CapnBry/HeaterMeter/eagle/readme.txt

KiCad Files for HeaterMeter PCBs
Base - HeaterMeter Base Board (v4.3.5)
LCD - HeaterMeter v4.3 LCD and Button backpack board (v4.3.5)

-- Obsolete EAGLE files or of Limited Purpose --
HeaterMeterPI.brd / sch / png - HeaterMeter v4 board and schematic for standalone or RaspberryPi (up to v4.3.4)
HeaterMeterLCD.brd / sch / png - HeaterMeter v4.3 LCD and Button backpack board (up to v4.3.4)
RfAddon.brd / sch - HeaterMeter v4.2.4 RF addon board needed if lmremote / IT+ reception is desired
LMRemote.sch - Example RF Remote probe transmitter schematic (not used in v4.3)
