CapnBry/HeaterMeter/openwrt/package/8192cu/README

This is a custom OpenWrt package for the rtl8192cu wireless adapter.

Tested models:
Edimax EW-7811Un
Rosewill RNX-MiniN2

Patches are based on the v3.4.3_4369 driver source from realtek.
