CapnBry/HeaterMeter/arduino/SMUSHI/images/background.png

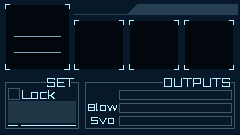
arduino/SMUSHI/images/background.png
