CapnBry/HeaterMeter/eagle/HeaterMeterLCD.png

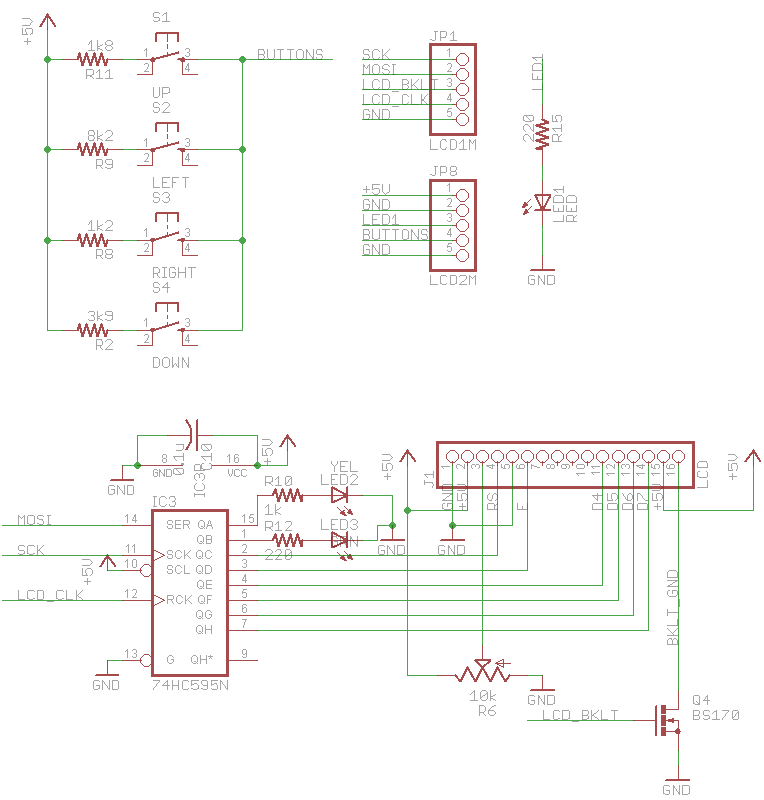
eagle/HeaterMeterLCD.png
