CapnBry/HeaterMeter/eagle/HeaterMeterPI.png

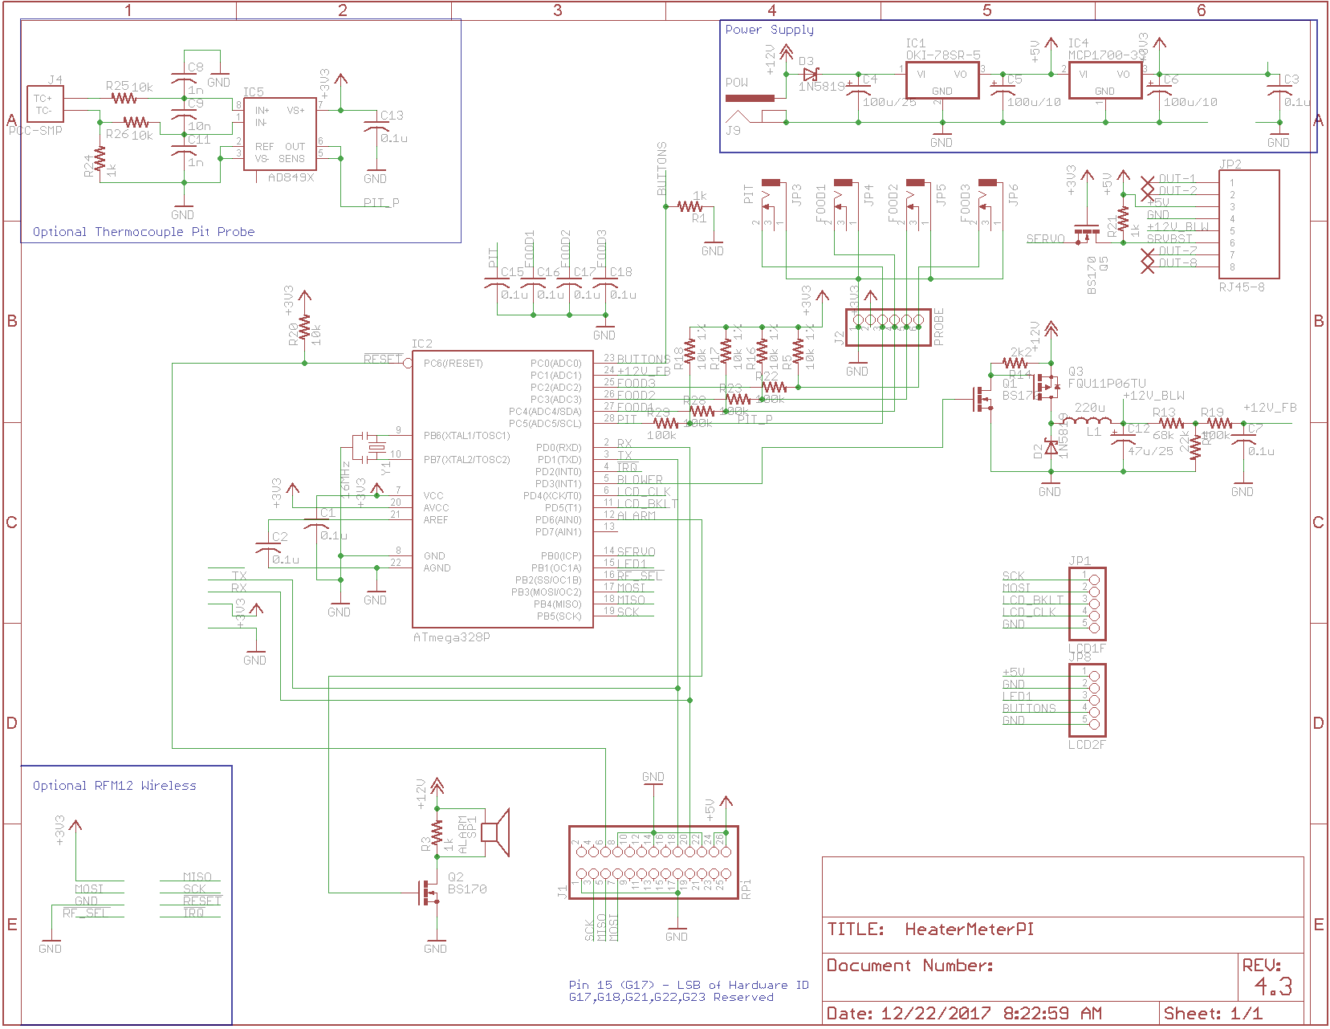
eagle/HeaterMeterPI.png
