CapnBry/HeaterMeter/eagle/LMRemote.png

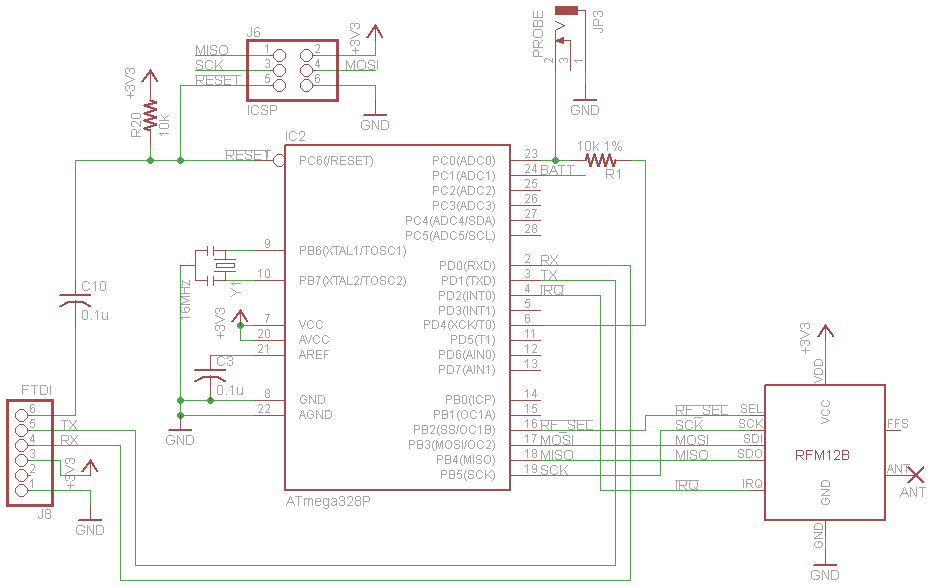
eagle/LMRemote.png
