CapnBry/HeaterMeter/openwrt/package/linkmeter/htdocs/luci-static/resources/boxy-color.png

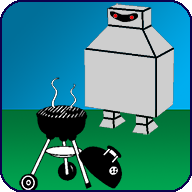
openwrt/package/linkmeter/htdocs/luci-static/resources/boxy-color.png
