CapnBry/HeaterMeter/openwrt/package/linkmeter/htdocs/luci-static/resources/fire.png

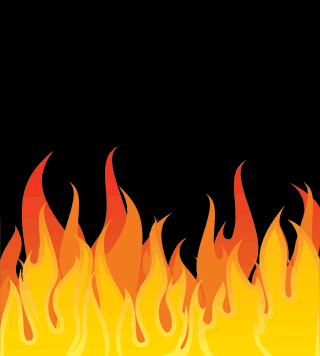
openwrt/package/linkmeter/htdocs/luci-static/resources/fire.png
