CapnBry/HeaterMeter/(threads)

Thread 14 (2015-03-02):

Switch not available

mcrabb, 2015-03-02:
The 4-way button listed in the Mouser kit, ALPS SKQUAAA010, has been discontinued and is no longer stocked at Mouser.  The recommended replacement part is 2.5mm smaller and has no prongs for mounting.  The only other place online that I've been able to find the original in the US (Newark seems to be having issues with their website so I can't check there) is onlinecomponents.com and they have a $30 order minimum.

Closed 2016-01-11.

Thread 15 (2015-06-11):

NEW fan door

marcoemanuelecocco, 2015-06-11:
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

I've find a new metod to use the fan without barrel.

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

marcoemanuelecocco, 2015-06-11:
capsula_1.01.sldprt
download the object and rename as above
https://cloud.githubusercontent.com/assets/12845292/8107309/ab2046cc-1048-11e5-82f5-0d0578ec82c9.jpg

capsula_1 01 stl
download the object and rename as above
https://cloud.githubusercontent.com/assets/12845292/8107395/21901918-1049-11e5-8d4b-a9d55baa481d.jpg

CapnBry, 2016-01-18:
Looks neat but this is better posted at the user forums
http://tvwbb.com/forumdisplay.php?85-HeaterMeter-DIY-BBQ-Controller

Closed 2016-01-18.

Thread 16 (2015-09-09):

What's the point of the 100k resistors between analog inputs and voltage divider circuits?

bgentry, 2015-09-09:
Hi there,

I apologize in advance for using Issues as a way to ask this question.

I've been learning a lot from HeaterMeter and I'm working on designing my own thermistor sensor board. I noticed that in the v4.2 hardware design, a set of 100k resistors was added between the microcontroller's analog inputs and the standard thermistor voltage dividers.

I've spent a lot of time searching for find some kind of explanation for this kind of circuit design, but all I can find are examples of the simple voltage divider design that was used prior to hardware version 4.2.

Can you explain why these resistors were added and what they do for the circuit?

Thanks!

shmick, 2015-09-09:
The 100k resistors are the R in the RC filter. The 4 x 0.1u caps are the C in the RC filter.

Take a look at the schematic here http://capnbry.net/linkmeter/pcb/hm-4.2/HeaterMeterPi.png

The caps are shown right above IC2 in the schematic.

bgentry, 2015-09-09:
@shmick thanks, I had forgotten about those :)

Closed 2015-09-09.

Thread 25 (2015-12-02):

Is there support for Pellet auger

mvogt99, 2015-12-02:
I looked at https://github.com/CapnBry/HeaterMeter/wiki/Blower-and-Servo-Wiring and am wondering if the Servo mentioned was intended to control a Pellet auger? ... or how support for an auger (including into the PID functionality) could be added?

CapnBry, 2015-12-02:
Nope, that's actually something completely different. The pellet auger is either a stepper motor (i.e. the controller sends a single pulse to advance the auger X degrees) or a geared motor (i.e. the motor moves continuously just very slowly due to high gearing). The servo code is for driving a hobby servo, which operates by moving to a position specified by the duration of a continuous pulse. They're fundamentally different and not interchangeable.

I can't think of a way HeaterMeter would control the auger but you might want to [ask on the forums](http://tvwbb.com/forumdisplay.php?85-HeaterMeter-DIY-BBQ-Controller)

mvogt99, 2015-12-02:
Thanks for the quick reply... as far as hw goes, I'm guessing something
like this might work... https://www.pololu.com/product/2755 ... just need
to incorporate it into the PID algorythm.  Btw, I believe the auger motor
is a gear motor.

I'll inquire on the forums.

Thanks again,
Mike

Mike Vogt
mvogt99@gmail.com

On Tue, Dec 1, 2015 at 9:27 PM, Bryan Mayland <notifications@github.com>
wrote:

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

Closed 2015-12-02.

Thread 35 (2016-10-08):

wifi config persistent?

Jennnifers, 2016-10-08:
Is there a way to make the wifi settings persistent after boot?

I followed the instructions here:  https://github.com/CapnBry/HeaterMeter/wiki/HeaterMeter-4.x-Software

I can connect to my wifi by editing the config file every time I boot, but I'm looking for a persistent wifi configuration.

I've been through the "Wireless Client Setup via Web Config step-by-step" multiple times but the config never sticks there either.

CapnBry, 2016-10-08:
The configuration should persist between reboots, This generally indicates that there is a problem writing to the SD card in general, and no information is being saved permanently. You should check under Status -> Kernel Log in the webui and see if you're getting errors at the bottom about "ext4", "extfs", "mmc0", or the like which are causing the filesystem to be "remounted read-only". If you are then you can try re-imaging the SD card to see if it goes away, or trying a different SD card which might be more compatible with the Pi, they are somewhat finicky.

If you need more assistance, I'd recommend creating a thread on [the forums](http://tvwbb.com/forumdisplay.php?85-HeaterMeter-DIY-BBQ-Controller).

ChinookTx, 2017-04-22:
I'm having the same problem as @Jennnifers.  I have so far tried 3 micro SD Cards of various sizes, 2 different ways of programming the cards (from linux and MacOS).   Further to this, I have tried a Pi A+ and a Pi Zero.  I cannot get ANY to keep their settings.  This sounds to me like more than a simple glitch with SD Cards??

Jennnifers, 2017-04-23:
I never did solve the problem.

In fact, now it won't stay connected to wifi for more than a second or two after reconfiguring it.

I've gone through 4 SD cards, 2 usb wifi adapters in the heater meter, and 3 different wifi routers.  Pretty sure it's not a hardware problem at this point.

CapnBry, 2017-04-23:
I can't conceive how this could possibly happen if the configuration changes are applied. Undoing configuration would be a ridiculously complicated challenge if I wanted to do it on purpose because changing the configuration is destructive, there is no backup kept once you hit "Save and Apply". Did you ever look in the kernel log for any indicators that the filesystem was experiencing errors?

>  You should check under Status -> Kernel Log in the webui and see if you're getting errors at the bottom about "ext4", "extfs", "mmc0", or the like which are causing the filesystem to be "remounted read-only".

You can also try [downloading a preconfigured snapshot image](https://heatermeter.com/dl/) with your wifi settings baked in, which may work around the issues you're experiencing, but I don't know how I'd even make HeaterMeter do what you're experiencing if I tried.

ChinookTx, 2017-04-23:
I can confirm I wasn't getting any unexpected messages about the sd card in the kernel logs.

I gave a try to the preconfigured image... It worked on the first try on my Pi A+ (which I never got to work previously).  Now I'm really scratching my head.

CapnBry, 2017-04-24:
You and me both! Like I've said, I know a whole bunch about the underlying systems and really can't put together how it is possible to *not* save the network settings across reboots. Great to hear the preconfigured image works though!

ChinookTx, 2017-04-24:
Another odd thing I notice.  The one "normal" image I got to work on my Pi Zero gives me really bad network performance:

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

The one you suggested with burned in settings gives proper ping times:

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

Images appear to be based on different OpenWRT releases, so I suspect something has changed in the firmware that makes it behave better.

Anyway, it works for me now, so unless you want me to try something specific, I'll leave it alone.  More smoking, less tweaking ;-)

CapnBry, 2017-04-30:
I was doing some testing with the old software today and the wifi configuration would reset on every reboot, After some digging I remembered I fixed this issue a while back in the snapshot. What is happening in my case was there was no HeaterMeter board attached so the initialization of the linkmeter package would never complete successfully on boot so OpenWrt would run the initialization again on the next bootup which would reset the wifi back to default. This would also be the case if a HeaterMeter board was attached but not functional, most the network settings would reset each boot until a HeaterMeter was found.

This is fixed in the snapshot firmware, and maybe that's what you folks were seeing? The evidence is that if you ssh into the device, do `ls /etc/uci-defaults/linkmeter` and that file is there, that's it. But if you've moved on there's no reason to look into it any further.

Jennnifers, 2017-04-30:
Thanks CapnBry!  I haven't exactly moved on - I've been using it without any other issues besides the wifi connection.  Would be convenient if I didn't have to get up and go outside to check on it though. :)

I'll take a look and see if there's something wrong with the connection to the heatermeter board when I get a chance.  Wouldn't it just not work without a good connection to the board though?

If I don't see the linkmeter file, I'll try the preconfigured snapshot image solution instead.

ChinookTx, 2017-05-04:
Thanks for the reply @CapnBry.  I have some spare time today and I'll try a few scenarios.  It might just be that (not having the Heatermeter hooked up).  I initially tried to get the pi going first without the Heatermeter.  Then was a mix of having it on to try and see what IP was reported and off when getting fed up and moving to another Pi.  Rewash, repeat ;-)

Closed 2016-10-08.

Thread 36 (2016-10-10):

Other SMS Provider

technofetishism, 2016-10-10:
When selecting other SMS provider, the configuration box shows up within the email notifications section.

This behaviour is evident in the current snapshot build.

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

technofetishism, 2016-10-10:
This issue also affects configuring pushbullet

CapnBry, 2016-10-10:
I can confirm this is a bug. I've got a fix coming in the next snapshot, thank you for reporting! I'll close the issue once the fix is in git.

CapnBry, 2016-10-20:
Should be fully resolved by 339fcb108bcba8351f94f18616b5b1df51421d98 and the new snapshot release. Thanks for your report!

Closed 2016-10-20.

Thread 39 (2017-12-27):

Port to other hardware platforms

brianjmurrell, 2017-12-27:
Hi.  I have been going down the path of building a temperature controller for my Kamado smoker/grill.

I have the hardware built for a simple single probe design so far with a NodeMCU board, a Maverick probe and a randomly chosen blower.  The NodeMCU only has a single ADC, hence the single probe (at this moment).  Some additional components in the way of an ADC multiplexer could resolve that but for the moment I'd just be happy to have pit temperature control.

Your project looks like it's had a lot of time spent on the intricacies of PID implementation, etc. which I feel like I would be foolish to try to re-invent rather than "standing on the shoulders of giants" and leveraging.

Anyway, to get to the point, would PRs for porting to new hardware platforms be welcome to this project?  Would you be willing to land PRs for such alternate hardware platform ports?

CapnBry, 2017-12-27:
I'm not sure what code would be reusable between the platforms. I'm pretty familiar with the ESP8266 platform, having coded for it for a few other projects around the house. The PID algorithm itself isn't very complex, and the majority of the code in there is for handling the ADC running continuously and oversampling/decimating the readings which would not be applicable to the ESP. The on-device menuing system isn't very complex either. All the rest of the code for monitoring, recording, graphing, discovery, and notifying is handled on the Pi in a mix of different languages and systems that would not translate at all. Last I'd heard, the ESP core doesn't have hardware PWM either which would make timing difficult for the fan buck converter and servo pulses (although the LCD backlight would probably be fine in software).

There [is a project](https://github.com/nailbuster/EspressModuleHM) where someone connects the output of the HeaterMeter board to one of the cheap ESP-01 modules and pushes the data off to the cloud which is sort of the middle ground between the two.

In short, I don't think it is feasible that there would be much code reuse between the platforms and the amount of effort to make that code cross compatible would probably be so large that it wouldn't be worthwhile to spend the time on it. I do appreciate low cost and relative power of the ESP8266 modules (I actually soldered one into something yesterday) but they do fall short on requirements for this project. If you'd like to go into it in more detail, you can start a discussion [on the forums](https://tvwbb.com/forumdisplay.php?85-HeaterMeter-DIY-BBQ-Controller) and also search there for previous discussions about the ESP platform.

Closed 2017-12-27.

Thread 41 (2018-06-23):

Hacking linkmeterd

chrissnell, 2018-06-23:
Hi @CapnBry.   Just ordered my HM hardware and I'm super excited to test this.

I've been digging through the source tree with an eye on doing some hacking.  My particular interest is modifying the linkmeterd service to support other control mechanisms like [gRPC](https://grpc.io/).   I'm also not a huge fan of the tight coupling with OpenWRT and I was looking into what it would take to tease linkmeterd away from LuCi.  It appears to be pretty tightly coupled.

So, I started thinking about rewriting linkmeterd in Go, completely decoupled from any OpenWRT dependencies.  There's a couple of things that I want to better understand:

- **Architecture** - I'm trying to understand how everything communicates.  It looks like you have a web app front end that speaks JSON to the linkmeterd service running on the RPi.   This service appears to communicate over serial to the Arduino for command/control/monitoring.  There seems to be a [client](https://github.com/CapnBry/HeaterMeter/blob/master/openwrt/package/linkmeter/luasrc/lmclient.lua) that talks to linkmeterd over a UNIX socket but I'm not sure what the client does.  Are there docs somewhere that will explain how these things all fit together?

- **The linkmeterd <---> Arduino protocol**   Do you have any documentation for this anywhere.  Looking at your Lua source, it looks like [the commands are defined in `segmentMap`](https://github.com/CapnBry/HeaterMeter/blob/master/openwrt/package/linkmeter/luasrc/linkmeterd.lua#L987-L1013), but I might be confusing this with commands sent over the UNIX socket from the control utility.  Would you mind helping me grok this?

Thanks!

CapnBry, 2018-06-24:
Hi Chris! The issue tracker isn't really the place for a discussion, so after this message if you want to continue discussion, please [take it to the forums](https://tvwbb.com/forumdisplay.php?85-HeaterMeter-DIY-BBQ-Controller).

linkmeterd isn't very coupled to OpenWRT at all. It does pull in some of their libraries but those should build on any platform and it would be silly to rewrite them (luci.sys, nixio, and jsonc). It does use UCI to pull in the configuration but honestly that could all be hard coded into the source if needed. It does get more complicated if you start looking at notifications and whatnot because those rely on external linux utilities.

The thing that is tightly coupled is the HTTP interface, which runs the luci framework for generating the web pages. That would all need to be rewritten if you wanted to pry it out of OpenWRT.

The architecture is not very complicated. The atmega spits out data in serial sentences similar to GPS NMEA sentences. It can also receive commands via the keywords found in hmcore.cpp's handleCommandUrl, which are only 3: /set, /reboot, and /config (dump all config). The linkmeterd listens for those and writes them into the RRD file (and plugins and alarm notifications) and publishes them to any connected clients through a UNIX socket. There's lmclient which is just a utility for sending/receiving messages over the UNIX socket. The system there is simple fire-and-forget commands, or subscribe to the status updates (in JSON format).

The serial protocol is simple and segmentMap holds all the known sentences. The first group ($HMxx) are the sentences the atmega sends out, The second ($LMxx) are commands expected to be received over the UNIX socket.  The 2x commented out values are UNIX commands accepted by the plugins, and the final one is the command to register a listener which gets the JSON data streamed. All are just `COMMAND,param,param,param,...`

I don't know what your plans are if you're trying to get rid of OpenWRT, but it would probably be less work to just write a new daemon from scratch that just takes the serial data and puts it into your database of choice using the segmentMap's `$HMxx` list as the requirements for what sentences to expect from HeaterMeter. None require any responses so it is safe to just ignore what you don't want.

Closed 2018-06-24.

Thread 42 (2018-07-20):

Proportional on measurement

mattncsu, 2018-07-20:
Have you considered implementing [proportional on measurement](http://brettbeauregard.com/blog/2017/06/introducing-proportional-on-measurement/) from the [Arduino PID library](https://github.com/br3ttb/Arduino-PID-Library/blob/master/PID_v1.cpp) to reduce or eliminate overshoot since smoker temperature control is an integrating process?  It doesn't appear to be too difficult to implement, it just adds one extra term to the PID equation.

```
bool PID::Compute()
{
   if(!inAuto) return false;
   unsigned long now = millis();
   unsigned long timeChange = (now - lastTime);
   if(timeChange>=SampleTime)
   {
      /*Compute all the working error variables*/
      double input = *myInput;
      double error = *mySetpoint - input;
      double dInput = (input - lastInput);
      outputSum+= (ki * error);

      /*Add Proportional on Measurement, if P_ON_M is specified*/
      if(!pOnE) outputSum-= kp * dInput;

      if(outputSum > outMax) outputSum= outMax;
      else if(outputSum < outMin) outputSum= outMin;

      /*Add Proportional on Error, if P_ON_E is specified*/
	   double output;
      if(pOnE) output = kp * error;
      else output = 0;

      /*Compute Rest of PID Output*/
      output += outputSum - kd * dInput;

	    if(output > outMax) output = outMax;
      else if(output < outMin) output = outMin;
	    *myOutput = output;

      /*Remember some variables for next time*/
      lastInput = input;
      lastTime = now;
	    return true;
   }
   else return false;
}
```

CapnBry, 2018-07-20:
Interesting. I'll give it a try, but the major problem I see with it is that there's no (P * Error) contribution. This means if you set the setpoint to 225, and the current temp is say 80, the output will be 0% which means there will be no way to get it to 225F. It is relying on the Isum to build up to drive the output, which means the Isum will ramp up to 100% until the temperature is reached which then leaves us in the same place.

In the short example graphs shown on that webpage, it isn't a problem because the output is still ramping up when it reaches the setpoint. In a longer term test, say a sous video setup, their Isum (labeled I-term there) would reach 100% as well if the heatup time was a sufficient number of PID cycles in the future. This value is cumulatively reduced by the Derivative * P, and instantaneously reduced by Derivative * D which seems very redundant.

Still, it isn't difficult to make a test to try it out although I feel like there's a reason why you don't see this in commercial PID software-- because the D term is already there for this exact reason.

mattncsu, 2018-07-20:
The author goes into a little more detail [on this page](http://brettbeauregard.com/blog/2017/06/proportional-on-measurement-the-code/):

> Proportional on Measurement provides increasing resistance as the input changes, but without a frame of reference our performance would be a little wonky. If the PID Input is 10000 when we first turn on the controller, do we really want to start resisting with Kp*10000? No. We want to use our initial input as a reference point (line 108,) the increase or decrease resistance as the input changes from there (line 38.)

TheDogee, 2018-07-28:
I was intrigued by this as well, and from the description sounds like it would work well. Implemented a couple variations with little success. Not sure if it was a coding problem or a tuning issue, but I ran out of patience because it takes so long to test changes on the WSM. It seemed to get wound up too easily or was too ineffective. The way it is implemented in the PonM library, the P and I terms get combined which makes it tough to observe.

CapnBry, 2018-08-09:
Ooh that's a good link, I just spent the last hour reading both chapters looking for ideas. The solution presented just adjusts the setpoint further away from the current input to accelerate the integration which I don't think will help because we've already saturated the Isum at 0% (our integral lower limit is 0) and due to the `D` being in parallel, we can't remove its contribution so there's no way to fully turn off the output. One could write a special case where D is only allowed to contribute when the error is 100/D but that then messes with startup because the controller won't start backing down until it gets within that range which could cause further overshoot.

Also reading that paper, I'm not sure what the heck the Arduino PID code is doing. P on M isn't integrating! PonM _should_ be instantaneous, He mentions it in his [second article](http://brettbeauregard.com/blog/2017/06/proportional-on-measurement-the-code/), in the second pass section but I can't figure out why he made that leap. P on M is supposed to guesstimate the proper output for a given setpoint so if we know ambient is 80 and our target is 225, PonM is supposed to set the output to P * (225-80). If we know it generally takes 30% power to maintain 225, we'd set `P` constant to 30 / (225-80)= 0.207. A 300 setpoint would then get 0.207 * (300-80)=45.54% output and then rely on the Isum to ramp up. It doesn't produce the same response to do PonM of 0.207*(set-start) vs 0.207+0.207+...+0.207 until you reach the same output value. For one, the integration relies on the temperature changing which it will never do if there's no change in the output. The faster the temperature changes, the faster the output will increase too. That's just nutters and contrary to what he was initially trying to achieve, which is a resistive force.

Now that I've read all this, I'm definitely going to back out the changes. While PonM is a thing, having it slowly ramp to that value relying on an external contribution to actually initiate the change is not sound and then applying it in reverse to the Isum is just baffling.

mattncsu, 2018-08-09:
Sorry it didn't work out. It seemed like a good idea reading those posts. At least we all know a little more about PID theory now...

CapnBry, 2018-08-09:
Too right we do! It was educational in that I've learned some new terms, like I didn't know what we had was an "independent gains (parallel form) proportional-on-error derivative-on-measurement" PID controller.

I also was able to find sort of a bug in the code in that the Isum could theoretically jump to a very large value of the temperature changes very rapidly but the controller isn't saturated yet. I'll keep that change. I'll also probably re-add PonM as an option in the more traditional sense, where it contributes just a straight P*setpoint so people can play with that if they like. I might also change the antiwindup code to operate always in the proportional band rather than on the last output? Not sure if that would make a mess of anything.

mattncsu, 2018-08-09:
@br3ttb Any thoughts?

CapnBry, 2018-08-11:
Well a couple dozen hours of reading and testing and yet another implementation. I've also read some papers on 2DOF PID controllers and unsurprisingly they all use a negative sign on the control variable.
[Two-Degree-of-Freedom PID Controllers by Mituhiko Araki and Hidefumi Taguchi](http://ijcas.com/admin/paper/files/401-411.pdf)
[Two-Degree-of-Freedom PID Controllers Structures by V.M. Alfaro and R. Vilanova?](https://www.springer.com/cda/content/document/cda_downloaddocument/9783319282114-c2.pdf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)

I get a bit lost reading these papers when they jump right into using `s` which I have to assume is a factor of a Laplace Transform and it has been decades since I learned how to use those. What I've got now is from the textbook you linked where they do the "linear combination of PonE and PonM" formula 2.3(27). Right now I have it hard-coded with a lambda of 0.4, but due to how it works, I am going to make it a tunable parameter as well because the same code can work with the our old style PonE (lambda 1.0), support pure PonM (lambda 0.0), or roll your own mix. I can't make it tunable just yet because there would be no UI for it (the webui needs to support it) and I can't make changes there because I'm in the throes of converting it **back** to OpenWrt from LEDE. So for now, use a negative P value to indicate you want to use this PonMonE code (but the value is inverted by the code so -1 => 1).

Because the P contribution is always negative in this configuration, the limit on the integral sum needed to be increased so the output can reach 100%. Without this, the max output would be lower the higher the setpoint is, since `I` could only contribute 100%, and at steady state, `P` is -0.2 \* setpoint \* Pconstant. Max integral sum is therefore 100%+0.6\*setpoint\*P which should allow 100% output at setpoint if needed. The lowerbound integral sum is still 0.

In bench testing, it had a pretty good setpoint response with little overshoot and a llllooooong oscillation period. The disturbance response however was not great, although it could be because I don't have optimal coefficients. In grill testing, I saw a lot of overshoot when achieving setpoint. With this system the Isum always maxes out on startup, and the P contribution is roughly constant so the controller doesn't back off quickly as it passes the setpoint. This is mitigated by a more managed approach to the setpoint due to being almost entirely controlled and limited by the `D` contribution retarding the output throughout startup.
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

In any case, I've uploaded a snapshot AVR firmware with the current code to the online repository so it can be tried out. I used P,I,D = -0.4, 0.10, 12. I am concerned with the P value being on measurement meaning that, say 400 degrees is -96%, and Isum will range from 0-196% but the D term's range is always fixed due to being on Error.

TheDogee, 2018-08-19:
I tried the snapshot for a short cook today of some poppers with my normal tuning parameters P=3,I=0.008,D=5.  I have a MicroDamper with fan on WSM 18.  I started with a half chimney of lit coals over unlit, started with fan on startup at 50% but change it eventually to 100% because it was not getting there.  I negated the first term to -3 to try PonM.  It behaved very strangely, seemed to get all wound up getting to setpoint (which took a long time, probably my fault, not enough lit?), but then as soon as it went slightly over the setpoint of 225, it abruptly went to zero and stayed there.  Temp fell so much that the lid open detect went off, and I gave up and changed the sign on P back to positive to go back to normal mode (around 7:45 on graph).  Any idea what happened here?  Is it a bug, or operator error?
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

I had the "P" window up at the time where it went to zero and both P and I had not drastically changed, but both were large.  P was around -330, I was about 230.

CapnBry, 2018-08-19:
Thanks for testing, however, you can't just invert the sign on the P value and switch to PonM. It's a whole different game and "3" is about 10x too high I think. The "I" for my test system was also 5x the PonE version, and the "D" is about 2x my normal PonE value.

It definitely is strange that it cut off roughly as it would have been getting close to starting to control though. There's definitely something weird happening there, I'll have to try your values and see if I can reproduce. Something might be overflowing internally due to the larger P than expected. Maybe try it with PID= -0.3, 0.08, 10 (which would be -1/10, 10x, 2x your PonE values).

TheDogee, 2018-08-20:
Thanks for the reply. Makes sense based on the math that my values are off. The Android pid guy had  suggested at using the same tuning values in his article, but that does not see like it will work. I will give it another go next time with more reasonable values.

TheDogee, 2018-09-02:
Here is take 2 with the parameters you suggested.  It went slightly better, but still had problems with the fan rapidly cutting out after overshoot.  What basically seems to happen in that the I term hit its positive maximum before hitting setpoint, and then once overshoot occurs, it starts decrementing rapidly.  The "D" term seems to make things worse.  The P term does almost nothing to correct.  Note that in the graph the first "lid open" was real, the next two were not.  At 12:45 I gave up and went back to PonE.
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

pokeymud, 2022-05-20:
Whew,
I just wanna shoot out a quick thanks to the discussion on this subject. I'm not a heatermeter user, but this is the only place I could find any coherent discussion on the arduino PID's proportional-on-measurement feature, and what it is /supposed/ to be doing.

As a note, the implementation in the OP is from an early version of the library, which is just plain wrong/not PonM - it seems to want to integrate the differential term to achieve a similar effect to real P on M, except when your input is higher than the set-point, the accumulation reverses. This gives that implementation the 'resistive' force characteristic that the author describes, but isn't actually P on M and doesn't behave like it!

The implementation in the current version has been fixed to to be equivalent to 'pure' P on M (lamba = 0). In fact the implementation in the blog linked already is updated with the fix, but the author continues to talk about it incorrectly as a 'resistive' force, which is a big part of my confusion on the subject!

Lastly in the spirit of accumulated knowledge, and helping out newbies like me: I found the wikipedia section on proportional and derivative action on measurement demystified the terms in the paper shared a bit because the article as a whole is self-contained and defines all the terms used in the formulae: https://en.wikipedia.org/wiki/PID_controller#Basing_proportional_action_on_PV

Thanks again!

Thread 44 (2018-08-19):

Access for historic data currently not possible because of CORS errors

iGod42, 2018-08-19:
It is currently not possible to access the /lm/hist endpoint because of CORS errors.
While the same issue is fixed with PR #43 for endpoints under /lm/api/, /lm doesn't have a setting to enable CORS.
I'm not sure if adding CORS would be correct there, it seems like the endpoint should be moved (or aliased) in /lm/api.

CapnBry, 2018-08-19:
You're right about this and #43, good catch on these. However, I noticed a couple of weeks ago that API write access doesn't work at all, which is a major blocker to fixing anything else. Are you not seeing that as well?

The problem is that luci/OpenWrt/LEDE doesn't have a spec for how the authentication scheme is supposed to work, with the only clue being in understanding how the source works. About 6 months ago (maybe more) they reorganized all the code in the dispatcher auth which prevents controllers from rolling their own session management which is how the apikey works. IIRC it (the dispatcher) is in a very weird state right now, which seemed to almost make creating your own auth impossible. I'm in the middle of updating everything back to OpenWrt since LEDE re-merged though so I can't do anything until that is done. They've included my squashfs stuff for our target but at the same time made some changes to it to make it incompatible with our current build. There's also a ton of hand testing for regressions because there literally a thousand changes between our last LEDE pull and OpenWrt HEAD.

I will take a look at this as soon as I'm done with that. (oof so much to do). I didn't initially move /lm/hist over due to the formatting, all the /lm/api stuff is JSON format only so I was planning on adding a new endpoint with the data in the right format so it won't have to be parsed on the client side any more. The API hasn't been a big priority though because there's almost nobody using it. I appreciate you finding these things though and I might have a chance to get some code time this week.

robertspari, 2018-08-19:
I haven't tried writing yet to be honest. I think I successfully placed one call in Insomnia but I might be mistaken since I initially set out to create an API that works on plain old Raspian. It could have been that too.

What I have done is have a look at the authentication logic and I'm not sure if the API key is really a great option.
Here's why. I started to create a responsive page (that might evolve to a progressive web app at some point) for two reasons. 1. I'm not the biggest fan of the Luci user experience, especially on mobile. 2. I've been supplying HeaterMeters to my friends and family, not all of which are computer-literate.
For them it would be great to have a zero-config way of just opening an app/web page that checks the local network for their unit and gives them the possibility to change the set point or other settings. For this to work though, they'd have to get the API key and supply it to the app. I haven't checked if they are randomly generated, but I assume they are, so each of them would have to do that.

Since there is no real sensitive data that we'd have to protect from being accessed, I think that basic auth, or even no auth at all, would be fine.

It sounds like you have a lot of work to go through, so for the issue at hand there's no rush at all, as I've got local workarounds. As for the authentication: If you really have to re-work stuff there maybe keep that in mind. Or if there's an easy option I'm missing, please let me know

minorOffense, 2019-05-20:
Any chance the CORS patches code can be rolled into a release? I’m building a VueJS web app to replace the stock cook UI (just reading data for now, eventually to write data and replace those pages too). I worked around it by breaking the cors security settings in Firefox. But it would help a lot if the app had the headers in place.

CapnBry, 2019-05-20:
Ah son of a... I thought I had integrated this already. I was wondering why I had left the ticket open and I thought it was just to remind me that the luci dispatcher was a bit weird and needed a new look.

Building a new snapshot right now with CORS enabled on /lm/hist and it will be up in a few minutes at https://heatermeter.com/dl/

minorOffense, 2019-05-20:
Excellent thank you very much.

Closed 2019-05-20.

Thread 45 (2018-09-04):

HeaterMeter.com is offline

TheGorf, 2018-09-04:
Can't download any of the required stuff from the heatermeter.com site because it's timing out. Should that be moved to GitHub?  [The instructions from the wiki page](https://github.com/CapnBry/HeaterMeter/wiki/HeaterMeter-4.x-Software) show that I should be going to heatermeter.com/dl to download stuff. But https://downforeveryoneorjustme.com shows the site is offline from multiple locations.  Can we get the downloads from somewhere else?

CapnBry, 2018-09-04:
Hi, thanks for reporting this. I'm not sure why, but the VPS server keeps shutting off. I've got a ticket in to support to figure out why it just shuts off randomly (not shutdown, just like powered off). It started Monday morning.

There's no other way to get the firmware. It's sort of built on the fly by the server and there's a bunch of other light processes that are part of the download and device registration so there's more than just a static file involved. It hasn't been a problem so far as the hosting service has done an amazing job with the uptime, and the volume of HeaterMeter traffic is so low that paying for redundant servers doesn't make much sense.

It has been up for over an hour now, which is a new record for this week so maybe the support people have gotten it straightened out but I haven't heard anything yet.

shmick, 2018-09-04:
Might be good to post the latest LM and HM code to https://github.com/CapnBry/HeaterMeter/releases  ?

CapnBry, 2018-09-04:
I'll consider that for the next release, yeah.

Phortieteaux, 2018-11-17:
Hi Bryan -

Looks like https://heatermeter.com/ is down again - connection is timing out.  Is there still no path to manually download / configure?

Thanks -
Jason

CapnBry, 2018-11-17:
I posted about it [on the forums](https://tvwbb.com/showthread.php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), but the system is in emergency downtime until tonight.

Phortieteaux, 2018-11-17:
Ah ok, thanks!  I was just able download the firmware directly from the static IP at https://tvwbb.com/showthread.php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, so thought it might be something with DNS.  Thanks for the quick response - and for Heatermeter...  anxious to see if I soldered everything correctly :)

CapnBry, 2018-11-17:
No worries, it looks like it just came back up a few minutes ago but I haven't gotten the all clear that the migration is complete from the host yet. Glad you were able to download the image!

Closed 2019-05-20.

Thread 47 (2019-03-24):

Export CSV metrics

hari-bo, 2019-03-24:
From the HeaterMeter BBQ Control panel you can export the CSV file.
I cannot find in the documentation how to interpret this values.
The reason I am asking this is that I want to import this data into a graph with time lapse and temperature.

For example:
```
1553424480,nan,14.45652173913,nan,nan,nan,0
1553424540,nan,12.35,nan,nan,nan,0
1553424600,nan,12.236666666667,nan,nan,nan,0
1553424660,nan,12.506666666667,nan,nan,nan,0
1553424720,nan,12.601666666667,nan,nan,nan,0
1553424780,nan,12.511666666667,nan,nan,nan,0
1553424840,nan,12.773333333333,nan,nan,nan,0
```

CapnBry, 2019-03-24:
That is a very valid question! I never realized I had forgotten to add that to the documentation (or even include a header in the CSV file apparently). I'll work on that this week when I get a chance but here's the info:

* UNIX timestamp in UTC
* Setpoint
* Probe 0 temperature (control probe)
* Probe 1 temperature
* Probe 2 temperature
* Probe 3 temperature
* PID output percent (if zero or positive), or lid cooldown remaining (if negative).

All values are the average value recorded over the time period. I see that the first field jumps by 60 each line, so you're looking at 1 minute averages. Note that there are various scales for the data depending on how long the database has been running or what scale you have selected, 10 seconds per period (1 hour of data), 60 seconds (6 hours), 120 seconds (12 hours), or 180 seconds (24 hours).

hari-bo, 2019-03-24:
Thanks! Is there an way to convert the UNIX timestamp to the lead time of the session with the Heatermeter? Because I want to run several sessions with different fuel to compare them with an graph.

CapnBry, 2019-03-25:
Just subtract the timestamp of the first row from all the others. If the data extends all the way through the selected time scale, that won't extend to the beginning of the actual session though since, for example, you're only viewing the most recent hour of data.

HeaterMeter doesn't track the time of session start in any way, so the way I do it for the graphs is to take the full scale CSV (24 hours) and look for the first line that contains an actual number (not a nan). Since we know that each line represents 180 seconds you can tell roughly when the session started from that (now - 24 hours + 180 seconds per line of nans)

CapnBry, 2019-03-26:
The new snapshot firmware includes a header line in the CSV export. The [documentation](https://github.com/CapnBry/HeaterMeter/wiki/Accessing-Raw-Data-Remotely#historical-data) has also been updated with this information. Thanks for bringing it to my attention.

Closed 2019-03-26.

Thread 48 (2019-07-18):

compatibility with MQTT server / home assistant

pilot1981, 2019-07-18:
Hi,
it's possible have temperature value in home assistant using MQTT server?

it could be useful to have all data also when you are outside house...in long time BBQ...

CapnBry, 2019-07-18:
Actually it is weird you'd bring this up, because I just talked with someone else a couple of weeks ago about streaming the data to other systems and I wondered why I didn't already have MQTT built into the HeaterMeter. It is on me todo list now, except it will be a MQTT client, not a server.

pilot1981, 2019-07-19:
thanks for reply.

it's possible to repair link to google photos in wiki section?

CapnBry, 2019-07-19:
It is non-trivial to fix them, since Google Photos doesn't allow linking photos. I've looked at trying to replace them with another image host that allows linking to photos, has albums, and will autogenerate thumbnails in arbitrary resolutions but I couldn't find one easily so figured it wasn't worth the time to stand up and maintain my own image hosting.

The photos are all still there in the new Google Photos albums, but the individual hotlinks for each photo doesn't work.

pilot1981, 2019-07-19:
Ok, thanks.

App HeaterMeter on Apple App Store is yours?

CapnBry, 2019-07-19:
I've actually not heard of that one, but it looks nice. There's also Pit Meter and Pit Droid (for Android) but I'v e not worked on any of these, they are community-created.

kaybee335, 2019-08-20:
I'll add my vote to adding an MQTT client! Now that I have just finished building my unit I was about to write a Python script to scrape that info and publish it to my MQTT broker.

CapnBry, 2019-08-20:
I was hoping to get it in this week but it needs webui to be able to configure it, upload certificates, etc, so it is a bigger project than just getting the package into the build. Also we had that whole deal with migrating to the new webhosting that sort of is still in progress so this is still on my todo list.

kaybee335, 2019-08-21:
I just got mine built yesterday so have no idea about the web hosting issues. Testing last night was amazing. Minimal overshoot after a bit of PID adjustment and stable, stable temps.

I'm in no great rush for the MQTT stuff, I still have to figure out all the stuff that is already there! I'd be happy to give my opinion on things MQTT if you are looking for beta testers.

As far as configuration, please allow the user to specify a 'root' of the topic tree that the HM topics would nest under. That would allow easy integration into topic structures that people may already have on their broker, i.e. 'myHouse/automation/outside'.

pilot1981, 2019-11-19:
any progress with MQTT client developing?

CapnBry, 2019-11-19:
Nope, not yet. This ticket will be updated when there's an update on the situation.

CapnBry, 2020-10-13:
The latest snapshot includes a MQTT client in the form of mosquitto_pub and mosquitto_sub. Publishing the streaming status is as easy just piping the output of lmclient into mosquitto_pub:
```
lmclient @LMSS,1 | mosquitto_pub -h myserver -t "heatermeter/hmstatus" -l
```

There's no webui for configuring the server or topic or MQTT login information/certificate, but it should be easy to start working with it with just the line above.

idomp, 2020-10-13:
Amazing work, I would like to test it.
When should I run this command? ssh shell?

and is the mosquitto_pub is this one?
https://manpages.debian.org/testing/mosquitto-clients/mosquitto_pub.1.en.html
inorder to setup user, password and port for the mqtt server.

CapnBry, 2020-10-13:
Yup it is that same mosquitto_pub, which should have TLS support in it too through the existing OpenSSL but I did not test that.

And yeah just SSH in and run that command with the latest snapshot and you should start seeing streaming updates on the MQTT server. If it works and you want it all the time, it can just be added to the rc.local script to start at startup.

gibman, 2020-11-02:
I can confirm it works using mosquito MQTT on home assistant.

I've added this to my startup

lmclient @LMSS,1 | mosquitto_pub -h 192.168.1.174 -p 1883 -u "someuser" -P "somepass" -i "heatermeter" -t "heatermeter/hmstatus" -l

Its a good idea to have the clientid defined here (the 'i' pararmeter)
In my case I also use login/pass

So currently there is no commands I can set from the MQTT consumer side (home assistant)
stuff like : setting alarm thresholds, target temps. etc.

CapnBry, 2020-11-02:
Great, glad it works!

Yeah currently the only way to change anything is through the HTTP API. I'm not sure this will change, at least for a while, because once you start accepting commands you also need authentication, which then needs configuration UI, and so on and becomes a lot of work in addition to creating another API framework which now doubles the amount of work every time new settings are added. Home Assistant can definitely do the HTTP API calls though so you should be able to easily make an MQTT to HTTP gateway if you want to be able to control the HeaterMeter over MQTT.

gibman, 2020-11-02:
About authentication.
Once you have setup the MQTT broker with this in mind you could just blindly accept any command from the MQTT connection as it would be authenticated already :)

I see the problem with doubling the work though.
I guess one could encapsulate the API and expose a subset of MQTT commands.
This could be done within home assistant etc.

CapnBry, 2020-11-02:
That's a good point, for some reason I was thinking it would have to be a separate connection coming back, but of course one could publish and subscribe on the same outgoing connection. I blame time-change-related morning confusion.

I'm going to leave this ticket open because I'd like to expand on this functionality in the future.

cap9qd, 2020-11-29:
I tried out the mosquitto_pub and it works great from the ssh console!  I can see the data on the RPi that I have the Mosquitto server running on.  However, it doesn't seem to be starting up bootup after adding it to /etc/rc.local.  I found that /etc/rc.local wasn't executable but still didn't work on boot after correcting this item.  Any thoughts?

Also something weird thing is the reboot command doenst work from ssh or from the web gui...?? Maybe something broken in the latest DEV...I used the website to make the "custom" wifi image BTW.

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

mrand, 2020-11-29:
Here's a discussion about a reboot problem that sounds similar, although the kernel versions don't line up with yours.  Perhaps it was a patch that was applied to multiple kernel versions.  https://www.raspberrypi.org/forums/viewtopic.php?t=264374

As for /etc/rc.local not executing on boot, seems like the most common cause is permissions, which you've already fixed.  Other possible causes are the rc system not actually pointed to the rc.local, and in your case since you're trying to do network access, it's possible that the network isn't up yet.  Here's one of many discussions about rc.local appearing to not work: https://www.raspberrypi.org/forums/viewtopic.php?t=95101

cap9qd, 2020-11-29:
Thanks for the pointers!

I was wondering about networking and may end up making and init script that
depends on network... If I can figure it out. I added a debug message to
print to a file to see if it was executing at all.

I'll do some more digging today and report back.

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

cap9qd, 2020-11-29:
So I added a debug statement into the rc.local and it is indeed running.  I am almost positive you are right that the wifi isn't up and so it cannot connect to Mosquitto.  I will work on this and report back.

CapnBry, 2020-11-29:
**The Issue system is not for technical support.**

Please discontinue discussion of your problem here and take it to [the support forums](https://tvwbb.com/forums/heatermeter-diy-bbq-controller.85/). rc.local always runs on boot, there is no need to change any permissions. It is likely the reason you can't reboot is because the lmclient command is a BLOCKING command in the startup script.

I'll look at providing assistance tomorrow, but for now please take discussion to the forums.

Thread 53 (2020-05-23):

Streaming url missing CORS headers

DavidPagels, 2020-05-23:
I've started working on a Reactjs single page app that will integrate with heatermeters. I'm able to load the heatermeter history after updating my heatermeter to get the update resulting from https://github.com/CapnBry/HeaterMeter/issues/44, but am unable to get updates in a browser in realtime from /luci/lm/stream after that.

CapnBry, 2020-05-24:
Should be fixed in the latest snapshot. Now both the /lm/hist and /lm/stream respect the linkmeter.allowcors setting and send the appropriate header.

Thanks for reporting!

Closed 2020-05-24.

Thread 54 (2020-06-29):

Idea: Also be able to use the BLE Meater probes

frankhommers, 2020-06-29:
I could possibly help figuring out the BLE protocol for https://meater.com/

CapnBry, 2020-07-07:
I have one of these as well, and one of the users on the forums has a ~20 line Python script that can decode the values. However, I'm not going to include the entirety of Python in the firmware image just to run a 20 line script. If it was converted to a standalone executable of <100KB or so I'd be happy to make the changes to the HeaterMeter code to accept getting temperature data fed into it from the outside.

I'm going to close this issue though because I don't see that happening.

Closed 2020-07-07.

Thread 55 (2020-07-29):

Temp Probe Graphs

CoffeeTronics, 2020-07-29:
Hi, I have been reading over your repo and I was wondering where you obtained the probe temperature curves from?
I am using the Maverick ET-73. For fun I am trying to produce a lookup table and wanted to compare my results to see if they made sense.
Any pointers are greatly appreciated!

CapnBry, 2020-07-29:
The ET-72/73 probe coefficients I use are curve fit from a PDF file that's floating around the internet that was allegedly were provided (faxed?) from Maverick with a table of temperatures and resistances for the thermistor they use. It's been a decade since I've seen that file though so I'm not sure where it can be found these days.

If you're just looking for a full dump of the curve of the temperature to 10-bit ADC reading, then maybe a test page I use to compare probes and resistances could help. You can find that at [HeaterMeter ADC Resolution](https://heatermeter.com/devel/adctherm/). If you have further questions about it then I'd invite you to post [on the forums](https://tvwbb.com/forums/heatermeter-diy-bbq-controller.85/) where you might get more responses or someone might even still have the original numbers that mine are fit to. The issue tracker here isn't really for Q and A.

Closed 2020-10-13.

Thread 56 (2020-08-03):

Join Wifi network from the heatermeter

TristanDoherty, 2020-08-03:
Feature Suggestion:
It would be wonderful to be able to select a wifi network and enter a password using the LCD screen and nav buttons (up/down to select from list of available networks and to select letters/numbers for the password).

CapnBry, 2020-08-03:
Not gonna happen. Entering a wifi password using up up down down is a nightmare, and you'd have to include not just letters and numbers but all special characters as well. It's the same reason that you can't set a probe name from the on-device LCD. It was in there for a while but it took so long to enter a name and used a bunch of code space so I cut it out. It was really really really awful.

Switching between preconfigured wifi profiles from the LCD menu is sort of on the todo list though, which would be one way of achieving this. Even a new network could be joined by dropping to the default AP mode, then connecting over wifi and joining another network.

Closed 2020-08-03.

Thread 57 (2020-09-09):

4.0 PCB Compatibility

TristanDoherty, 2020-09-09:
Hi,
I recently upgraded my old and trusty heatermeter (v4.0 PCB with the RCA jack) to the v14 stable software version. Now, my fan does not run while in temperature control mode.

What doesn't work:
- boot up the heatermeter and connect the pit probe, set a target temp above the current temp
- observe the fan speed indicator (LCD and web UI) is showing 100% fan speed.
- fan does not run, and 0V at the fan connector. I also see 0V at pin 5 of the atmega

What does work:
- boot up the hetermeter and, using the LCD + button, set "Manual Mode" : yes
- using the button, set the fan speed to 100% (all other speeds work as well)
- observe in the web UI that the fan set point is 100%, 12V at the connector and 3.3V at pin 5 of the atmega

bonus weird behavior:
- if the heatermeter is in the non-working state above, where the fan is not working, and I do the following:
    - click left to manually enter "Lid Open" mode
    - click left to manually exit "Lid Open" mode
- the fan will begin working again and will properly regulate based on the temperature set point.
- if I change the temperature set point, the fan will cease running, but the LCD and web UI will continue to indicate a non-zero fan speed

Is there something in the v14 software that is no longer backwards compatible with the v4.0 PCB and would be causing this behavior?

TristanDoherty, 2020-09-09:
Just as a followup, I see from the code and the schematics that the 4.0 board is missing the fan voltage feedback circuit that the GrillPid::adjustFeedbackVoltage function uses to adjust the output.

Is there a way to disable this closed loop output adjustment?

CapnBry, 2020-09-09:
Ah yes, I forgot about it in the forums thread, that if you're upgrading from a software version before the "Voltage" mode was added, you need to go into the webui and change "Fan output mode" to "Pulse" because the older boards do not have the voltage step down/feedback circuitry. This will make the fan run randomly / not at all because it either thinks the fan voltage is already too high or is too low and it can't compensate.

I'd also recommend skipping v14 and going right to the snapshot if you're upgrading. v14 is pretty old and the snapshot has a lot more features, bug fixes, and is just as stable currently.

TristanDoherty, 2020-09-09:
Hi Bryan,

I upgraded to the latest snapshot (SNAPSHOT 20200810 | Load: 0.87 0.55 0.22, AVR Version 20200715B) and made sure that the fan output mode was set to Pulse in the web UI:
Linkmeter->Configuration->PID Output Parameters->Fan Output->Pulse

I am still seeing the same behavior as before though.

I also tried setting the fan output to Voltage and then resetting it to Pulse, but still no effect.

CapnBry, 2020-09-09:
Oh wait a second. Re-reading your initial report, which apologize I didn't fully take in because I was certain it was just a Pulse vs Voltage setting thing, this seems like very strange behavior. I'm going to pull put a 4.0 HeaterMeter for testing but just to confirm, the blower appears to regulate just fine in Manual mode regardless of the Pulse/Voltage output mode setting? It seems to me it should operate randomly in Voltage Mode and perfectly in Pulse mode, but should work the same regardless of Auto vs Manual mode.

TristanDoherty, 2020-09-09:
When I put it in Voltage mode and use the Manual Fan Control, the fan seems to only be full-on or full-off, regardless of the fan % I set (0% is off, 5-100% is max speed). In Pulse mode, I can adjust the fan speed just fine using the Manual Fan Control.

CapnBry, 2020-09-09:
Ok whew, well that's good because it makes sense that it is fully on-off in Voltage mode. I just dug through my box of 100 HeaterMeters and the only 4.0 I have is one that's half assembled, likely a prototype so I'm not sure if I'll be able to get that up and running to test.

Oh! Looking at the settings you've posted, try changing startup max to 100%. That limits max fan speed until temperature is reached so in Auto mode it would be 0% until it reaches temp the first time which sounds like exactly what's happening. It works when you toggle Lid Mode because coming out of lid mode it switches to RECOVERY mode, which also takes it out of STARTUP mode.

TristanDoherty, 2020-09-09:
Yes! That was totally it. I changed the Fan Startup Max and things are back to normal.
Thank you!
I'll close the issue (especially considering it wasn't really an issue, just a user who didn't know the right setting!)

CapnBry, 2020-09-09:
Glad we got it worked out and happy to help an ole 4.0 user. I was certain it should still work with the latest software and it is good news to hear it does!

Closed 2020-09-09.

Thread 58 (2021-04-08):

msmtp configuration broken for PLAIN LOGIN authentication

jefw, 2021-04-08:
When creating an SMTP Client configuration where:

- Requires authentication: on
- Enable TLS/SSL encryption: off

The admin interface creates /etc/msmtptc with "auth on".  This causes msmtp to fail with "cannot use a secure authentication method" error.

For SMTP servers supporting only PLAIN LOGIN, the appropriate directive is "auth login".

@CapnBry - I have attached a lightly tested patch to openwrt/package/luci-app-msmtp/luasrc/model/cbi/admin_services/msmtp.lua, feel free to use if you wish or I can make a PR if you prefer.

[patch.txt](https://github.com/CapnBry/HeaterMeter/files/6281228/patch.txt)

CapnBry, 2021-04-09:
Nice work finding this. I think I just looked at the `auth xxx` section of the msmtprc file and thought that "on" was the only option. Your patch overlooks that LOGIN and CRAM-MD5 are also valid auth options so instead of forcing it to PLAIN, I now just let the user select which auth mechanism they want (including "Auto" which is what the old version did).

jefw, 2021-04-09:
That's the better solution, for sure.  I didn't really want to noodle with the UI, but an option list is surely more usable in the end.

Closed 2021-04-09.

Thread 59 (2021-09-05):

Port for ESP32

Bananamannn, 2021-09-05:
Hi All,

I'm not much of a programmer but how much work would be involved in porting this from a Raspberry Pi / AT Mega unit too an ESP32 based system?

CapnBry, 2021-09-06:
Oh you'd just have to write it all over again, everything except the home page javascript/html (which would also need some changes). One main drawback of the ESP platform is storage. The database is over 100KB so it would take a significant amount of RAM to hold it, or some new scheme would have to be devised to store parts in flash as well without writing to flash too much to wear it out. Even a Raspberry Pi Zero can also blow the doors off any ESP when it comes to serving webpages so you'd do an entire rewrite to end up with a less capable device for a couple dollars lower cost.

Bananamannn, 2021-09-07:
Oh wow okay. That sounds like a bit of an exercise, sorry for bothering you with it.

I might take your advice and try and find myself an older Pi to use.

Closed 2021-09-07.

Thread 61 (2022-08-03):

Upgrading AVR firmware

brafster, 2022-08-03:
Hi,

quite new to this... I bought a pre-compiled 4.2 board online. Currently it's running AVR 20140630B. Can I just install the latest version from the online repository, or does it also show incompatible versions for 4.3 for instance? Just want to make sure I don't break anything :-) The latest one listed is snapshots/trunk/heatermeter.hex

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

CapnBry, 2022-08-03:
All the 4.x hardware is compatible with the latest firmware. However, I highly recommend you upgrade the Pi firmware image before upgrading the AVR firmware, as AVR firmware assumes the Pi firmware is up to date.
https://heatermeter.com/dl/

Just use the `download .gz` link and upload it from the System -> Backup / Update Firmware page. Your wifi config should be preserved so long as the Keep Settings checkbox is checked.
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

brafster, 2022-08-04:
Awesome! Thanks so much for the help.

Closed 2022-08-04.

Thread 62 (2022-11-27):

Qn: thermoworks pro series basic usage

bsr203, 2022-11-27:
Hello.

Thank you for this wonderful resource. I stumbled upon this project when looking for a way to measure & monitor my oven temp accurately. Unfortunately, to try it out, I found most of the components in the hardware list is not available at Mouser and [HeaterMeter store](https://store.heatermeter.com/) is down for me. Anyway, to begin with, I just wanted to simply read the temp using Arduino/Esp32.

I bought 2 probes  as recommended ([TX-1003X-AP](http://www.thermoworks.com/TX-1003X-AP?tw=HEATERMETER) & [TX-1001X-OP](http://www.thermoworks.com/TX-1001X-OP?tw=HEATERMETER)). Is there any place I can look to see (initial commit, tutorial) how to use these probs for basic measurements?

If not, I found a simple tutorial at https://github.com/skyeperry1/Maverick-ET-73-Meat-Probe-Arduino-Library
After learning, I guess I need to know few parameters to calculate the temp.
looking at the code in this repo, I see Steinhart-hart constants  defined [here](https://github.com/CapnBry/HeaterMeter/blob/0158e80b644e3b49cf752749625bc536e6cba5d9/arduino/heatermeter/hmcore.cpp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) Are these  (7.3431401e-4,2.1574370e-4,9.5156860e-8) the right value for thermoworks pro series?

I couldn't find the thermistor resistance. Can you please point to where in the code it is defined.

Thank you for your time.
bsr

CapnBry, 2022-11-28:
Themistors are just resistors, so all you need to do to measure temperature with them is to form a voltage divider then math out the temperature using the Steinhart coefficients. The code that does that is here (and the next 12 lines):
https://github.com/CapnBry/HeaterMeter/blob/master/arduino/heatermeter/grillpid.cpp#L390

I use [3] to store the resistance of the other half of the voltage divider, which for HeaterMeter is set up as: 3.3V -> 10k resistor (this is the [3]) -> themistor -> GND.

I can't help you write your own thing from scratch I'm afraid, but good luck and have fun!

Closed 2022-11-28.

Thread 63 (2023-05-07):

New wireless thermometer option

rjroch, 2023-05-07:
I've been using a HeaterMeter 4.2.something for like 8 years, and it has been awesome. I've been reading recently that you were trying to incorporate wireless temperature sensors into HeaterMeter, including using Meater probes (which apparently didn't pan out).

Just wanted to drop a note that Chris Young of Modernist Cuisine and Joule fame has released a thermometer that might fit the bill, the Combustion Predictive Thermometer. There's a great developer page at https://developer.combustion.inc/, but it's got BLE connection, and there's no pairing needed, so the thermometers essentially spray temp data from 8 temp sensors out into the world. Shows core temp, surface cook temp, ambient temp, and works up to like 500-600 degrees. I ordered a set of them, and they seem incredibly good so far.

Hoping you might someday be in a position to take a crack at integrating these!

CapnBry, 2023-05-08:
Hello! I haven't looked at wireless thermometer integration in many years. I was hesitant to do any work at all with the Meater due to it possibly just ending up a failed product that would disappear after going through all the development work to hack it in, or it being an ongoing support problem as their protocol kept changing over time. I'm shocked to see it is still exists actually, but it does make me pleased that they were able to create a successful product.

I doubt there will be any integration of any wireless thermometers into HeaterMeter though, there's just too much work needed for a project that's on its way out. The wireless grill thermometer market has a hundred different options now at price points that beat HeaterMeters and connectivity options that beat HeaterMeter's 14 year old design.

There's a lot of challenges that would need to be addressed:
* Bring the firmware over from LEDE to something new, so up to date bluetooth tools are available
* Integrate bluetooth into the system: services, webui, configuration, binding incoming data to HeaterMeter probes, etc
* Allow the HeaterMeter software to accept external data both into the web services, main daemon, and publishing them into the core controller (which comes with a large set of arbitration challenges as multiple services try to talk to the MCU)

It's just a ton of work to integrate and there's just not a lot of life left in the project with existing hardware. It would certainly be a better idea to just start from scratch and rewrite everything to use more modern hardware and not use Raspberry Pis due to their extreme cost now.

rjroch, 2023-05-08:
Man, thanks for replying! I had considered a bit of the work that would need to be done, like the need to integrate bluetooth and how to bind data, but that's a long list. I didn't even consider the Raspberry Pi struggles at all since I have a box of various versions more or less laying around from the good old days. I guess I was hoping you had a framework ready to go, just waiting for data to be dropped in.

It does seem like it would make sense to start from scratch. That said, as much as I like everything being integrated together in one place, the more I think about it, a wireless-only controller device could probably be done as an all-in-one ESP32-based fan+servo damper. With all these new devices having their own apps, it doesn't make sense to reinvent those pieces.

In any case, there's no reason to bug you further. Thanks again for all the hard work you did over the years. What a great device the HeaterMeter has been.

CapnBry, 2023-05-08:
hehe yeah the Raspberry Pi struggle is real, it was sort of the last nail in the coffin for the project after going through all the other supply chain in the past few years. It is a bit of a tough sell to have a "cheap grill controller" project when the Pi part is going for $60-$100 shipped as just one component. I have a handful I shuffle between different tasks, but for anyone new who wants in, I have a hard time recommending them for the price, especially considering it has to be dedicated to being a HeaterMeter.

Creating a tiny firmware image based on OpenWrt was great for making it quick to install and boot super fast but really makes it tough to extend with things like bluetooth support or for anyone to be able to extend really. I don't know which it would be harder to do, move the project from LEDE back onto OpenWrt (including fixing all the tiny bugs that would return) then hope there's a decent bluetooth OpenWrt system, or convert the entirety of the LuCI webui  / controller / daemon code to something else and use Raspberry Pi OS. Either is a lot of work before even starting on figuring out how to manage attaching to other devices and creating the infrastructure to pass it to linkmeter which then needs to pass it to HeaterMeter.

There weren't even any wifi-enabled MCUs when the project started, and the first HeaterMeter used an external $60 wifi module over serial. The ESP8266 came along later but couldn't do everything the project needed, but now there are amazing ESP32s like the S3 that have native USB support for easy flashing or config, dual cores, tons of RAM, 4MB of storage and plenty of I/O. You could almost do everything right from one chip, although storing the current running database might be a bit of a problem, and their ADCs aren't all that good. In any case, I just feel like making an embedded PID controller isn't the complicated part any more and the HeaterMeter architecture is too complicated to build on considering the other options.

I'm happy to hear you still love your HeaterMeter though, I still use mine all the time and it has become so trusted I sleep all night with it running. It was a great project and I hope it lasts you many years to come.

theschles, 2023-08-26:
Hi @CapnBry I understand where you're coming from.

I built my Heatermeter in 2014 or 2015 with a Raspberry Pi 1B.  It was my second through-hole soldering project.

It's been my go-to for barbecuing and smoking meats ever since.

If you or @rjroch or anybody does want to start up a new project -- perhaps mixing in Home Assistant for interoperability -- please let me know?

Closed 2023-05-08.

Thread 65 (2024-05-28):

Is the project dead?

asdkjasdfla, 2024-05-28:
There haven't been any updates on this project for a while. The website for heatermeter is also down. Is this project dead?

CapnBry, 2024-06-10:
The HeaterMeter website is still fine, but the store is closed. I'm not really working on any new updates for the software either but I will keep it running as I still use my HeaterMeters all the time.

asdkjasdfla, 2024-06-10:
Thankyou. Any idea if those who haven't got the hardware for heatermeter can get it from?

CapnBry, 2024-06-10:
[The parts list is in the wiki](https://github.com/CapnBry/HeaterMeter/wiki/HeaterMeter-4.3-Hardware), so I'd suggest an online electronics retailer, such as Mouser. The PCBs can be made even cheaper than when I was making them by using PCBWay or similar, but you'll have to buy at least 5 I think so it would be a good idea to try to do some sort of group buy.

Thread 66 (2025-06-12):

Heatermeter 4.0 wifi no longer working

mattncsu, 2025-06-12:
@CapnBry I have been using one of your awesome heatermeter boards since hw version 4.0 with a Pi1 B.  I'm using the Edimax EW-7188UN N150 which was connected great for years.  I hadn't used my heatermeter in over a year and I plugged it in and it didn't connect to wifi. I connected via ethernet and saw that the wifi wasn't connecting.  A scan showed no nearby access points.  The system log had the following wifi related items:

Wed Jun 11 22:58:55 2025 kern.info kernel: [    2.772296] usb 1-1.3: new high-speed USB device number 4 using dwc_otg
Wed Jun 11 22:58:55 2025 kern.info kernel: [    3.029531] usb 1-1.3: New USB device found, idVendor=7392, idProduct=b811
Wed Jun 11 22:58:55 2025 kern.info kernel: [    3.032948] usb 1-1.3: New USB device strings: Mfr=1, Product=2, SerialNumber=3
Wed Jun 11 22:58:55 2025 kern.info kernel: [    3.036162] usb 1-1.3: Product: Edimax N150 Adapter
Wed Jun 11 22:58:55 2025 kern.info kernel: [    3.039304] usb 1-1.3: Manufacturer: Realtek
Wed Jun 11 22:59:02 2025 daemon.notice netifd: radio0 (368): Could not find PHY for device 'radio0'
Wed Jun 11 22:59:03 2025 daemon.notice netifd: radio0 (391): WARNING: Variable 'data' does not exist or is not an array/object
Wed Jun 11 22:59:06 2025 daemon.notice netifd: radio0 (571): Could not find PHY for device 'radio0'
Wed Jun 11 22:59:07 2025 daemon.notice netifd: radio0 (597): WARNING: Variable 'data' does not exist or is not an array/object

I was on some really old version, maybe v12 so I flashed v15 and it did not help.  I thought maybe the wifi dongle was damaged so I ordered a replacement Edimax adapter and getting the same results.  Any ideas? I have some Pi2s and 3s sitting around, can the heatermeter 4.0 hardware be used with the newer Pis?
