CapnBry/HeaterMeter/eagle/Base/HeaterMeterPI.kicad_pcb

## KiCad design eagle/Base/HeaterMeterPI.kicad_pcb (2021-07-01)

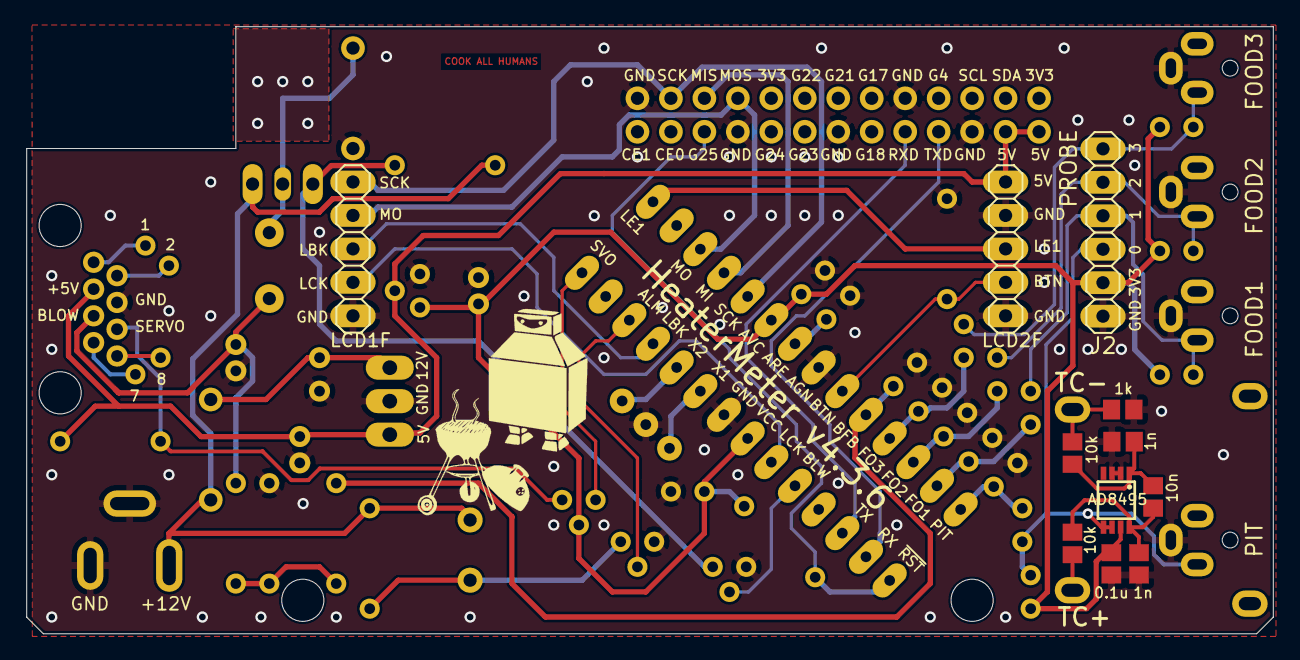
[picture p9: board HeaterMeterPI.kicad_pcb from above]

Board: 2 copper layers, 94.6 x 46.1 mm, 65 parts (0 on the bottom side), 44 nets.

Parts:
C1, C2, C3, C7, C15, C16, C17, C18: 0.1u; C025-025X050
C4: 100u/25; E2,5-6
C5, C6: 100u/10; E2-5
C8, C11: 1n; C0805
C9: 10n; C0805
C12: 47u/25; E2-5
C13: 0.1u; C0805
D2, D3: 1N5819; DO41-7
H1, H2: MountingHole; MountingHole_3.2mm_M3_ISO14580
IC1: OKI-78SR-5; TO220HMURATA
IC2: ATmega328P; DIL28-3
IC4: MCP1700; TO92
IC5: AD8495; MSOP8
J1: RPi; 2X13
J2: PROBE; 1X06
J4: PCC-SMP
J9: Barrel_Jack_Switch; BarrelJack_Horizontal
JP1: LCD1F; 1X05
JP2: RJ45-8; RJ45-8-1H
JP3: PIT; CUI-MJ1-2503A
JP4: FOOD1; CUI-MJ1-2503A
JP5: FOOD2; CUI-MJ1-2503A
JP6: FOOD3; CUI-MJ1-2503A
JP8: LCD2F; 1X05
L1: 220u; E5-9
Q1, Q2, Q5: BS170; SOT54E
Q3: FQU11P06TU; TO251
R1, R3, R21: 1k; 0204_7
R4: 22k; 0204_7
R5, R16, R17, R18: 10k 1%; 0207_2V
R13: 68k; 0204_7
R14: 2k2; 0204_7
R19: 100k; 0204_7
R20: 10k; 0204_7
R22, R23, R28, R29: 100k; 0207_2V
R24: 1k; R0805
R25, R26: 10k; R0805
SP1: ALARM; AL11P
U$1, U$2, U$3, U$4: THROUGH-HOLE; PAD-032
Y1: 16MHz; RESONATOR-PTH

Connections:
+3V3: C1.1, C3.1, C6.+, C13.1, IC2.7, IC2.20, IC4.3, IC5.7, J2.2, Q5.G, R5.2, R16.2, R17.2, R18.2, R20.2
+5V: C5.+, IC1.3, IC4.2, J1.24, J1.26, JP2.3, JP8.1, R21.2
+12V: D3.A, J9.1, Q3.3, R3.2, R14.1, SP1.+
/+12V_BLW: C12.+, JP2.5, L1.NEG, R13.1
/+12V_FB: C7.1, IC2.24, R19.2
/ALARM: IC2.12, Q2.G
/BLOWER: IC2.5, Q1.G
/BUTTONS: IC2.23, JP8.4, R1.2
/FOOD1: C16.1, IC2.27, R28.1
/FOOD2: C17.1, IC2.26, R23.1
/FOOD3: C18.1, IC2.25, R22.1
/LCD_BKLT: IC2.11, JP1.3
/LCD_CLK: IC2.6, JP1.4
/LED1: IC2.15, JP8.3
/MISO: IC2.18, J1.5
/MOSI: IC2.17, J1.7, JP1.2
/OUT-1: JP2.1, U$3.P
/OUT-2: JP2.2, U$4.P
/OUT-7: JP2.7, U$2.P
/OUT-8: JP2.8, U$1.P
/PIT: C15.1, IC2.28, R29.1
/PIT_P: IC5.5, IC5.6, J2.3, JP3.2, R18.1, R29.2
/RX: IC2.2, J1.20
/SCK: IC2.19, J1.3, JP1.1
/SERVO: IC2.14, Q5.S
/SRVBST: JP2.6, Q5.D, R21.1
/TX: IC2.3, J1.18
/~RESET: IC2.1, J1.6, R20.1
GND: C1.2, C2.2, C3.2, C4.-, C5.-, C6.-, C7.2, C8.1, C11.2, C12.-, C13.2, C15.2, C16.2, C17.2, C18.2, D2.A, IC1.2, IC2.8, IC2.22, IC4.1, IC5.2, IC5.3, J1.1, J1.8, J1.14, J1.17, J1.22, J2.1, J9.2, J9.3, JP1.5, JP2.4, JP3.1, JP4.1, JP5.1, JP6.1, JP8.2, JP8.5, Q1.S, Q2.S, R1.1, R4.2, R24.1, Y1.2
unnamed: C2.1, IC2.21
unnamed: C4.+, D3.C, IC1.1
unnamed: C8.2, C9.1, IC5.8, R25.1
unnamed: C9.2, C11.1, IC5.1, R26.1
unnamed: D2.C, L1.POS, Q3.2@1, Q3.2@2
unnamed: IC2.9, Y1.1
unnamed: IC2.10, Y1.3
unnamed: J2.4, JP4.2, R17.1, R28.2
unnamed: J2.5, JP5.2, R16.1, R23.2
unnamed: J2.6, JP6.2, R5.1, R22.2
unnamed: J4.TC+, R25.2
unnamed: J4.TC-, R24.2, R26.2
unnamed: Q1.D, Q3.1, R14.2
unnamed: Q2.D, R3.1, SP1.-
unnamed: R4.1, R13.2, R19.1
