CapnBry/HeaterMeter/eagle/HeaterMeterLCD.brd

## EAGLE design eagle/HeaterMeterLCD.brd (2018-08-08)

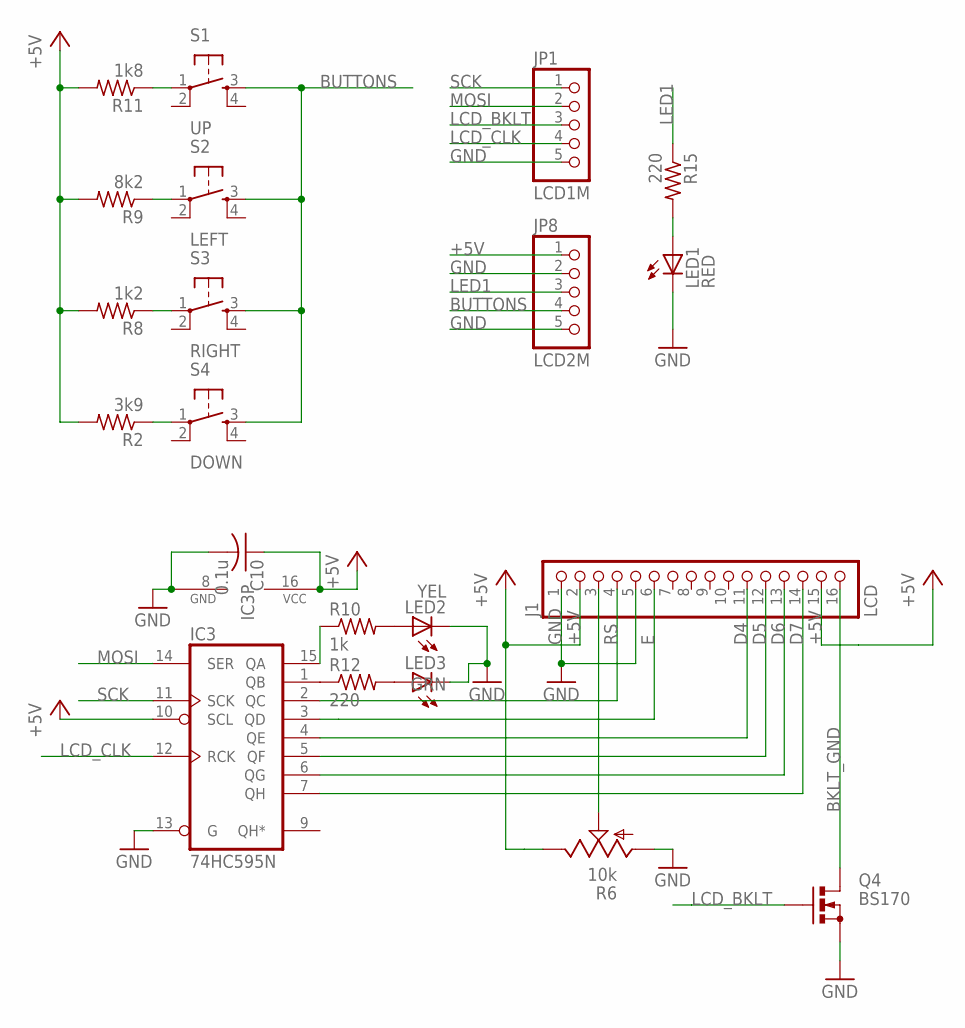
[picture p11: schematic HeaterMeterLCD.sch]

Parts:
C10: 0.1u; C025-025X050
IC3: 74HC595N; DIL16
J1: LCD; 1X16
JP1: LCD1M; 1X05
JP8: LCD2M; 1X05
LED1: RED; LED3MM
LED2: YEL; LED3MM
LED3: GRN; LED3MM
Q4: BS170; SOT54E
R2: 3k9; 0204/7
R6: 10k; POT-CT6-SIDE
R8: 1k2; 0204/7
R9: 8k2; 0204/7
R10: 1k; 0204/7
R11: 1k8; 0204/7
R12, R15: 220; 0204/7
S1: UP; TACT-OMRON-12MM
S2: LEFT; TACT-OMRON-12MM
S3: RIGHT; TACT-OMRON-12MM
S4: DOWN; TACT-OMRON-12MM

Connections:
+5V: C10.1, IC3.10 (SCL), IC3.16 (VCC), J1.2, J1.15, JP8.1, R2.2, R6.E, R8.2, R9.2, R11.2
BKLT_GND: J1.16, Q4.D
BUTTONS: JP8.4, S1.3, S2.3, S3.3, S4.3
D4: IC3.4 (QE), J1.11
D5: IC3.5 (QF), J1.12
D6: IC3.6 (QG), J1.13
D7: IC3.7 (QH), J1.14
E: IC3.3 (QD), J1.6
GND: C10.2, IC3.8 (GND), IC3.13 (G), J1.1, J1.5, JP1.5, JP8.2, JP8.5, LED1.K (C), LED2.K (C), LED3.K (C), Q4.S, R6.A
LCD_BKLT: JP1.3, Q4.G
LCD_CLK: IC3.12 (RCK), JP1.4
LED1: JP8.3, R15.1
MOSI: IC3.14 (SER), JP1.2
unnamed: R2.1, S4.1
unnamed: R11.1, S1.1
unnamed: J1.3, R6.S
unnamed: R9.1, S2.1
unnamed: LED2.A, R10.2
unnamed: LED1.A, R15.2
unnamed: R8.1, S3.1
unnamed: IC3.15 (QA), R10.1
unnamed: IC3.1 (QB), R12.1
unnamed: LED3.A, R12.2
RS: IC3.2 (QC), J1.4
SCK: IC3.11 (SCK), JP1.1

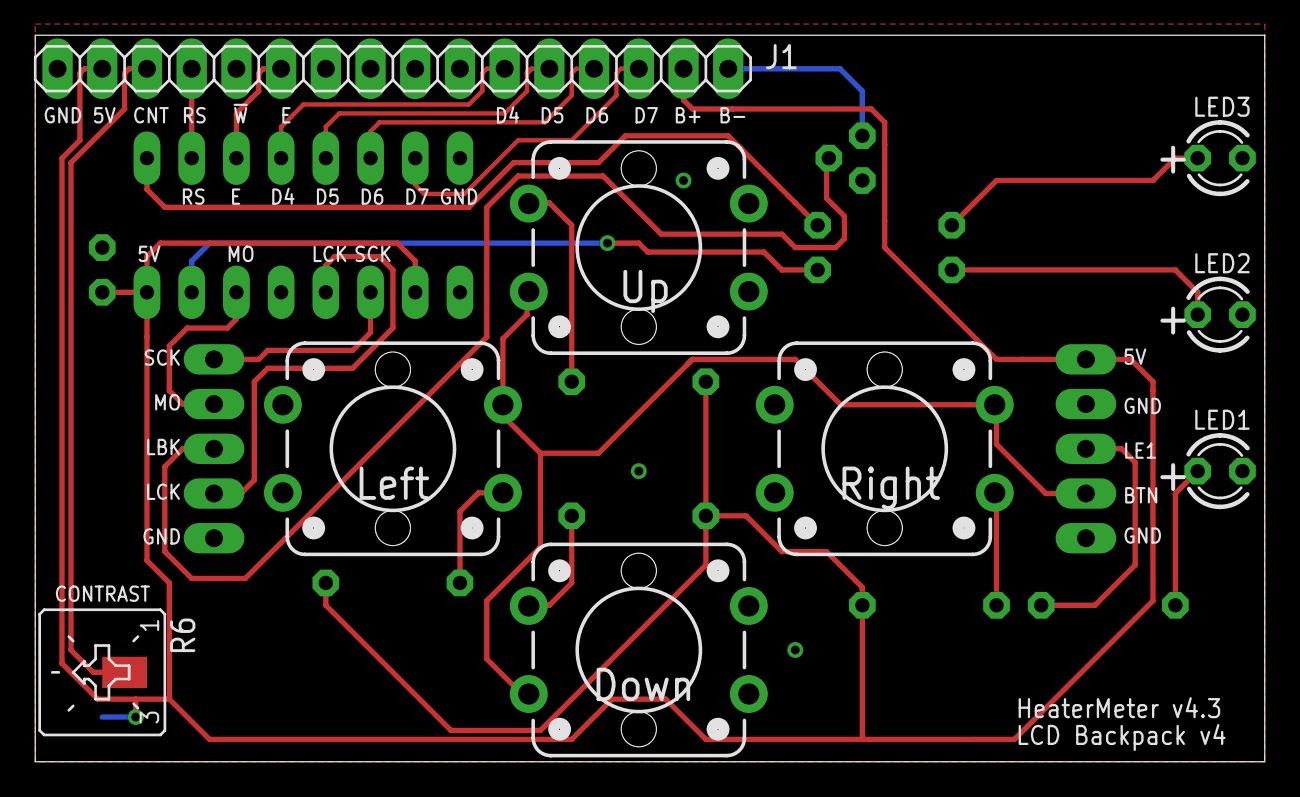
[picture p12: board HeaterMeterLCD.brd from above]

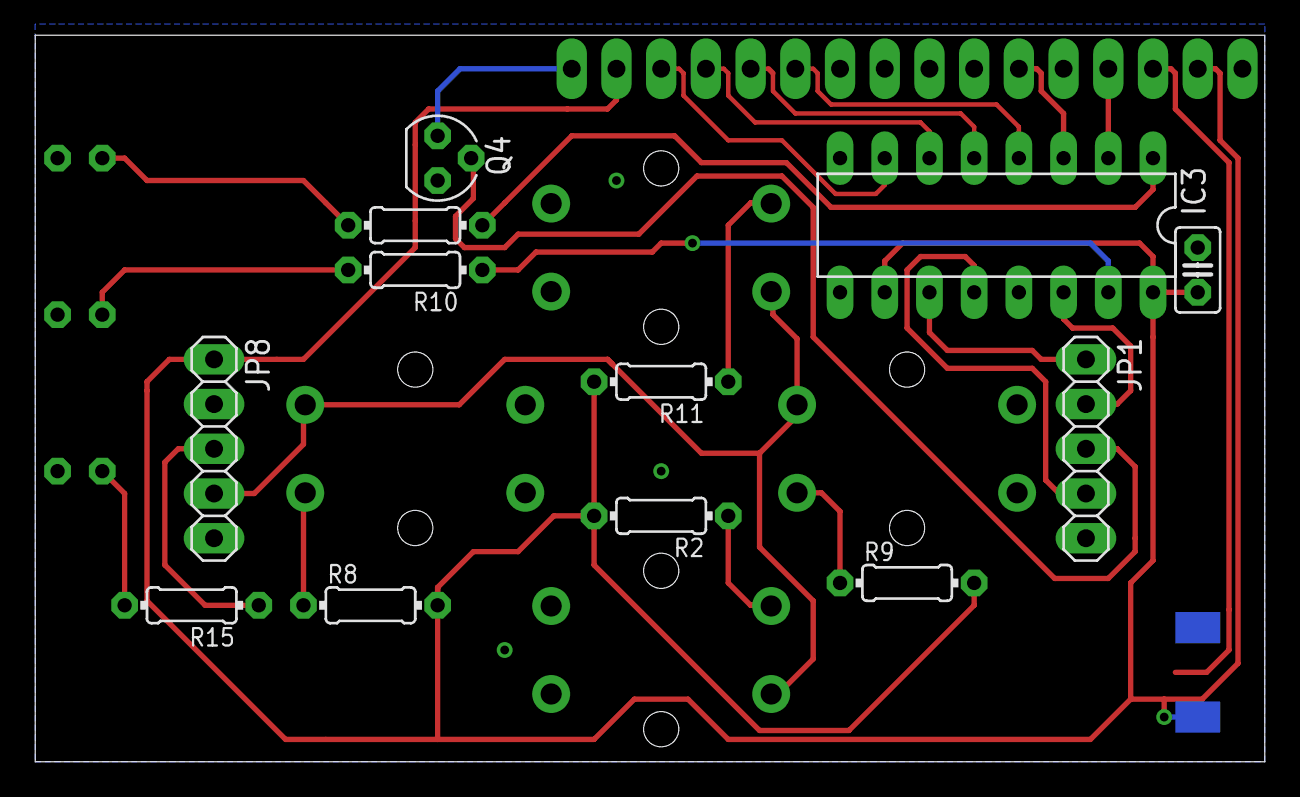
[picture p13: board HeaterMeterLCD.brd from below]

Board: 2 copper layers, 69.8 x 41.3 mm, 21 parts (12 on the bottom side), 25 nets.
