CapnBry/HeaterMeter/arduino/heatermeter/grillpid.cpp

// HeaterMeter Copyright 2019 Bryan Mayland <bmayland@capnbry.net>
// GrillPid uses TIMER1 COMPB vector, as well as modifies the waveform
// generation mode of TIMER1. Blower output pin needs to be a hardware PWM pin.
// Fan output is 489Hz phase-correct PWM
// Servo output is 50Hz pulse duration
#include <math.h>
#include <string.h>
#include <util/atomic.h>
#include <digitalWriteFast.h>

#include "strings.h"
#include "grillpid.h"
#include "ad8495_lin.h"

extern GrillPid pid;

// For this calculation to work, ccpm()/8 must return a round number
#define uSecToTicks(x) ((unsigned int)(clockCyclesPerMicrosecond() / 8) * x)

// LERP percentage o into the range [A,B]. B - A must be < 327
#define mappct(o, a, b)  ((((int)b - (int)a) * (int)o / 100) + (int)a)

#define DIFFMAX(x,y,d) ((x - y + d) <= (d*2U))

#if defined(GRILLPID_SERVO_ENABLED)
ISR(TIMER1_CAPT_vect)
{
  unsigned int nextStep = pid.getServoStepNext(OCR1B);
  if (nextStep != 0)
  {
    digitalWriteFast(PIN_SERVO, HIGH);
    nextStep -= uSecToTicks(SERVO_BUSYWAIT);
    // Add the current timer1 count to offset the delay of calculating
    // the next move, and any interrupt latency due to the ADC code
    OCR1B = TCNT1 + nextStep;
  }
}

ISR(TIMER1_COMPB_vect)
{
#if SERVO_BUSYWAIT > 0
  // COMPB (OCR1B) is triggered SERVO_BUSYWAIT usec before the switch time
  unsigned int target = OCR1B + uSecToTicks(SERVO_BUSYWAIT);
  while (TCNT1 < target)
    ;
#endif
  digitalWriteFast(PIN_SERVO, LOW);
}
#endif

// ADC pin to poll between every other ADC read, with low oversampling
#define ADC_INTERLEAVE_HIGHFREQ 0

static struct tagAdcState
{
  unsigned char top;       // Number of samples to take per reading
  unsigned char cnt;       // count left to accumulate
  unsigned long accumulator;  // total
  unsigned char discard;   // Discard this many ADC readings
  unsigned char thisHigh;  // High this period
  unsigned char thisLow;   // Low this period
  unsigned char pin;       // pin for which these readings were made
  unsigned char pin_next;  // Nextnon-interleaved pin read
  unsigned long analogReads[NUM_ANALOG_INPUTS]; // Current values
  unsigned char analogRange[NUM_ANALOG_INPUTS]; // high-low on last period
#if defined(GRILLPID_DYNAMIC_RANGE)
  bool useBandgapReference[NUM_ANALOG_INPUTS]; // Use 1.1V reference instead of AVCC
  unsigned int bandgapAdc;                     // 10-bit adc reading of BG with AVCC ref
#endif
  struct {
    unsigned char dumpPeriod;
    unsigned char pinRequested; // pin to record ADC data on next time it comes around
    unsigned char pinData; // pin data[] contains, set after data is full
    unsigned int data[256];
  } noise;
} adcState;

ISR(ADC_vect)
{
  if (adcState.discard != 0)
  {
    --adcState.discard;
    // Actually do the calculations for the previous set of reads while in the
    // discard period of the next set of reads. Break the code up into chunks
    // of roughly the same number of clock cycles.
    if (adcState.discard == 2)
    {
      adcState.analogReads[adcState.pin] = adcState.accumulator;
      adcState.analogRange[adcState.pin] = adcState.thisHigh - adcState.thisLow;
    }
    else if (adcState.discard == 1)
    {
      if (adcState.pin == adcState.noise.pinRequested)
        adcState.noise.pinData = adcState.noise.pinRequested;
      adcState.pin = ADMUX & 0x0f;
      if (adcState.pin == adcState.noise.pinRequested)
        adcState.noise.pinData = 0xff;
      adcState.accumulator = 0;
    }
    else if (adcState.discard == 0)
    {
      adcState.thisHigh = 0;
      adcState.thisLow = 0xff;
      if (adcState.pin == ADC_INTERLEAVE_HIGHFREQ)
      {
        adcState.cnt = 4;
        adcState.pin_next = (adcState.pin_next + 1) % NUM_ANALOG_INPUTS;
        // Notice this doesn't check if pin_next is ADC_INTERLEAVE_HIGHFREQ, which
        // means ADC_INTERLEAVE_HIGHFREQ will be checked twice in a row each loop
        // Not worth the extra code to make that not happen
      }
      else
        adcState.cnt = adcState.top;
    }
    return;
  }

  unsigned char pin = ADMUX & 0x0f;
  if (adcState.cnt != 0)
  {
    --adcState.cnt;
    unsigned int adc = ADC;
    if (pin == adcState.noise.pinRequested)
      adcState.noise.data[adcState.cnt] = adc;
    adcState.accumulator += adc;

    unsigned char a = adc >> 2;
    if (a > adcState.thisHigh)
      adcState.thisHigh = a;
    if (a < adcState.thisLow)
      adcState.thisLow = a;
  }
  else
  {
#if defined(GRILLPID_DYNAMIC_RANGE)
    if (pin > NUM_ANALOG_INPUTS)
    {
      // Store only the last ADC value, giving the bandgap ~25ms to stabilize
      adcState.bandgapAdc = ADC;
      // adcState.pin will be set to (0x4e & 0x0f) due to startup's bandgap measure + .discard code
      adcState.pin = 0;
    }
#endif // GRILLPID_DYNAMIC_RANGE

    // If just read the interleaved pin, advance to the next pin
    if (pin == ADC_INTERLEAVE_HIGHFREQ)
      pin = adcState.pin_next;
    else
      pin = ADC_INTERLEAVE_HIGHFREQ;

#if defined(GRILLPID_DYNAMIC_RANGE)
    unsigned char newref =
      adcState.useBandgapReference[pin] ? (INTERNAL << 6) : (DEFAULT << 6);
    unsigned char curref = ADMUX & 0xc0;
    // If switching references, allow time for AREF cap to charge
    if (curref != newref)
      adcState.discard = 48;  // 48 / 9615 samples/s = 5ms
    else
      adcState.discard = 3;

    ADMUX = newref | pin;
#else
    ADMUX = (DEFAULT << 6) | pin;
    adcState.discard = 3;
#endif
  }
}

unsigned int analogReadOver(unsigned char pin, unsigned char bits)
{
  unsigned long a;
  ATOMIC_BLOCK(ATOMIC_FORCEON)
  {
    a = adcState.analogReads[pin];
  }

  // If requesting the interleave pin, scale down from reduced resolution
  if (pin == ADC_INTERLEAVE_HIGHFREQ)
    return a >> (12 - bits);

  // Scale up to 256 samples then divide by 2^4 for 14 bit oversample
  unsigned int retVal = a * 16 / adcState.top;
  return retVal >> (14 - bits);
}

unsigned char analogReadRange(unsigned char pin)
{
  return adcState.analogRange[pin];
}

#if defined(GRILLPID_DYNAMIC_RANGE)
bool analogIsBandgapReference(unsigned char pin)
{
  return adcState.useBandgapReference[pin];
}

void analogSetBandgapReference(unsigned char pin, bool enable)
{
  adcState.useBandgapReference[pin] = enable;
}

unsigned int analogGetBandgapScale(void)
{
  return adcState.bandgapAdc;
}

#endif /* GRILLPID_DYNAMIC_RANGE */

static void adcDump(void)
{
  if (adcState.noise.pinRequested == 0xff)
    return;

  ++adcState.noise.dumpPeriod;
  if (adcState.noise.dumpPeriod >= GRILLPID_NOISE_REPORT_INTERVAL)
  {
    ATOMIC_BLOCK(ATOMIC_FORCEON)
    {
      // If the data isn't for the requested pin, or currently sampling (pinData=0xff), try again
      if (adcState.noise.pinData != adcState.noise.pinRequested)
        return;
      adcState.noise.pinRequested = 0xff;
    }

    adcState.noise.dumpPeriod = 0;
    print_P(PSTR("HMND" CSV_DELIMITER));
    // SIZE: Just using adcState.top saves 14 bytes
    unsigned char top = adcState.noise.pinData == ADC_INTERLEAVE_HIGHFREQ ? 4 : adcState.top;
    unsigned int last = 0;
    for (unsigned char i=0; i<top; ++i)
    {
      /* Noisedump output is differential encoded.
        curr == last -> .
        curr < last -> -
        curr > last -> +
        If the difference is more than 1, then the sign is followed by the difference, +XXXX or -XXXX */
      unsigned int curr = adcState.noise.data[i];
      if (last < curr)
      {
        Serial_char('+');
        unsigned int diff = curr - last;
        if (diff > 1)
          SerialX.print(diff, DEC);
      }
      else if (last > curr)
      {
        Serial_char('-');
        unsigned int diff = last - curr;
        if (diff > 1)
          SerialX.print(diff, DEC);
      }
      else
        Serial_char('.');
      last = curr;
    }
    Serial_nl();

    adcState.noise.pinRequested = adcState.noise.pinData;
  }
}

static void calcExpMovingAverage(const float smooth, float *currAverage, float newValue)
{
  newValue = newValue - *currAverage;
  *currAverage = *currAverage + (smooth * newValue);
}

void ProbeAlarm::updateStatus(int value)
{
  // Low: Arming point >= Thresh + 1.0f, Trigger point < Thresh
  // A low alarm set for 100 enables at 101.0 and goes off at 99.9999...
  if (getLowEnabled())
  {
    if (value >= (getLow() + 1))
      Armed[ALARM_IDX_LOW] = true;
    else if (value < getLow() && Armed[ALARM_IDX_LOW])
      Ringing[ALARM_IDX_LOW] = true;
  }

  // High: Arming point < Thresh - 1.0f, Trigger point >= Thresh
  // A high alarm set for 100 enables at 98.9999... and goes off at 100.0
  if (getHighEnabled())
  {
    if (value < (getHigh() - 1))
      Armed[ALARM_IDX_HIGH] = true;
    else if (value >= getHigh() && Armed[ALARM_IDX_HIGH])
      Ringing[ALARM_IDX_HIGH] = true;
  }

  if (pid.isLidOpen())
    Ringing[ALARM_IDX_LOW] = Ringing[ALARM_IDX_HIGH] = false;
}

void ProbeAlarm::setHigh(int value)
{
  setThreshold(ALARM_IDX_HIGH, value);
}

void ProbeAlarm::setLow(int value)
{
  setThreshold(ALARM_IDX_LOW, value);
}

void ProbeAlarm::setThreshold(unsigned char idx, int value)
{
  Armed[idx] = false;
  Ringing[idx] = false;
  /* 0 just means silence */
  if (value == 0)
    return;
  Thresholds[idx] = value;
}

TempProbe::TempProbe(const unsigned char pin) :
  _pin(pin), _tempStatus(TSTATUS_NONE)
{
}

void TempProbe::loadConfig(struct __eeprom_probe *config)
{
  _probeType = config->probeType;
  Offset = config->tempOffset;
  memcpy(Steinhart, config->steinhart, sizeof(Steinhart));
  Alarms.setLow(config->alarmLow);
  Alarms.setHigh(config->alarmHigh);
}

void TempProbe::setProbeType(unsigned char probeType)
{
  _probeType = probeType;
  _tempStatus = TSTATUS_NONE;
  resetTemperatureAvg();
}

void TempProbe::calcTemp(unsigned int adcval)
{
  const unsigned char powBits = pow(2, TEMP_OVERSAMPLE_BITS);
  const float ADCmax = 1023U * powBits;

  // Units 'A' = ADC value
  if (pid.getUnits() == 'A')
  {
    Temperature = adcval;
    _tempStatus = TSTATUS_OK;
    return;
  }

  if (_probeType == PROBETYPE_TC_ANALOG)
  {
    float mvScale = Steinhart[3];
    // Commented out because there's no "divide by zero" exception so
    // just allow undefined results to save prog space
    //if (mvScale == 0.0f)
    //  mvScale = 1.0f;
    // If scale is <100 it is assumed to be mV/C with a 3.3V reference
    if (mvScale < 100.0f)
      mvScale = 3300.0f / mvScale;
#if defined(GRILLPID_DYNAMIC_RANGE)
    if (analogIsBandgapReference(_pin))
    {
      analogSetBandgapReference(_pin, adcval < (1000U * powBits));
      mvScale /= 1023.0f / adcState.bandgapAdc;
      // If ADC is within ADCRange of MAX, this is usually an unplug of the probe.
      // Range is in 8 bit units, so it needs *4 to be brought back to 10bit
      if (adcval + (4U * powBits * (unsigned int)analogReadRange(_pin)) > (1022U * powBits))
      {
        _tempStatus = TSTATUS_NONE;
        return;
      }
    }
    else
      analogSetBandgapReference(_pin, adcval < (300U * powBits));
#endif
    setTemperatureC(
      tcNonlinearCompensate(adcval / ADCmax * mvScale)
    );
    return;
  }

  // Ignore probes within 1 LSB of max. TC don't need this as their min/max
  // values are rejected as outside limits in setTemperatureC()
  if (adcval > (1022U * powBits) || adcval == 0)
  {
    _tempStatus = TSTATUS_NONE;
    return;
  }

  /* if PROBETYPE_INTERNAL */
  float R, T;
  R = Steinhart[3] / ((ADCmax / (float)adcval) - 1.0f);

  // Units 'R' = resistance, unless this is the pit probe (which should spit out Celsius)
  if (pid.getUnits() == 'R' && this != pid.Probes[TEMP_CTRL])
  {
    Temperature = R;
    _tempStatus = TSTATUS_OK;
    return;
  };

  // Compute degrees K
  R = log(R);
  T = 1.0f / ((Steinhart[2] * R * R + Steinhart[1]) * R + Steinhart[0]);

  setTemperatureC(T - 273.15f);
}

void TempProbe::processPeriod(void)
{
  // Called once per measurement period after temperature has been calculated
  if (hasTemperature())
  {
    if (!_hasTempAvg)
    {
      TemperatureAvg = Temperature;
      _hasTempAvg = true;
    }
    else
      calcExpMovingAverage(TEMPPROBE_AVG_SMOOTH, &TemperatureAvg, Temperature);

    if (!pid.isDisabled())
    {
      Alarms.updateStatus(Temperature);
      return;
    }
  }

  // !hasTemperature() || pid.getDisabled()
  Alarms.silenceAll();
}

void TempProbe::setTemperatureC(float T)
{
  // Apply offset
  float offsetC = Offset;
  if (pid.getUnits() == 'F')
    offsetC = offsetC * (5.0f / 9.0f);
  T += offsetC;

  // Sanity - anything less than -100C (-148F) or greater than 500C (932F) is rejected
  if (T <= -100.0f)
    _tempStatus = TSTATUS_LOW;
  else if (T >= 500.0f)
    _tempStatus = TSTATUS_HIGH;
  else
  {
    if (pid.getUnits() == 'F')
      Temperature = (T * (9.0f / 5.0f)) + 32.0f;
    else
      Temperature = T;
    _tempStatus = TSTATUS_OK;
  }
}

void TempProbe::status(void) const
{
  if (hasTemperature())
    SerialX.print(Temperature, 1);
  else
    Serial_char('U');
  Serial_csv();
}

void GrillPid::init(void)
{
#if defined(GRILLPID_SERVO_ENABLED)
  pinModeFast(PIN_SERVO, OUTPUT);

  // CTC mode with ICR1 as TOP, 8 prescale, INT on COMPB and TOP (ICR
  // Period set to SERVO_REFRESH
  // If GrillPid is constructed statically this can't be done in the constructor
  // because the Arduino core init is called after the constructor and will set
  // the values back to the default
  ICR1 = uSecToTicks(SERVO_REFRESH);
  TCCR1A = 0;
  TCCR1B = bit(WGM13) | bit(WGM12) | bit(CS11);
  TIMSK1 = bit(ICIE1) | bit(OCIE1B);
#endif
  // Initialize ADC for free running mode at 125kHz
#if defined(GRILLPID_DYNAMIC_RANGE)
  // Start by measuring the bandgap reference for dynamic range scaling
  ADMUX = (DEFAULT << 6) | 0b1110;
#else
  ADMUX = (DEFAULT << 6) | 0;
#endif // GRILLPID_DYNAMIC_RANGE
  ADCSRB = bit(ACME);
  ADCSRA = bit(ADEN) | bit(ADATE) | bit(ADIE) | bit(ADPS2) | bit(ADPS1) | bit (ADPS0) | bit(ADSC);

  updateControlProbe();
  adcState.noise.pinRequested = 0xff;
}

void __attribute__ ((noinline)) GrillPid::updateControlProbe(void)
{
  // Set control to the first non-Disabled probe. If all probes are disabled, return TEMP_PIT
  Probes[TEMP_CTRL] = Probes[TEMP_PIT];
  for (uint8_t i=0; i<TEMP_COUNT; ++i)
    if (Probes[i]->getProbeType() != PROBETYPE_DISABLED)
    {
      Probes[TEMP_CTRL] = Probes[i];
      break;
    }
}

void GrillPid::setProbeType(unsigned char idx, unsigned char probeType)
{
  Probes[idx]->setProbeType(probeType);
  updateControlProbe();
}

void GrillPid::setOutputFlags(unsigned char value)
{
  _outputFlags = value;

  unsigned char newTop;
  // 50Hz = 192.31 samples
  if (bit_is_set(value, PIDFLAG_LINECANCEL_50))
     newTop = 192;
  // 60Hz = 160.25 samples
  else if (bit_is_set(value, PIDFLAG_LINECANCEL_60))
    newTop = 160;
  else
    newTop = 255;
  ATOMIC_BLOCK(ATOMIC_FORCEON)
  {
    adcState.top = newTop;
    adcState.discard = 3;
  }

  // Timer2 Fast PWM
  TCCR2A = bit(WGM21) | bit(WGM20);
  if (bit_is_set(value, PIDFLAG_FAN_FEEDVOLT))
    TCCR2B = bit(CS20); // 62kHz
  else
    TCCR2B = bit(CS22) | bit(CS20); // 488Hz
  // 7khz
  //TCCR2B = bit(CS21);
  // 61Hz
  //TCCR2B = bit(CS22) | bit(CS21) | bit(CS20);
}

void GrillPid::servoRangeChanged(void)
{
#if defined(SERVO_MIN_THRESH)
  _servoHoldoff = SERVO_MAX_HOLDOFF;
#endif
}

void GrillPid::setServoMinPos(unsigned char value)
{
  _servoMinPos = value;
  servoRangeChanged();
}

void GrillPid::setServoMaxPos(unsigned char value)
{
  _servoMaxPos = value;
  servoRangeChanged();
}

unsigned int GrillPid::countOfType(unsigned char probeType) const
{
  unsigned char retVal = 0;
  for (unsigned char i=0; i<TEMP_COUNT; ++i)
    if (Probes[i]->getProbeType() == probeType)
      ++retVal;
  return retVal;  
}

/* Calucluate the desired output percentage using the proportional-integral-derivative (PID) controller algorithm */
inline void GrillPid::calcPidOutput(void)
{
  unsigned char lastOutput = _pidOutput;
  _pidOutput = 0;

  // If the pit probe is registering 0 degrees, don't jack the fan up to MAX
  if (!Probes[TEMP_CTRL]->hasTemperature())
    return;

  // If we're in lid open mode, fan should be off
  if (isLidOpen())
    return;

  float currentTemp = Probes[TEMP_CTRL]->Temperature;
  float error = _setPoint - currentTemp;

  if (Pid[PIDP] < 0.0f)
    // PPPPP = fan speed percent per degree of temperature minus current
    // lambda * P * error - (1-lambda) * P * curr => P * (lambda * set - curr)
    // (Linear combination of Proportional on Measurement and Error)
    _pidCurrent[PIDP] = Pid[PIDP] * ((-GRILLPID_PONMEER_LAMBDA * _setPoint) + currentTemp);
  else
    // PPPPP = fan speed percent per degree of error (Proportional on Error)
    _pidCurrent[PIDP] = Pid[PIDP] * error;

  // IIIII = fan speed percent per degree of accumulated error
  // anti-windup: Make sure we only adjust the I term while inside the proportional control range
  unsigned char high = getPidIMax();
  if ((error < 0 && lastOutput > 0) || (error > 0 && lastOutput < high))
  {
    _pidCurrent[PIDI] += Pid[PIDI] * error;
    // If using PoMeEr, the max windup has to be extended to allow 100% output at curr == set
    float exHigh = high;
    if (Pid[PIDP] < 0.0f)
      exHigh += (-1.0f+GRILLPID_PONMEER_LAMBDA) * Pid[PIDP] * _setPoint;
    _pidCurrent[PIDI] = constrain(_pidCurrent[PIDI], 0, exHigh);
  }

  // DDDDD = fan speed percent per degree of change over TEMPPROBE_AVG_SMOOTH period (Derivative on Measurement)
  _pidCurrent[PIDD] = Pid[PIDD] * (Probes[TEMP_CTRL]->TemperatureAvg - currentTemp);
  // BBBBB = fan speed percent (always 0)
  //_pidCurrent[PIDB] = Pid[PIDB];

  int control = _pidCurrent[PIDP] + _pidCurrent[PIDI] + _pidCurrent[PIDD];
  _pidOutput = constrain(control, 0, 100);
}

void GrillPid::adjustFeedbackVoltage(void)
{
  if (_lastBlowerOutput != 0 && bit_is_set(_outputFlags, PIDFLAG_FAN_FEEDVOLT))
  {
    // _lastBlowerOutput is the voltage we want on the feedback pin
    // adjust _feedvoltLastOutput until the ffeedback == _lastBlowerOutput
    unsigned char ffeedback = analogReadOver(APIN_FFEEDBACK, 8);
    int error = ((int)_lastBlowerOutput - (int)ffeedback);
    int newOutput = (int)_feedvoltLastOutput + (error / 2);
    _feedvoltLastOutput = constrain(newOutput, 1, 255);

#if defined(GRILLPID_FEEDVOLT_DEBUG)
    SerialX.print("HMLG,");
    SerialX.print("SMPS: ffeed="); SerialX.print(ffeedback, DEC);
    SerialX.print(" out="); SerialX.print(newOutput, DEC);
    SerialX.print(" fdesired="); SerialX.print(_lastBlowerOutput, DEC);
    Serial_nl();
#endif
  }
  else
    _feedvoltLastOutput = _lastBlowerOutput;

  analogWrite(PIN_BLOWER, _feedvoltLastOutput);
}

inline unsigned char FeedvoltToAdc(float v)
{
  // Calculates what an 8 bit ADC value would be for the given voltage
  const unsigned long R1 = 22000;
  const unsigned long R2 = 68000;
  // Scale the voltage by the voltage divder
  // v * R1 / (R1 + R2) = pV
  // Scale to ADC assuming 3.3V reference
  // (pV / 3.3) * 256 = ADC
  return ((v * R1 * 256) / ((R1 + R2) * 3.3f));
}

inline void GrillPid::commitFanOutput(void)
{
  unsigned char newFanSpeed;
  if (_pidOutput < _fanActiveFloor)
    newFanSpeed = 0;
  else
  {
    // _fanActiveFloor should be constrained to 0-99 to prevent a divide by 0
    unsigned char range = 100 - _fanActiveFloor;
    unsigned char max = getFanCurrentMaxSpeed();
    newFanSpeed = (unsigned int)(_pidOutput - _fanActiveFloor) * max / range;
  }

  /* For anything above _minFanSpeed, do a nomal PWM write.
     For below _minFanSpeed we use a "long pulse PWM", where
     the pulse is 10 seconds in length.  For each percent we are
     emulating, run the fan for one interval. */
  _longPwmRemaining = 0;
  if (newFanSpeed >= _fanMinSpeed)
    _longPwmTmr = 0;
  else
  {
    unsigned int runningDur = _longPwmTmr * TEMP_MEASURE_PERIOD;
    unsigned int targetDur = (TEMP_LONG_PWM_CNT * TEMP_MEASURE_PERIOD) / _fanMinSpeed * newFanSpeed;
    if (targetDur > runningDur)
    {
      newFanSpeed = _fanMinSpeed;
      _longPwmRemaining = targetDur - runningDur;
      //SerialX.print("HMLG,"); SerialX.print("L:"); SerialX.print(_longPwmRemaining, DEC); Serial_nl();
    }
    else
      newFanSpeed = 0;

    if (++_longPwmTmr > (TEMP_LONG_PWM_CNT - 1))
      _longPwmTmr = 0;
  }  /* long PWM */

  if (bit_is_set(_outputFlags, PIDFLAG_INVERT_FAN))
    newFanSpeed = _fanMaxSpeed - newFanSpeed;

  // 0 is always 0
  _fanPct = newFanSpeed;
  if (_fanPct == 0)
    _lastBlowerOutput = 0;
  else
  {
    bool needBoost = _lastBlowerOutput == 0;
    if (bit_is_set(_outputFlags, PIDFLAG_FAN_FEEDVOLT))
      _lastBlowerOutput = mappct(_fanPct, FeedvoltToAdc(5.0f), FeedvoltToAdc(12.1f));
    else
      _lastBlowerOutput = mappct(_fanPct, 0, 255);
#if (TEMP_OUTADJUST_CNT > 0)
    // If going from 0% to non-0%, turn the blower fully on for one period
    // to get it moving (boost mode)
    if (needBoost)
    {
      analogWrite(PIN_BLOWER, 255);
      // give the FFEEDBACK control a high starting point so when it reads
      // for the first time and sees full voltage it doesn't turn off
      _feedvoltLastOutput = 128;
      return;
    }
#endif
  }
  adjustFeedbackVoltage();
}

unsigned int GrillPid::getServoStepNext(unsigned int curr)
{
#if defined(GRILLPID_SERVO_ENABLED)
  const unsigned int SERVO_STEP = uSecToTicks(15U);
  const unsigned int SERVO_HOLD_SECS = 2U;

  // Hold the servo for SERVO_HOLD_SECS seconds then turn off on the next period
  // when the output is off (allow the damper to close before turning off)
  if (_servoStepTicks >= (SERVO_HOLD_SECS * 1000000UL / SERVO_REFRESH)
    && _pidMode == PIDMODE_OFF)
    return 0;

  // If at or close to target, snap to target
  // curr is 0 on first interrupt
  if (DIFFMAX(_servoTarget, curr, SERVO_STEP) || curr == 0)
  {
    ++_servoStepTicks;
    return _servoTarget;
  }
  // Else slew toward target
  else if (_servoTarget > curr)
    return curr + SERVO_STEP;
  else
    return curr - SERVO_STEP;
#endif
}

inline void GrillPid::commitServoOutput(void)
{
#if defined(GRILLPID_SERVO_ENABLED)
  // Servo is open 0% at 0 PID output and 100% at _servoActiveCeil PID output
  if (_pidOutput >= _servoActiveCeil)
    _servoPct = 100;
  else
    _servoPct = (unsigned int)_pidOutput * 100U / _servoActiveCeil;

  if (bit_is_set(_outputFlags, PIDFLAG_INVERT_SERVO))
    _servoPct = 100 - _servoPct;

  // Get the output position in 10x usec by LERPing between min and max
  unsigned char output;
  output = mappct(_servoPct, _servoMinPos, _servoMaxPos);
  unsigned int targetTicks = uSecToTicks(10U * output);
#if defined(SERVO_MIN_THRESH)
  if (_servoHoldoff < 0xff)
    ++_servoHoldoff;
  // never pulse the servo if change isn't needed
  if (_servoTarget == targetTicks)
    return;

  // and only trigger the servo if a large movement is needed or holdoff expired
  boolean isBigMove = !DIFFMAX(_servoTarget, targetTicks, uSecToTicks(SERVO_MIN_THRESH));
  if (isBigMove || _servoHoldoff > SERVO_MAX_HOLDOFF)
#endif
  {
    ATOMIC_BLOCK(ATOMIC_FORCEON)
    {
      _servoStepTicks = 0;
      _servoTarget = targetTicks;
    }
    _servoHoldoff = 0;
  }
#endif
}

inline void GrillPid::commitPidOutput(void)
{
  calcExpMovingAverage(PIDOUTPUT_AVG_SMOOTH, &PidOutputAvg, _pidOutput);
  commitFanOutput();
  commitServoOutput();
}

boolean GrillPid::isAnyFoodProbeActive(void) const
{
  unsigned char i;
  for (i=TEMP_FOOD1; i<TEMP_COUNT; i++)
    if (Probes[i]->hasTemperature())
      return true;
      
  return false;
}
  
void GrillPid::resetLidOpenResumeCountdown(void)
{
  setPidMode(PIDMODE_RECOVERY);
  LidOpenResumeCountdown = _lidOpenDuration;
}

void GrillPid::setSetPoint(int value)
{
  setPidMode(PIDMODE_STARTUP);
  _setPoint = value;
}

void GrillPid::setPidOutput(int value)
{
  setPidMode(PIDMODE_MANUAL);
  _pidOutput = constrain(value, 0, 100);
}

void GrillPid::setPidMode(unsigned char mode)
{
  _pidMode = mode;
  LidOpenResumeCountdown = 0;
  _pidOutput = 0;
}

void GrillPid::setPidConstant(unsigned char idx, float value)
{
  Pid[idx] = value;
  if (idx == PIDI && value == 0)
    _pidCurrent[PIDI] = 0;
}

void GrillPid::setLidOpenDuration(unsigned int value)
{
  _lidOpenDuration = (value > LIDOPEN_MIN_AUTORESUME) ? value : LIDOPEN_MIN_AUTORESUME;
}

boolean GrillPid::lidModeShouldActivate(int tempDiff) const
{
  // If the pit temperature has been reached
  // and if the pit temperature is [lidOpenOffset]% less that the setpoint
  // and if the fan has been running less than 90% (more than 90% would indicate probable out of fuel)
  // Note that the code assumes we're not currently counting down
  return (LidOpenOffset > 0)
    && isPitTempReached()
    && ((tempDiff * 100 / _setPoint) >= (int)LidOpenOffset)
    && ((int)PidOutputAvg < 90);
}

void GrillPid::reportStatus(void) const
{
#if defined(GRILLPID_SERIAL_ENABLED)
  print_P(PSTR("HMSU" CSV_DELIMITER));
  if (isDisabled())
    Serial_char('U');
  else if (isManualOutputMode())
    Serial_char('-');
  else
    SerialX.print(getSetPoint(), DEC);
  Serial_csv();

  // Always output the control probe in the first slot, usually TEMP_PIT
  Probes[TEMP_CTRL]->status();
  // The rest of the probes go in order, and one may be a duplicate of TEMP_CTRL
  for (unsigned char i = TEMP_FOOD1; i<TEMP_COUNT; ++i)
    Probes[i]->status();

  SerialX.print(getPidOutput(), DEC);
  Serial_csv();
  SerialX.print((int)PidOutputAvg, DEC);
  Serial_csv();
  SerialX.print(LidOpenResumeCountdown, DEC);
  Serial_csv();
  SerialX.print(getFanPct(), DEC);
  Serial_csv();
  SerialX.print(getServoPct(), DEC);
  Serial_nl();

  if (_autoreportInternals)
    reportInternals();
#endif
}

boolean GrillPid::doWork(void)
{
  unsigned int elapsed = millis() - _lastWorkMillis;
  if (_longPwmRemaining && elapsed > _longPwmRemaining)
  {
    analogWrite(PIN_BLOWER, bit_is_set(_outputFlags, PIDFLAG_INVERT_FAN) ? _fanMaxSpeed : 0);
    _longPwmRemaining = 0;
    _lastBlowerOutput = 0;
  }

#if (TEMP_OUTADJUST_CNT > 0)
  if (elapsed > (_periodCounter * (TEMP_MEASURE_PERIOD / TEMP_OUTADJUST_CNT)))
  {
    ++_periodCounter;
    adjustFeedbackVoltage();
  }
#endif

  if (elapsed < TEMP_MEASURE_PERIOD)
    return false;

  _periodCounter = 1;
  _lastWorkMillis = millis();

#if defined(GRILLPID_CALC_TEMP) 
  _alarmId = ALARM_ID_NONE;
  for (unsigned char i=0; i<TEMP_COUNT; i++)
  {
    if (Probes[i]->getProbeType() == PROBETYPE_INTERNAL ||
        Probes[i]->getProbeType() == PROBETYPE_TC_ANALOG)
      Probes[i]->calcTemp(analogReadOver(Probes[i]->getPin(), 10+TEMP_OVERSAMPLE_BITS));

    Probes[i]->processPeriod();

    if (Probes[i]->Alarms.Ringing[ALARM_IDX_LOW])
      _alarmId = MAKE_ALARM_ID(i, ALARM_IDX_LOW);
    else if(Probes[i]->Alarms.Ringing[ALARM_IDX_HIGH])
      _alarmId = MAKE_ALARM_ID(i, ALARM_IDX_HIGH);
  }

  if (_pidMode <= PIDMODE_AUTO_LAST)
  {
    // Always calculate the output
    // calcPidOutput() will bail if it isn't supposed to be in control
    calcPidOutput();
    
    int tempDiff = _setPoint - (int)Probes[TEMP_CTRL]->Temperature;
    if ((tempDiff <= 0) &&
      (_lidOpenDuration - LidOpenResumeCountdown >= LIDOPEN_MIN_AUTORESUME))
    {
      // When we first achieve temperature, reduce any I sum we accumulated during startup
      // If we actually neded that sum to achieve temperature we'll rebuild it, and it
      // prevents bouncing around above the temperature when you first start up
      if (_pidMode == PIDMODE_STARTUP)
      {
        _pidCurrent[PIDI] *= 0.50f;
      }
      _pidMode = PIDMODE_NORMAL;
      LidOpenResumeCountdown = 0;
    }
    else if (LidOpenResumeCountdown != 0)
    {
      LidOpenResumeCountdown = LidOpenResumeCountdown - (TEMP_MEASURE_PERIOD / 1000);
    }
    else if (lidModeShouldActivate(tempDiff))
    {
      resetLidOpenResumeCountdown();
    }
  }   /* if !manualFanMode */
#endif

  commitPidOutput();
  adcDump();
  return true;
}

void GrillPid::reportInternals(void) const
{
#if defined(GRILLPID_SERIAL_ENABLED)
  TempProbe const* const pit = Probes[TEMP_CTRL];
  if (pit->hasTemperature())
  {
    print_P(PSTR("HMPS" CSV_DELIMITER));
    for (unsigned char i=PIDB; i<=PIDD; ++i)
    {
      SerialX.print(_pidCurrent[i], 2);
      Serial_csv();
    }

    SerialX.print(pit->Temperature - pit->TemperatureAvg, 2);
    Serial_nl();
  }
#endif
}

void GrillPid::setUnits(char units)
{
  switch (units)
  {
    case 'A':
    case 'C':
    case 'F':
    case 'R':
      _units = units;
      // Clear the TemperatureAvg to prevent D term jumps on the pit probe
      Probes[TEMP_CTRL]->resetTemperatureAvg();
      break;
    case 'O': // Off
      setPidMode(PIDMODE_OFF);
      break;
  }
}

void GrillPid::setNoisePin(unsigned char pin)
{
  adcState.noise.pinRequested = pin;
  adcState.noise.pinData = 0xff;
  // force update next period
  adcState.noise.dumpPeriod = GRILLPID_NOISE_REPORT_INTERVAL - 1;
}
