CapnBry/HeaterMeter/arduino/heatermeter/grillpid_conf.h

// HeaterMeter Copyright 2019 Bryan Mayland <bmayland@capnbry.net>

#define GRILLPID_CALC_TEMP
#define GRILLPID_SERIAL_ENABLED
#define GRILLPID_SERVO_ENABLED
#define GRILLPID_DYNAMIC_RANGE
//#define GRILLPID_FEEDVOLT_DEBUG

#define TEMP_PIT    0
#define TEMP_FOOD1  1
#define TEMP_FOOD2  2
#define TEMP_FOOD3  3
#define TEMP_CTRL   4 // Just a copy of one of the others
#define TEMP_COUNT  4

#define APIN_FFEEDBACK 1
#define PIN_BLOWER  3
#define PIN_SERVO   8

// Use oversample/decimation to increase ADC resolution to 2^(10+n) bits n=[0..4]
#define TEMP_OVERSAMPLE_BITS 4

// The time (ms) of the measurement period
#define TEMP_MEASURE_PERIOD 1000
// Number of TEMP_MEASURE_PERIOD per Long PWM mode period
#define TEMP_LONG_PWM_CNT 10
// Number of times the ouput is adusted over TEMP_MEASURE_PERIOD
// This affects fan boost mode and PIDFLAG_FAN_FEEDVOLT output
// Set to 0 to disable both of these
#define TEMP_OUTADJUST_CNT 3
// 2/(1+Number of samples used in the exponential moving average)
#define TEMPPROBE_AVG_SMOOTH (2.0f/(1.0f+60.0f))
#define PIDOUTPUT_AVG_SMOOTH (2.0f/(1.0f+240.0f))
// Once entering LID OPEN mode, the minimum number of seconds to stay in
// LID OPEN mode before autoresuming due to temperature returning to setpoint
#define LIDOPEN_MIN_AUTORESUME 30

// Servo refresh period in usec, 20000 usec = 20ms = 50Hz
#define SERVO_REFRESH          20000
// Miniumum number of uS of difference in servo position to force immediate move
// undefine to force continuous servo operation
#define SERVO_MIN_THRESH       50
// Max number of seconds to hold off a servo write due to being below threshold
#define SERVO_MAX_HOLDOFF      10
// Maximum number of usec to busy wait in the event handler to get more accurate
// timing of the servo pulse length
#define SERVO_BUSYWAIT         0
#define GRILLPID_PONMEER_LAMBDA 0.4
// TEMP_MEASURE_PERIODs between sending noise dump
#define GRILLPID_NOISE_REPORT_INTERVAL 5

#define PROBE_NAME_SIZE 13

#if HM_BOARD_REV == 'A'
  #undef GRILLPID_SERVO_ENABLED
#endif
