CapnBry/HeaterMeter/arduino/SMUSHI/Orbitron_Medium_12.h

#pragma once
// Created by http://oleddisplay.squix.ch/ Consider a donation
// In case of problems make sure that you are using the font file with the correct version!
const uint8_t Orbitron_Medium_12Bitmaps[] PROGMEM = {

  // Bitmap Data:
  0x00, // ' '
  0xAA,0xA8,0x80, // '!'
  0xEE, // '"'
  0x09,0x86,0x47,0xF9,0xFE,0x32,0x08,0x8F,0xF9,0x90,0x44,0x00, // '#'
  0x08,0x1F,0xCF,0xFB,0x20,0xC8,0x1F,0xE0,0x88,0x22,0xC8,0x9F,0xE0,0x80, // '$'
  0xE0,0x52,0x12,0x4C,0x7B,0x00,0xC0,0x37,0x8C,0x93,0x12,0x83,0xC0, // '%'
  0x7E,0x1F,0xE2,0x04,0x40,0x0E,0x01,0x32,0x21,0xC4,0x0C,0xFF,0x40, // '&'
  0xA0, // '''
  0x5A,0x49,0x24,0xC0, // '('
  0x9B,0x6D,0xB6,0x80, // ')'
  0x30,0x63,0xF1,0x87,0x80, // '*'
  0x20,0x8F,0x88,0x20, // '+'
  0xA8, // ','
  0xF8, // '-'
  0x80, // '.'
  0x04,0x08,0x30,0xC1,0x04,0x10,0x60,0x80, // '/'
  0x7E,0x7F,0xA0,0xD1,0xA9,0x95,0x8B,0x85,0x82,0xFF,0x00, // '0'
  0x31,0xB4,0x21,0x08,0x42,0x10, // '1'
  0x7E,0x7F,0x80,0x40,0x2F,0xF4,0x02,0x01,0x00,0xFF,0x00, // '2'
  0x7E,0x7F,0x80,0x40,0x27,0xF0,0x08,0x05,0x02,0xFF,0x00, // '3'
  0x02,0x03,0x07,0x86,0x46,0x26,0x13,0xFC,0x04,0x02,0x00, // '4'
  0xFF,0x7F,0xA0,0x10,0x0F,0xF0,0x08,0x05,0x02,0xFF,0x00, // '5'
  0x7E,0x7F,0x20,0x10,0x0F,0xF4,0x0A,0x05,0x02,0xFF,0x00, // '6'
  0xFC,0xFE,0x02,0x02,0x02,0x02,0x02,0x02,0x02, // '7'
  0x7E,0x7F,0xA0,0x50,0x2F,0xF4,0x0A,0x05,0x02,0xFF,0x00, // '8'
  0x7E,0x7F,0xA0,0x50,0x2F,0xF0,0x08,0x04,0x02,0xFF,0x00, // '9'
  0x80,0x08, // ':'
  0x80,0x0A,0x80, // ';'
  0x08,0xE6,0x30,0x60,0xE0,0x80, // '<'
  0xFC,0x03,0xF0, // '='
  0x83,0x07,0x06,0x73,0x08,0x00, // '>'
  0xFE,0x7F,0x80,0x40,0x21,0xF1,0xF0,0x80,0x00,0x20,0x00, // '?'
  0x7E,0x7F,0xA0,0x57,0xAA,0x55,0x2A,0x7D,0x00,0xFF,0x00, // '@'
  0x7E,0x7F,0xA0,0x50,0x28,0x17,0xFA,0x05,0x02,0x81,0x00, // 'A'
  0xFE,0x7F,0xA0,0x50,0x2F,0xF4,0x0A,0x05,0x02,0xFF,0x00, // 'B'
  0x7F,0x7F,0xA0,0x10,0x08,0x04,0x02,0x01,0x00,0xFF,0x00, // 'C'
  0xFE,0x7F,0xA0,0x50,0x28,0x14,0x0A,0x05,0x02,0xFF,0x00, // 'D'
  0xFF,0x7F,0xA0,0x10,0x0F,0xC4,0x02,0x01,0x00,0xFF,0x00, // 'E'
  0xFF,0x7F,0xA0,0x10,0x0F,0xC4,0x02,0x01,0x00,0x80,0x00, // 'F'
  0x7E,0x7F,0xA0,0x10,0x08,0x74,0x3A,0x05,0x02,0xFF,0x00, // 'G'
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
};
const GFXglyph Orbitron_Medium_12Glyphs[] PROGMEM = {
  // bitmapOffset, width, height, xAdvance, xOffset, yOffset
		{     0,   1,   1,   4,    0,    0 }, // ' '
		{     1,   2,   9,   4,    1,   -9 }, // '!'
		{     4,   4,   2,   5,    1,   -9 }, // '"'
		{     5,  10,   9,  11,    0,   -9 }, // '#'
		{    17,  10,  11,  10,    0,  -10 }, // '$'
		{    31,  11,   9,  13,    1,   -9 }, // '%'
		{    44,  11,   9,  12,    1,   -9 }, // '&'
		{    57,   2,   2,   4,    1,   -9 }, // '''
		{    58,   3,   9,   4,    1,   -9 }, // '('
		{    62,   3,   9,   4,    1,   -9 }, // ')'
		{    66,   7,   5,   7,    0,   -9 }, // '*'
		{    71,   6,   5,   6,    0,   -6 }, // '+'
		{    75,   2,   3,   3,    1,   -1 }, // ','
		{    76,   6,   1,   7,    1,   -4 }, // '-'
		{    77,   2,   1,   4,    1,   -1 }, // '.'
		{    78,   7,   9,   7,    0,   -9 }, // '/'
		{    86,   9,   9,  11,    1,   -9 }, // '0'
		{    97,   5,   9,   6,    0,   -9 }, // '1'
		{   103,   9,   9,  11,    1,   -9 }, // '2'
		{   114,   9,   9,  11,    1,   -9 }, // '3'
		{   125,   9,   9,  10,    0,   -9 }, // '4'
		{   136,   9,   9,  11,    1,   -9 }, // '5'
		{   147,   9,   9,  11,    1,   -9 }, // '6'
		{   158,   8,   9,   9,    0,   -9 }, // '7'
		{   167,   9,   9,  11,    1,   -9 }, // '8'
		{   178,   9,   9,  11,    1,   -9 }, // '9'
		{   189,   2,   7,   4,    1,   -7 }, // ':'
		{   191,   2,   9,   3,    1,   -7 }, // ';'
		{   194,   6,   7,   7,    0,   -7 }, // '<'
		{   200,   7,   3,   9,    1,   -5 }, // '='
		{   203,   6,   7,   7,    1,   -7 }, // '>'
		{   209,   9,   9,   9,    0,   -9 }, // '?'
		{   220,   9,   9,  11,    1,   -9 }, // '@'
		{   231,   9,   9,  11,    1,   -9 }, // 'A'
		{   242,   9,   9,  11,    1,   -9 }, // 'B'
		{   253,   9,   9,  11,    1,   -9 }, // 'C'
		{   264,   9,   9,  11,    1,   -9 }, // 'D'
		{   275,   9,   9,  10,    1,   -9 }, // 'E'
		{   286,   9,   9,  10,    1,   -9 }, // 'F'
		{   297,   9,   9,  11,    1,   -9 }, // 'G'
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
};
const GFXfont Orbitron_Medium_12 PROGMEM = {
(uint8_t*)Orbitron_Medium_12Bitmaps,(GFXglyph*)Orbitron_Medium_12Glyphs,0x20, 0x7E, 12 };
