CapnBry/HeaterMeter/arduino/heatermeter/ledmanager.h

// HeaterMeter Copyright 2019 Bryan Mayland <bmayland@capnbry.net>
#ifndef __LEDMANAGER_H__
#define __LEDMANAGER_H__

#include <Arduino.h>

#define LEDSTIMULUS_INVERT 0x80
#define LEDSTIMULUS_MASK   0x7f
#define LEDSTIMULUS_Off       0
#define LEDSTIMULUS_Alarm0L   1
#define LEDSTIMULUS_Alarm0H   2
#define LEDSTIMULUS_Alarm1L   3
#define LEDSTIMULUS_Alarm1H   4
#define LEDSTIMULUS_Alarm2L   5
#define LEDSTIMULUS_Alarm2H   6
#define LEDSTIMULUS_Alarm3L   7
#define LEDSTIMULUS_Alarm3H   8
#define LEDSTIMULUS_RfReceive 9
#define LEDSTIMULUS_LidOpen   10
#define LEDSTIMULUS_FanOn     11
#define LEDSTIMULUS_PitTempReached 12
#define LEDSTIMULUS_FanMax    13
#define LEDSTIMULUS_AlarmAny  14
#define LEDSTIMULUS_Startup   15
#define LEDSTIMULUS_Recovery  16

#define LEDACTION_Off         0 // Must be == false
#define LEDACTION_OnSteady    1 // Must be == true
#define LEDACTION_OneShot     2

#define LED_COUNT 4

typedef struct tagLedStatus
{
  // config
  unsigned char stimulus;    // LEDSTIMULUS_* and possible LEDSTIMULUS_INVERT
  // state
  unsigned char triggered;   // LEDACTION_*
  unsigned char on;          // LEDACTION_*
} led_status_t;

class LedManager
{
public:
  typedef void (*led_executor_t)(unsigned char led, unsigned char on);

  LedManager(const led_executor_t executor) :
    _executor(executor) { }

  void publish(unsigned char stimulus, unsigned char action);
  void doWork(void);
  void setAssignment(unsigned char led, unsigned char ledconf);
  unsigned char getAssignment(unsigned char led) const { return _leds[led].stimulus; }

private:
  led_status_t _leds[LED_COUNT];
  unsigned long _blinkMillis;
  unsigned char _blinkCount;
  boolean _hasRunOnce;
  led_executor_t _executor;
};

#endif /* __LEDMANAGER_H__ */
