CapnBry/HeaterMeter/arduino/heatermeter/menus.cpp

// HeaterMeter Copyright 2019 Bryan Mayland <bmayland@capnbry.net>
#include "Arduino.h"
#include <avr/pgmspace.h>
#include "menus.h"

MenuSystem::MenuSystem(const menu_definition_t *defs, const menu_transition_t *trans,
  const buttonread_t reader)
  : m_definitions(defs), m_transitions(trans), m_readButton(reader)
  // State(ST_NONE), m_lastButton(BUTTON_NONE)
{
}

inline unsigned long MenuSystem::getTimeoutDuration(void) const
{
  return (m_currMenu) ? (unsigned long)pgm_read_byte(&m_currMenu->timeout) * 1000 : 0;
}

inline handler_t MenuSystem::getHandler(void) const
{
  return (m_currMenu) ? (handler_t)pgm_read_word(&m_currMenu->handler) : 0;
}

inline boolean MenuSystem::getHasLongpress(button_t button) const
{
  return (m_currMenu) ? pgm_read_byte(&m_currMenu->longpress) & button : false;
}

inline state_t MenuSystem::findTransition(button_t button) const
{
  const menu_transition_t *trans = m_transitions;
  state_t lookup;
  while ((lookup = pgm_read_byte(&trans->state)))
  {
    if (lookup == m_state)
    {
      button_t transButton = pgm_read_byte(&trans->button);
      // If transButton contains button
      // OR transButton contains LONG and button contains LONG
      if (((button | BUTTON_LONG) & transButton) == button)
        return pgm_read_byte(&trans->newstate);
    }
    ++trans;
  }
  return m_state;
}

void MenuSystem::setState(state_t state)
{
  //Serial.print("$HMLG,Setting state: "); Serial.println(state, DEC);
  if (state == ST_LAST)
    state = m_lastState;
  if (state != m_state)
    m_lastState = m_state;

  while (state > ST_VMAX && state != m_state)
  {
    handler_t handler = getHandler();
    if (handler)
      handler(BUTTON_LEAVE);

    m_state = state;
    m_currMenu = m_definitions;
    m_buttonRepeatCnt = 0;
    m_updateDisplay = NULL;

    state_t lookup;
    while ((lookup = pgm_read_byte(&m_currMenu->state)))
    {
      if (lookup == m_state)
        break;
      ++m_currMenu;
    }
    
    if (m_currMenu)
    {
      handler = getHandler();
      if (handler)
        state = handler(BUTTON_ENTER);
    } else {
      state = ST_NONE;
    }
  }  // while state changing

  m_lastStateChange = millis();
}

void MenuSystem::doWork(void)
{
  // Operate button loop at 4Hz unless no button has been pressed in one cycle
  unsigned long now = millis();
  if (now - m_lastButtonActivity < 250)
    return;

  button_t button = m_readButton();
  if (button == BUTTON_NONE)
  {
    unsigned long dur = getTimeoutDuration();
    if (dur != 0 && now - m_lastStateChange > dur)
      button = BUTTON_TIMEOUT;
  }
  else
    m_lastButtonActivity = now;

  if (button != BUTTON_TIMEOUT)
  {
    if (button == m_lastButton)
    {
      if (m_buttonRepeatCnt < 0xff)
        ++m_buttonRepeatCnt;
      if (m_buttonState != mbsNone)
      {
        if (m_buttonState == mbsLongCheck && m_buttonRepeatCnt > 3)
        {
          button |= BUTTON_LONG;
          m_buttonState = mbsWaitForKeyup;
        }
        else
        {
          m_lastStateChange = now;
          return; // waiting for longpress/keyup
        }
      }
    }
    else
    {
      m_buttonRepeatCnt = 0;
      if (button == BUTTON_NONE)
      {
        if (m_buttonState == mbsLongCheck)
        {
          //Serial.print("on keyup="); Serial.println(m_lastButton, HEX);
          // If longpress never triggered, trigger the held button on release
          button = m_lastButton;
        }
      }
      else if (getHasLongpress(button))
      {
        //Serial.println("Starting new longpress");
        // Starting a new longpress
        m_lastButton = button;
        m_buttonState = mbsLongCheck;
        return; 
      }

      m_lastButton = button;
      m_buttonState = mbsNone;
    }
  }

  if (button == BUTTON_NONE)
    return;

  //Serial.print("$HMLG,New button: "); Serial.println(button, HEX);

  state_t newState = ST_AUTO;
  handler_t handler = getHandler();
  if (handler != NULL)
    newState = handler(button);
  if (newState == ST_AUTO)
    newState = findTransition(button);

  setState(newState);
  updateDisplay();

  // If the new state has a longpress handler, force waiting for keyup
  if (getHasLongpress(button))
    m_buttonState = mbsWaitForKeyup;
}
