CapnBry/HeaterMeter/arduino/MeterMonitor/segment_chars.h

#pragma once

#define TM1637_C 0b01011000
#define TM1637_D 0b01011110
#define TM1637_E 0b01111011
#define TM1637_F 0b01110001
#define TM1637_G 0b01101111
#define TM1637_I 0b00000100
#define TM1637_L 0b00111000 // capital
#define TM1637_M 0b00010101
#define TM1637_N 0b01010100
#define TM1637_O 0b01011100
#define TM1637_P 0b01110011
#define TM1637_R 0b01010000
#define TM1637_S 0b01101101
#define TM1637_T 0b01111000
#define TM1637_V 0b00011100
#define TM1637_W 0b00101010
