CapnBry/HeaterMeter/(commit log)

2010-08-02 Remove unused vars in PID control Add serial output
2010-08-02 Convert PID control to be more based on the Arduino PID Library by Brett Beauregard http://www.arduino.cc/playground/Code/PIDLibrary
2010-08-10 Wireless added, button code working (?) and in main, editing string still doesn't work
    [menus.cpp, menus.h]
2010-08-11 "working" string editor Fixed LEFT bug on probe offset 2 Fixed LidDuration messing up LidOffset Changed to debounce by 250ms rather than repeat, as my down button actually trails off when you release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
    [menus.cpp]
2010-08-15 30 sec temp averaging for Derivitive controller URLs for PID info
2010-08-23 Fix JSON output bug Reduce default SetPoint to 225F and PidD to 1.4f Use dataflash buffer page to store recent temp readings Fix broken setpoint/pid urls flash_file_t is now flash_file Add temporary 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
    [grillpid.cpp, grillpid.h, menus.cpp, strings.h]
2010-08-23 Convert TempProbe::Temperature to float
2010-08-24 Added PidB (BIAS) to controller and EEPROM PID now calculates a PWM 0-255 directly to allow finer grained fan control. Pid constants for P and B values adjusted to new scale. I and D are not dependen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
    [grillpid.cpp, grillpid.h, strings.h]
2010-09-04 Fix bug causing every sample to reset the average Default pidb is 25 (10% speed) Renamed outputRaw to outputCsv
    [grillpid.cpp, grillpid.h]
2010-09-12 Increase Kd to 2.0f Increase temp avg period to 30 EEPROM not reset every startup Reset integral sum when the temperature is first reached
    [grillpid.cpp]
2010-09-16 Fix bug preventing setting of PID parameters, PID_ORDER wasn't PROGMEM
    [strings.h]
2010-09-16 Add "long PWM". For fan speeds (F) under 10%, run the fan at 10% for F seconds out of every 10. This should prevent fan stalls while attempting to run low voltages.
    [grillpid.cpp, grillpid.h]
2010-09-17 Turn the fans off when there's no pit probe detected
2010-09-17 Reduce pidErrorSum decay range to -1.0, because with the new PID bias I don't think this kludge is even needed any more Increase default Kd to 10.0f, the D term seems to be the most useful in that as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
    [grillpid.cpp, heatermeter.pde]
2010-10-18 FIXED: Setting the SetPoint to a higher value, more than LidOffset, would trigger lid detect mode. GrillPid::SetPoint is now accessed via getter/setter
    [grillpid.cpp, grillpid.h, heatermeter.pde]
2010-10-18 Added Manual Fan Mode -- GrillPid::setFanSpeed() sets the fan into manual mode -- GrillPid::setSetPoint() sets the fan into auto mode -- GrillPid::getManualFanMode() returns the current value Added m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
    [grillpid.cpp, grillpid.h, heatermeter.pde, strings.h]
2010-10-19 Create new define for APP_WISERVER, HEATERMETER_NETWORKING. Reorganize code to prevent Arduino preprocessor from messing up the function prototypes. Should now be able to comment out the one define t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
    [heatermeter.pde, strings.h]
2010-10-25 -- Added MINIMUM_FAN_SPEED define -- Added GrillPid::MaxFanSped member for max speed that can be set by automatic mode (in percent) -- Will no skip Ambient temperature on home menu if no ambient prob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
    [grillpid.cpp, grillpid.h, heatermeter.pde, strings.h]
2010-11-12 Red/blue derivative indicators to temperature Popup editors (don't work) More robust JSON calls Favicon is image/x-icon
2010-11-20 Fix bug where manually enabling lid open mode would allow an error sum to build and keep the temperature aboves setpoint for a long time Remove some redundancy of when fanspeed should be set to 0 for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
    [grillpid.cpp]
2010-11-20 Fix a bug in the antiwindup code which was preventing the error sum from decaying unless the error was [0,-1] degrees Remove the 1 degree grace area. This is handled by Kb.
    [grillpid.cpp]
2010-11-20 In calFanSpeed() use a signed 2byte integer for the calculated fan speed rather than a float. Should still prevent overflow while saving 40 bytes of code.
    [grillpid.cpp]
2010-11-22 Oops [44] wasn't really a bug, but this fixes the actual bug added in [42].
    [grillpid.cpp]
2010-11-29 Adding probe alarms part 1. No config yet
2010-11-30 Split heatermeter.pde into hmcore and hmmenus
2010-11-30 Replace TEMP_AVG_COUNT_LOG2 with TEMP_AVG_COUNT. The old LOG2 optimization was removed long ago and this makes the code more clear
    [grillpid.cpp]
2011-02-01 More alarm work Removed menuConnecting if no HEATERMETER_NETWORKING Default Kd changed from 4.0 to 2.5 EEPROM Magic changed because it was only 28 bits, added 0
2011-02-01 FIXED: On first bootup, the display would not update for 1 second due to there being no updateDisplay() if no probes are active (which is always the case on startup)
    [hmmenus.cpp]
2011-02-01 FIXED: Blank display when no FOOD or AMB probe. Thanks to Ed Pinnell for troubleshooting.
    [hmcore.cpp]
2011-02-01 No longer use partial temperature reads (where probes were either inserted or removed mid-period). If an probe is not preset for any of the reads, discard its value for that period.
    [grillpid.cpp, grillpid.h]
2011-02-11 Added jQuery include, rewrite ajax, working setters for probename and setpoint, last update time indicator
2011-02-11 Move the lastupdate timer a couple pixels more into the corner Convert line endings to UNIX
2011-02-16 Just a dumb parameter rename to save a couple bytes and increase consistency
2011-02-16 Also reject any temperature reads of MAX (1023) in addition to MIN (0)
2011-02-16 Also reject any temperature reads of MAX (1023) in addition to MIN (0), r62 actual change
2011-02-16 Added support for serial command URLs outputCsv() to serial every temperature pulse
2011-02-21 A little cleanup removal of probe alarms to make a release version. Adds the comment to look in hmcore.h
2011-02-24 Fixed bug where menus set to 0 timeout would always timeout immediately (no current menus were affected). Also saves 2 bytes of code space so win-win!
    [menus.cpp]
2011-02-24 Only check the serial port for data on new temperature pulse. This should be ok considering the low bandwidth of the incoming data and rightly puts in inside the HEATERMETER_SERIAL define
2011-02-24 Add a comment about why the includes are needed. dataflash.h should technically be in the proper define but because there is no static data in the header it doesn't hurt.
    [heatermeter.pde]
2011-03-12 Added WiFi LED pin reminder
2011-03-12 Return to using out.println(), better to use the standard function
2011-03-12 Just a reminder that the wifi params are in heatermeter.pde
2011-03-12 Switch to using WiFi params from the WiShield development branch
2011-03-17 Added Wireless Signal strength and SSID information to menus (before Reset Config). Press Up/Down buttons while on the screen to refresh the value.
    [hmmenus.cpp, hmmenus.h, strings.h]
2011-03-19 Fix serial only compilation
    [hmmenus.cpp, hmmenus.h]
2011-03-31 revert r87 and r91 as the WiShield contrib branch didn't work at all for me with the brief amount of time I had with s WiShield. Will come back some day if I manage to come by another WiShield, as As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
    [heatermeter.pde, hmmenus.cpp, hmmenus.h]
2011-03-31 Fix conditional compilation for no HEATERMETER_SERIAL and no (SERIAL|NETWORK)
    [hmcore.cpp]
2011-03-31 Another include in the wrong place, ShiftRegLCD.h should be in hmcore.h
    [grillpid.h, hmcore.h]
2011-03-31 Change default probe biasing resistors to 10k ohm (from 22k)
2011-04-04 Grr wrong case, readding file
2011-04-04 This should have been what was in [102], replace \ with / in header includes
    [strings.h]
2011-04-04 Fix missing default probe offset for TEMP_AMB. It still defaulted to 0 from what I can tell though, so no big deal.
    [hmcore.cpp]
2011-04-08 Convert to use 2 second PID updates from 1s. -- Adjust ADC sample rate (default now 250ms apart) -- Long PWM now only has 5 periods of 2s each -- Halve number of samples in the moving avg -- Double K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
2011-04-16 Missed a couple relative paths which prevented things from being created properly
2011-04-21 Changed average fan indicator to be a 'bullet' instead of a separate bar
2011-04-22 HTML fixups including IE7/8/9c adjustment of fanspeed bar Color reductions Pit temperature font size decrease Adjust fire background to anchor bottom left so you see more of it Blower speed font size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
2011-04-22 For graph tooltip attempt to lerp between nearest 2 points instead of just using 1. Fix discontinuous datasets (where you unplug a probe and replug it) -- The old bevior would draw a line between the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
2011-04-22 Fix screwy graph data that occurs if the json update occurs while the user is in the middle of selecting a new range
2011-04-26 Default build no longer includes HEATERMETER_NETWORKING
    [hmcore.h]
2011-04-30 Add /reboot URL to reset the avr using digital pin 9
    [hmcore.cpp, strings.h]
2011-04-30 Change pin 5 to LCD_BACKLGHT and 6 to ALARM to standardize the new pinouts
2011-05-02 Change Lid Open Offset to be a percentage of setpoint rather than a fixed amount
    [grillpid.cpp, hmcore.cpp, hmmenus.cpp]
2011-05-06 First shot at per probe configuration
2011-05-06 Fix Ambient temp not being read. Grr how did this get committed.
    [grillpid.cpp]
2011-05-06 Shorten default stenhart coeffs
    [hmcore.cpp]
2011-05-06 Remove all the serial debugging of the probeconfig
2011-05-06 Don't need to inc the vals ptr because atof() will remove the whitespace I think. Save a couple bytes
2011-05-07 Forgot to reorder the default probe config to go with the new structure
2011-05-08 Add an experimental "degrees per hour" counter to the Food1 probe Remove useless style in pnames
2011-05-08 Up the UART baud rate to 115200 Testing shows it doesn't look to draw any more power and this way we match avrdude
    [hmcore.cpp]
2011-05-08 Take the delay out of the reboot function, set linkmeter baud to 115200
    [hmcore.cpp]
2011-05-08 Stop using println() for normal stuff. I hate CRLF!
2011-05-09 Actually use HEATERMETER_SERIAL to define the baud rate
2011-05-09 Added /set?lb=X to set LCD backlight (0-255) You'll lose your configuration again but I've moved the probe structs away from the base struct a little to make some room
2011-05-14 [www] De-emphasize the Ambient temperature in the graph
2011-05-15 [www] Remove graph legend and use the probename boxes instead
2011-05-15 [eagle] LinkMeter schematic 2.51 PNG
2011-05-16 Add HeaterMeterSerialGraph
2011-05-16 [tools] The HeaterMeter WiShield dataflash upload program ArduinoSerialUpload
2011-05-17 [www] Move Setpoint up to be on the same line as the current pit temperture. Remove default black text shadows
2011-05-23 [tools] Fix graph fan speed using same series as setpoint
2011-05-23 [utils] Make fan speed have a fixed range on graph
2011-05-28 [lm] Updated to support new setment ID prefixes. Reads probenames and RF manager data too
2011-05-28 [hm] Added /set?pn@XX to report current probe names (serial only)
2011-05-28 [hm] Incompatible CSV output changes CSV output now starts with "$HMSU" (HeaterMeter State Update) Rempve average temperatures from the CSV output Remove /csv from available web URLs
    [hmcore.cpp]
2011-05-28 [hm] Oops errant "f" makes pasting 10k thermistor comment broken
    [hmcore.cpp]
2011-05-28 [hm] Force a single temperature reading on startup This also moves the _accumulatedCount into each probe for use when the RFM12B will be updating it
2011-05-28 [hm] Protect TempProbe::ProbeType and reset the accumulator when changing types
    [grillpid.cpp, grillpid.h]
2011-05-28 [hm] Fixed bug preventing every temperature measurement besides the first
    [grillpid.cpp, grillpid.h]
2011-05-28 [hm] Added RFM12B wireless manager
2011-05-28 [lm] Remove average temperatures from json
2011-05-28 [lm] Remove superflous probeName array and fix serial device file mode
2011-05-29 [hm] Fix bug making every probe the same type as TEMP_FOOD1, reset Temperature on type change, include probeType in /set?pcX
    [grillpid.cpp, hmcore.cpp]
2011-05-29 [hm] Always report probeNames after /set?pnX url
2011-05-29 [hm] Add /set?rm= for RF12Source to pid.Probe mapping
2011-05-30 [lm] Added wireless status icons to probe displays if they are mapped
    Icons are based on the WooThemes Ultimate Icon Set (GPL)
    http://www.woothemes.com/
2011-05-30 [www] Fix not being able to set probe names. When did this ever work?
2011-06-05 [lm] Lid detect is negative when placed in the fan column of the RRD
2011-06-05 [www] New 24x24 wireless status icons instead of 32x32
2011-06-05 [www] Fix degrees per hour not showing up in probe boxes
2011-06-06 [hm] Swap the SOFTRESET and WIRELESS_LED pins, causing great harm to my development platform
    [hmcore.h]
2011-06-06 [hm] Switch Serial.print(char) to use Serial.write() saves 200 bytes
2011-06-06 [hm] Change RF signal meter to only track the last 8 packets and output the battery level rather than just lowbatt
2011-06-06 [lmr] Better basic remote code supports up to 4 analog probes, LEDs
2011-06-06 [hm] Fix new battery level position in __rfm12_probe_update_hdr
    [rfmanager.cpp]
2011-06-06 [hm] Add ATMega328 physical pin information to pins
2011-06-06 [lmr] Fix remote transmitting uninitialized data
    [lmremote.pde]
2011-06-07 [hm] Fix RF probes not going stale
    [rfmanager.cpp, rfmanager.h]
2011-06-08 [hm] Analog0 is pin 23. Thanks, Ed!
2011-06-08 [www] 'yellow' rf indicator now goes from 127-254, which is one missing packet by current code
2011-06-10 [hm] Some #define cleanup and build fixes for RFM12/NETWORKING builds
    [hmcore.cpp]
2011-06-10 [hm][lmr] Remotes no longer send their ID explicitly, they broadcast with their own ID
    [hmcore.cpp, lmremote.pde, rfmanager.cpp, rfmanager.h]
2011-06-10 [hm] Fix rf receive looking only for directed packets
    [rfmanager.cpp]
2011-06-10 [lmr] A few more power saving items enabled
2011-06-12 [hm] Don't use 0.0f/-1.0f to indicate lack of temperature. Now outputs "U" for no temperature.
2011-06-12 [lmr] Fix swapped ADC enabling order. Now sleeps with ADC PRRed off
    [lmremote.pde]
2011-06-12 [www] Pit temperature now on top of others on graph. Z-order is now Pit,Food1,Food2,Ambient,Set,Lid,Fan
2011-06-12 [www] Try harder to get exact data out of rrdtool fetch
    rrdtool always give you one extra row of data beyond what you query for (v1.4.5 currently). If now is the exact time a new chunk was added, we'll also get a second row full of NaN because data hasn't been added yet. We play it safe and try to eat those NaN rows, without backing up the window so far that it it extends beyond the beginning of the database, which will bump up the rate to the next largest value.
2011-06-13 [lmr] Fix sleep mode brownout detector disable fail, PRR set in setup(), digital input on analog ins disabled
    [lmremote.pde]
2011-06-16 [hm] Make a remote probe clear its Temperature value (indirectly) if it isn't found in the rfmanager. Not yet working because the rfmanager has to receive a packet to trigger the call and how is that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
2011-06-17 [hm] Arduino dependency fix for RF12 sort of requiring Ports
    [heatermeter.pde]
2011-06-17 [www] Add dph for all 3 montior probes, only require 59m30s data, format timers more nicely
2011-06-17 [www] Add battery level to JSON and RF tooltip
2011-06-17 [www] Graph tooltip now has the arrow on the center bottom, should make it easier to track across graph
2011-06-22 [wrt] Add broadcomm SDHC driver for 2.6/brcm47xx Thanks to zinc on the OpenWrt forums for providing a working package https://forum.openwrt.org/viewtopic.php?id=30322
2011-06-29 [lmr] New 4x battery level sampling, use analog internal pullups to power probe reads
2011-06-29 [lmr] Change to using digital pins to source supply voltage to the probe dividers. Support disabling LEDs
2011-06-29 [hm] Slightly more accurate vishay thermistor coefficients
2011-07-01 [lmr] Remove rf12_doWork() from main loop as it would occasionally prevent the CPU from entering power down sleep mode Also wait for the RF transmission to complete using STANDBY mode instead of IDLE
    [lmremote.pde]
2011-07-01 [hm] Added /config to dump current config report. For now only dumps Probe names PID parameters Probe Offsets RF Map
2011-07-01 [hm] Fix not reporting new rfMap when changing probetype from RFM12
    [hmcore.cpp]
2011-07-01 [wrt] Added ext4, block-mount, hostapd-mini, linkmeter, and prereqs to base image
2011-07-02 [lm] The ltn12 pump closes the source file so our close throws an error
2011-07-03 [lm] A commented out battery test line into linkmeterd
2011-07-04 [lm] Switch to using straight CSV for history output. Also buffer the data and send it all at once which is about 150ms faster
2011-07-05 [lm] Added /admin/lm/stashdb
    Parameters:
    reset=1 means to just reset the current running database
    restore=1 restore from the stashpath to the active database
    rrd=(filename) the stash filename to stash to or from can not contain a path
2011-07-14 [www] Clicking the legend boxes for the food probes toggles graphing them
2011-07-25 [doc] Typo. The TRM rf map only supports up to pin 5
2011-07-25 [hm] Fix compliation with no RFM12
    [hmcore.cpp]
2011-08-09 [lm] Convert linkmeterd.lua to being a LuCId service. Adds UNIX socket
2011-08-09 [lm] Add basic linkmeter socket client
2011-08-09 [lm] Fix json queryi to /lm/hmstatus, now reads from linkmeterd socket. Adds /lm/rfstatus
2011-08-09 [www] Fix tooltip probe names not updating until after graph loads
2011-08-09 [lm] Set the lucid threadlimit to 2 on install to work around eager browsers
2011-08-21 [hm] Fixed bugs in WiShield code so fix parameters and re-add menmenuNetworkInfo()
    [hmcore.cpp, hmmenus.cpp, hmmenus.h, wishieldconf.h]
2011-08-21 [hm] Fixup old webpage and file sizes for WiShield heatermeters
2011-09-14 [wrt] Updated broadcom SDHC driver to fix hanging when enabled
    [bcm_sdhc.c, spi.c]
2011-09-20 [eagle] LinkMeter 3.0 test board
    [LinkMeter-Button.sch, LinkMeter-External.sch, LinkMeterHM.brd, LinkMeterHM.sch]
2011-09-20 [hm] Fix for dynamic mss with WiShield.
    [hmcore.cpp]
2011-09-20 [hm] RF Probes now drop off when they go stale instead of hanging around forever. Also get a HMRF immediately.
    Still broken: A remote can still show in HMRF after it goes stale. Adding this adds 50 bytes of code and I don't care about it that much
    [hmcore.cpp, rfmanager.cpp, rfmanager.h]
2011-09-20 [hm] Blink the wireless LED on startup BLINK 1: Booted BLINK 2: Initialization complete I'm not sure if I like delaying the boot process just to blink though...
2011-09-20 [hm] Only init RFManager if we have probes of type PROBETYPE_RFM12
2011-09-20 [hm] Disable RF LED blinking on WiShield devices to prevent it from turning it off after association
    [hmcore.cpp]
2011-09-20 [www] Fix for WiShield index page not being able to set probe names
2011-09-20 [eagle] LinkMeterHM 3.1 INCOMPLETE Do not build from this schematic
    [LinkMeterHM.brd, LinkMeterHM.sch]
2011-09-23 [eagle] Fix probe resistors were supposed to be pullups not pulldowns 100u/6.3 5V power cap changed to 100u/10 10u/6.3 3.3V power cap changed to 22u/6.3V Rerouted: 0 via 60.6 trace Thanks Ed!
    [LinkMeterHM.brd, LinkMeterHM.sch]
2011-09-24 [eagle] Fix inconsistent brd/sch
    [LinkMeterHM.sch]
2011-09-24 [eagle] Replace parts with some custom packages Diode library DO41-7 and D-5 replaced with 0.04drill octagon pad Jumper JP1 part replaced with 0.04drill RESONATOR-PTH replaced with 0.032dril R15 resi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
    [LinkMeterHM.brd, LinkMeterHM.sch]
2011-09-25 [eagle] Add LinkMeterHM.png schematic for v3.1
2011-09-25 [eagle] Rerouted, swap D2/R8, D2->7.5mm, add probe name silk 0 vias, 59.9 trace
    [LinkMeterHM.brd, LinkMeterHM.sch]
2011-10-04 [eagle] Fix external and button board plug inconsistencies. Rename DC power jack to J9
    [LinkMeter-Button.sch, LinkMeter-External.sch, LinkMeterHM.brd, LinkMeterHM.sch]
2011-10-14 [hm] Fix Therm / R unused code comment
    [grillpid.cpp]
2011-10-14 [eagle] Bottom board silk was mirrored
    [LinkMeterHM.brd]
2011-10-18 [hm] Add int main(void) instead of using default Arduino
2011-10-18 [eagle] Replace 74HC164N with 74LS164N Fix IC2 (atmega) silk size
    [LinkMeterHM.brd, LinkMeterHM.sch]
2011-10-18 [hm] Fix bug causing double-duration fan running in long PWM mode
    [grillpid.cpp]
2011-10-18 [eagle] Replace 100u power caps with 47u, Arduino Standard
    [LinkMeterHM.brd, LinkMeterHM.sch]
2011-10-31 [hm] Fix incorrect comment about thermistor part number
    [hmcore.cpp]
2011-12-11 [hm] Fix menu formating for max fan speed and boolean edits
    [hmmenus.cpp]
2011-12-11 [hm] Add LIDOPEN_MIN_AUTORESUME Once entering LID OPEN mode, the minimum number of seconds to stay in LID OPEN mode before autoresuming due to temperature returning to setpoint. Thanks to Dave Peart
2011-12-11 [hm] Fix probename compile error if someone wants to turn it on
    [hmmenus.cpp]
2011-12-11 [hm] Fix bad setter of lid open duration
    [grillpid.cpp]
2011-12-11 [hm] Add a small 10ms delay to blinking the wireless LED when we recieve. May need to be longer
2011-12-13 [lm] Add delete, clear, activate, description to archive list
    Clear - resets current running database
    Activate - adds ability to set any database from within the last 24 hours as the current
    Description - If a text file with the same name as the rrd is found, display the contents
    Adds delete=1 option to stashdb
2011-12-13 [lm] Print current HeaterMeter version after AVR update
2011-12-14 [lm] Fix for not proplerly setting B and C probe coefficients. How did this work ever?
2011-12-14 [lm] Fix up some jquery calls, use proper url params to fix some probe name values being not urlencoded properly
2011-12-16 [wrt] nixio abstract socket name fix
2011-12-20 [hm] Use 3 bit oversampling on ADC reads, thanks Dave Peart. Temporarily breaks RFM12
2011-12-23 [lm] Optimize streaming updates for lower garbage pressure, faster segSplit()
2012-01-08 [hm] Add support for SPI-connected LCD via shift register. Also bugfixes the 50ms startup delay, which was only actually waiting 3ms
    [hmcore.cpp, hmcore.h]
2012-01-08 [hm] Upgrade to Arduino 1.0
2012-01-08 [eagle] The probes in the external schematic were connected backward
    [LinkMeter-External.sch]
2012-01-08 [hm] Remote probes should now send their ADC resolution which must be less than or equal to the master's. Update UCID version to 201201080
2012-01-08 [lmr] Update to Arduino 1.0, send ADC bits of 10
2012-01-08 [lmr] Try to stabilize the ADC when returning from sleep and don't sleep while waiting for RFM to send
    [lmremote.ino]
2012-01-08 [hm] RFManager now print last receive time for node A, even if that receive was bad CRC
2012-01-10 [eagle] V3.2 draft with 74HC595 shift register
    [LinkMeterHM.brd, LinkMeterHM.sch]
2012-01-10 [hm] SPI LCD is on the clock line, not data in V3.2 schematic
2012-01-19 [lm] Pretty up the probe configuration page
2012-01-20 [lm] Add probe coefficients preset popup
2012-01-22 [lm] Reorder the probes on the graph tooltip Pit F1 F2 F3 Set Fan
2012-01-24 [lm] Add hmdude, avrdude replacement
    [fileio.c, fileio.h, hmdude.c]
2012-01-26 [lm] Add /lm/conf and switch to using a modal iframe dialog on conf page
2012-01-26 [lm] jquery the conf page, fix resist paste bug
2012-01-26 [hm] Convert PID I and D constants to not be dependent on (multiplied by) P term
2012-01-26 [hm] Reduce temperature probe average count to 10 samples It seems the response time from fan on to temperature starting to go back up is around 45 seconds so I imagine we want our derivative to canc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
2012-01-26 [hm] Reset PID integral error sum when changing Ki
    [grillpid.cpp, grillpid.h, hmcore.cpp]
2012-01-26 [hm] Lower PID constants to 4, 3, .01, 5
2012-01-26 [hm] Fix rf signal meter resetting on each receive
    [rfmanager.cpp]
2012-01-26 [lm] Allow negative setpoints for manual fan
2012-02-03 [lm] Add heatermeter firmware table, none of this works on IE until IE 10
2012-02-06 [lm] Fix coefficient preset always only updating the first probe selected
2012-02-07 [hm] Added piezo buzzer support with beepbeepbeep tone
    [hmcore.cpp, hmcore.h]
2012-02-07 [hm] Convert /set?ld and /set?po and /set?pc to use new parse functions
    pcX=? no longer uses 0 as a placeholder!
    po= is all on one line now
    lo= no longer used
    [hmcore.cpp, hmcore.h, hmmenus.cpp]
2012-02-12 [eagle] Silk and dimension tweaks
    Pulled mitered FTDI corner in tiny bit, redrew dimension lines
    Shifted whole board down 0.01" inside dimension
    Capacitor value silk -> 0.4
    Rotated resistor texts to be bottom left justified
    Nudgled 12V trace around J8 power ground pad
    [LinkMeterHM.brd, LinkMeterHM.sch]
2012-02-12 [eagle] Add Button brd file. Thanks Steven Swinnea for original design
    [LinkMeter-Button.brd]
2012-02-13 [lm] Fix lucid crash when no data has been received from HeaterMeter yet
2012-02-14 [hm] SPILCD interrupt-safe code. Increase speed to clk/2
2012-02-14 [lmr] Add temperature oversampling (1 bit), early wake RFM chip, transmit every 30s, sleep mode 2 while waiting for TX
2012-02-14 [lmr] Lower the low battery detect to 2.2V because the interrupt routine doesn't handle lowbatt during transmit correctly
    [lmremote.ino]
2012-02-15 [hm] Fix FAHRENHEIT measurement being off broke in the CELSIUS patch
    [grillpid.cpp]
2012-02-15 [hm] Slightly better F/C units, now dynamic with 100% more fucked up PID after you switch
2012-02-15 [hm] Fix TemperatureAvg being wrong for RF nodes
    Solution is to run calcTemp() even if there's been 0 accumulatedCount for the period which allows the average to update
    [grillpid.cpp]
2012-02-15 [hm] Stupid mistake had enabled lid mode every setpoint change
    [grillpid.cpp]
2012-02-20 [hm] Allow setting PID units to 'R' which will output Celsius for the pit probe and resistance for the other probes. Resets to previous units on reboot.
    [grillpid.cpp, hmcore.cpp]
2012-02-24 [hm] SPI LCD now the default! This is a standard virtual base class implementation of ShiftRegLCD for SPI/Native
    Note that you can not really derive from ShiftRegLCDSPI/ShiftRegLCDNative and it isn't as slick as the worker version, but this is over 100 bytes smaller.
2012-02-24 [hm] Default probe names are now "Probe 0" etc
2012-02-25 [hm] Serial notify of an RF client removal immediately, fix adcbit=0 nodes showing 0 temperature
    [hmcore.cpp]
2012-02-26 [hm] UCID 20120226B Last letter now indicates board revision target A=<v3.2 B=v3.2+
2012-03-09 [hm] Fix pid units appearing C after setting with straight value
    [grillpid.cpp, grillpid.h, hmcore.cpp]
2012-05-27 [hm] Fix bug preventing Resistance mode from activating
    [grillpid.cpp, strings.h]
2012-06-22 [lm] Add Reboot AVR with button on conf page
2012-06-22 [lm] Include pid units changing to conf page
2012-06-22 [lm] Add LMUP,1 for unknown probe calculation. Switches HeaterMeter to resist mode. LMUP,0 returns the table and clears it
2012-06-22 [wrt] Automake syntax error fixes and don't build the threaded library for rrdtool
2012-06-29 [hm] Alarm subsystem - config incompatible! New $HMAL notification /set?al=L,H[,L,H...] serial command
    [grillpid.cpp, grillpid.h, hmcore.cpp, hmcore.h, hmmenus.cpp, hmmenus.h, strings.h]
2012-06-29 [hm] Silence all a probes alarms when a temperature can't be read
2012-06-29 [hm] Fix PIEZO not turning on, fix display not moving from ST_HOME_ALARM in certain situations
    [hmcore.cpp]
2012-07-12 [lm] Switch serial port from raw to sane mode
2012-07-12 [lm] hmdude: support SPI flashing, chip erase, fuses
2012-07-12 [wrt] A temporary home for this patch adding the spi-bcm2708 platform driver into the openwrt build for a patched 3.3 brcm2708 target
2012-07-20 [eagle] DO NOT BUILD. First try HeaterMeterPi board. The voltage regulator is BACKWARD could kill your Pi.
    [HeaterMeterPI.brd, HeaterMeterPI.sch]
2012-07-21 [eagle] Updated 4.1in v4.0 test board. Still do not build
    [HeaterMeterPI.brd, HeaterMeterPI.sch]
2012-07-23 [eagle] Fix crossed Tx/Rx to Pi, connect gnd poly pours
    [HeaterMeterPI.brd, HeaterMeterPI.sch]
2012-07-28 [lm] Added 'disable autoerace', verify, 'disable verify' and hack fix SPI control lines on exit
    [hmdude.c]
2012-07-28 [wrt] Change SPI bitrate to be in kHz, some verbosity levels
2012-08-10 [eagle] Fix inconsistency between sch and brd
    [LinkMeter-Button.brd, LinkMeter-Button.sch]
2012-08-10 [eagle] HeaterMeter v4.0.3 RCA jack on wrong side of board (flipped) RCA jack wired wrong, front prong should GND, back two should be 12V (fixed part pins) LCD connector too close to exp header (move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
    [HeaterMeterPI.brd, HeaterMeterPI.sch]
2012-08-10 [wrt] 8192cu driver no longer depends on cfg80211 because of the bullshit compat-wireless tie-in that crashes the 8192 driver
2012-08-10 [lm] Add BCM2708 platform, avrupdate called on install to load heatermeter
2012-08-10 [lm] Move to runtime detection to set up SERIAL_DEVICE and THREADS
2012-08-10 [lm] Fix SPI modules not loading
2012-08-10 [wrt] Shut the fuck up about switching power modes already
2012-08-24 [hm] Reorder probe offsets in the menu to be 0, 1, 2, 3
2012-08-24 [hm] Allow dynamic changing of min fan speed and PWM inversion -- Adds /set?fn= for setting min / max / invert -- New config magic, configs are incompatible
    [grillpid.cpp, grillpid.h, hmcore.cpp, hmmenus.cpp]
2012-08-24 [hm] Fix menu lcd backlight setting -- Removes the backlight blink during alarm -- Fix max fan speed / lcdbacklight / probe offset not getting reported when changed from menu -- lcdBacklight now 0-10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
    [hmcore.cpp, hmcore.h, hmmenus.cpp]
2012-08-24 [hm] Fix lcd backlight not being stored from menus
    [hmmenus.cpp]
2012-08-24 [wrt] Add kmod-spi-bcm2708 package
2012-08-24 [wrt] Add null compile step to spi module package
2012-08-24 [lm] Add linkmeterd / web support for fan min/max speed
2012-08-30 [hm] Fix alarms reenabling on reboot
    [grillpid.cpp, grillpid.h, hmcore.cpp, hmcore.h, hmmenus.cpp]
2012-08-30 [hm] Back to 1Hz PID updates.
    Users should adjust Ki = Ki/2 to account for double speed accumulation of error.
    [grillpid.cpp, hmcore.cpp]
2012-08-30 [wrt] 8192cu fill htcaps before device is upped
    preinit is now called after the firmware has been loaded and the
    PROM data has been read so the capabilites are now known at time
    of wdev register
2012-09-01 [hm] Fix SRTP mode for min != 10
    [grillpid.cpp]
2012-09-01 [eagle] HeaterMeter v4.0.4 Fix CE0/CE1 silk mislabel Nudge 5V regulator down 0.01" Minor silk cleanup
    [HeaterMeterPI.brd]
2012-09-11 [hm] Working Makefile build thanks to mjoldfield/Arduino-Makefile project
2012-09-11 [hm] Fix /reboot on v4.0 PCB by using watchdog reboot
    [heatermeter.ino, hmcore.cpp]
2012-09-11 [hm] Fix serial checksum error on reboot caused by splitting UCID report improperly
    [hmcore.cpp]
2012-09-11 [hm] 20120911B 22,804 fix build issue
    [strings.h]
2012-09-18 [hm] Bring in other Print::write() methods into ShiftLCDs
2012-09-19 [hm] Fix toast not showing up/being corrupted/reentrance
    [hmmenus.cpp]
2012-09-19 [hm] Reset probe temperature when RF source ID changes too
    [hmcore.cpp]
2012-09-20 [hm] The base station is now RFSOURCEID_NONE
    This was causing confusion in the linkmeterd, where probes linked to the
    RFSOURCEID_ANY were getting the wrong flags due to the name conflict.
    Also this changes the _flags setter because setting a member variable
    is 3 assember ops and a local variable is 2
    [rfmanager.cpp, rfmanager.h]
2012-09-20 [wrt] 8192cu: Fix lockups deleting virtual interfaces
    unregister_netdevice must be used inside the context of an ioctl because
    the spinlock is already held. Also only allow deletion of monitor interfaces because that's the only kind
    the driver will allow you to create.
2012-09-25 [hm] Fix rfmanager going bonkers after freeing the first source
    [rfmanager.cpp]
2012-09-25 [hm] rfstatus.flags bitfield wrong bits
    [rfmanager.h]
2012-09-25 [hm] itplus: Add callback into the receive interrupt (for measuring analog RSSI)
2012-09-25 [lmr] Attempt to improve accuracy of ADC readings
    Use noise-reducing ADC mode
    Wait for reference voltage to stabilize using the internal reference
    Lower oversampling to 11 total bits
    Also makes low battery a percentage
    [lmremote.ino]
2012-09-25 [lm] Add visible RF probes to conf page when radio is enabled
2012-10-03 [hm] Alarm lid, disable fixes
    -- Don't activate an alarm when the lid is open
    -- Fix setting Alarm threshold to 0 wiping out the value
    -- Always send all alarm thresholds in HMAL
    [grillpid.cpp, grillpid.h, hmcore.cpp]
2012-10-04 [lm] Add config checkbox for inverting pwm output
2012-10-04 [lm] Add probe alarm limits to LMCF json, broadcast alarm message, alarm ringing to status json
2012-10-04 [lm] Add basic alarm temperature indicator and popup to home page
2012-10-04 [wrt] HeaterMeter 20121004B
2012-10-06 [hm] Fix RFManager to work with IT+ TX25U transmitter. Onlyone attached probe for now
    [lmremote.ino, rfmanager.cpp, rfmanager.h]
2012-10-29 [lm] Fix sending 'null' alarm when alarm temperature is changed while ringing
2012-10-29 [lm] Fix crash when no probe plugged into probe 0 or 1 when doing unknown probe
2012-11-01 [lm] Make sure we have an LMCF entry for temperatures even if there isn't a value. Fixes missing 'off' on conf page
2012-11-05 [lm] Don't display configuration form if there is no communication with HeaterMeter
2012-11-12 [eagle] LMRemote sample schematic
    [LMRemote.sch]
2012-11-12 [hm] Fix native IT+ trasmitters transmitting temperatures below 0C
    [hmcore.cpp]
2012-11-12 [lmr] Fix non-native remote transmits being identified as native ITPlus
    [lmremote.ino, rfmanager.cpp]
2012-11-15 [lm] Added a save button to the conf page to make it less confusing. Also moved reboot button up
2012-11-19 [hm] Fix BoardRev A build, add Release A target to project
    [hmcore.h]
2012-11-19 [hm] Fix probe offset being added on every second for remote probes
    Thanks to ioudeveldhuis for reporting
    [grillpid.cpp]
2012-11-22 [hm] Test transmitting fan speed build for Dave
2012-11-22 [lmr] Test receiving fan speed for Dave
2013-01-06 [lm] Show the pit probe name on the home screen. Can not edit it there though
2013-01-06 [lm] Fix lucid crash when no heatermeter connected and configuration is requested
2013-01-06 [lm] Re-request the heatermeter config when a LmReboot is done
    This allows the "Reboot AVR" button to be used to get a fresh configuration
    if there was a serial error during the configuration dump
2013-01-07 [lmr] Fix rollover during wait for receive and switch to 5 second interval
    [lmremote.ino]
2013-01-07 [hm] Add RF_SEND_INTERVAL = 5 to set number of PID cycles before fan speed RF TX
2013-01-07 [lmr] Use only one digital pin for sourcing power to the measurement dividers
2013-01-07 [hm] Fix inverted PWM for max fan speeds != 100
    [grillpid.cpp]
2013-01-07 [hm] Hard-coded LED uses for now. Top=Fan On, Middle=Lid Open
2013-02-01 [lm] Remove alarm script debug print
2013-02-03 [lm] Add main alarm script functions, fixes
    -- alarm-all now called before specific alarm, can abort by returning non-zero
    -- Output of alarm script is piped to syslog with lmalarm type
    -- Added al_set function to change the current alarm value
2013-02-03 [wrt] Add 8192cu driver version to package name
2013-02-13 [hm] Disable interrupts when switching rx/tx modes to prevent lockups occurring in rf12_xfer from the non-interrupt side
2013-02-22 [hm] Alarms are now checked against the float current temperature which should make the thresholds now seem more accurate
    Before: Low Alarm=220F triggers at 220.9F
    Now: Low Alarm=220F triggers at 220.0F
2013-02-22 [hm] Switching back to int alarm compares.
    Low: Arming point = Thresh + 1.0f, Trigger point = Thresh - 0.1f
    High: Arming point = Thresh - 1.1f, Trigger point = Thresh
2013-02-25 [hm] Fix for ITPlus transmitters at exactly 32F
    [hmcore.cpp]
2013-02-25 [hm] Move to Arduino 1.0.3
2013-02-28 [hm] Disable some unused chip functions, the DIDR0 might actually improve ADC accuracy
2013-02-28 [lm] Use probe names on the alarm script page, LMGT now supports multiple items per query
2013-02-28 [lm] Fix reset/reboot buttons not working properly after a config change on conf page
2013-03-28 [lm] Wait for new partition device to appear before checking for a backup
2013-04-17 [hm] Other project to Arduino 1.0.3
2013-04-17 [hm] Missing Print::write(uchar *, int) in SerialXorChecksum
    [serialxor.h]
2013-04-17 [hm] Fix multiple toasts not properly overwriting
    Moves last menu state into Menus::getLastState()
    [hmmenus.cpp, hmmenus.h, menus.cpp, menus.h]
2013-04-17 [hm] Fix not properly removing native ITPlus remotes when they drop off
    [hmcore.cpp]
2013-04-17 [lmr] Update project to Arduino 1.0.3
2013-04-17 [hm] Add GrillPid servo mode output, all modes use TIMER1 now
    Because we normally use digital pin 3 for fan output, there was an
    interaction between the PWM output and the tone() output, both of which
    use the same timer but in different modes.
    This new code always uses TIMER1 and controls the PWM in software, so the
    blower output can be in any pin.
    This also adds the 50Hz servo output mode, using fanspeed min/max to set
    servo pulse duration in 10s of microseconds (e.g. 150 = 1500usec)
2013-04-17 [hm] Output the PID status ($HMPS) every 16 seconds
2013-04-17 [hm] Remove constraints on fan min/max speed because max could be up to 255 for a servo
2013-04-17 [hm] $HMPS now is toggleable and includes all PID terms
2013-04-17 [hm] Remove all that old HEATERMETER_NETWORKING stuff. Hasn't been used in years
2013-04-17 [lm] Autoselect the in place editables when they pop up
    I'd like to make the setpoint field "numeric" but stupid Android browser
    changes the "Go" button (which would submit) into a "Next" button, which
    just selects the next form field, canceling the edit. I suppose it is just
    as well though, because the implementation is buggy across Android versions.
    Sorry, iPhone users!
2013-04-17 [lm] hmdude fix spelling erase
    [hmdude.c]
2013-04-17 [lm] Add PID Output Device (fout) configuration support. Also round the lightbox corners
2013-04-17 [lm] Add PID Internals info to home page when available. UNOPTIMIZED
2013-04-19 [hm] Finish servo/fan control mode
2013-04-19 [hm] Increase PID D lookback distance period from 39 sec to 60 sec
    The derivative is an exponential moving average so that is that it will
    reach 85% of its value the 45 second period. The Pid D constant should
    be reduced proportionally to achieve the same output.
2013-04-19 [hm] eepromLoadConfig now takes a number instead of a boolean.
    0 - Load config from EEPROM and use defaults on magic fail
    1+ - Load DEFAULT_CONFIG[n-1] into EEPROM
    Does not do DEFAULT_CONFIG_PROBE!
    [hmcore.cpp, hmcore.h, hmmenus.cpp]
2013-04-23 [hm] Don't output pid internals when there's no pit temerature
2013-04-24 [lm] Change PID internals on home screen to use proper divs isntead of a table
2013-04-24 [lm] Add 'p' keybinding to show/hide PID internals
2013-04-24 [lm] Stash databases on partition 4
    This might come back to bite me in the ass at some point. If the partition
    isn't mounted, and someone stashes a DB then it will create the file inside
    the mountpoint and future mountings of p4 will fail with EBUSY
2013-05-10 [lm] Add hmdude sanity checks to prevent disabling the reset pin / spi programming. How many times must I mess this up?
    [hmdude.c]
2013-05-10 [lm] AA final .config and package list. Adds avahi to installed packages
    Include new packages:
    avahi-daemon - Adds bonjour discovery support
    Remove unused packages:
    wireless-tools
    kmod-mac80211
    kmod-crypto-core
    kmod-crypto-aes
    kmod-crypto-arc4
    Removing from BCM2708 kernel config and placed in .config where they belong
    kmod-vfat
    kmod-fat
    kmod-nls-cp437
    kmod-nls-iso8859
    kmod-nls-base
2013-05-24 [lm] Mount the boot partition on startup
    This isn't the right place to do this but if we do it in fstab that won't
    be restored until after we restore the backup and we're mounting to
    determine if we need to restore or not so we can't rely on the fstab
    backup
2013-05-26 [wrt] Switch to Attitude Adjustment tag
2013-05-31 [hm] First run at LED configuration 25194
2013-05-31 [hm] Second pass at ledmanager 25242 bytes
    The Wireless LED doesn't blink twice on startup any longer,
    all 3 lights should light at once then the ledmanager should put them
    out later after the config is loaded.
    This also includes loading but not saving of the config which blows up
    the sketch size by quite a bit due to some pointer offset assembler
    generated by gcc.
    [hmcore.cpp, ledmanager.cpp, ledmanager.h]
2013-05-31 [hm] Move default units selection to pid class instead of config loader
2013-05-31 [hm] Switch config loaders to use a union to save stack space and shrink code size
2013-05-31 [hm] Store ledConf as parameters to /lb and $HMLB
2013-05-31 [hm] Save some code space by keeping the invert bit integrated into stimulus
    Also removes LED executor debug code
    [hmcore.cpp, ledmanager.cpp, ledmanager.h]
2013-05-31 [hm] Replace LED enums with defines
    gcc follows the C standard and promotes all enum types to int rather than
    using just what is needed. Switching to uint8_t saves 62 bytes
    [hmcore.cpp, ledmanager.cpp, ledmanager.h]
2013-05-31 [hm] Replace GrillPidOutput enum with defines, saves 24 bytes
    [grillpid.cpp, grillpid.h, hmcore.cpp]
2013-05-31 [hm] Remove RfManager::event enum, replace with defines, saves 20 bytes
    [hmcore.cpp, rfmanager.cpp, rfmanager.h]
2013-05-31 [hm] Replace RfSource::Flags enum with define, 0 bytes saved
    [rfmanager.cpp, rfmanager.h]
2013-05-31 [hm] Strip out probesubmenu stuff. Just too hard to configure using device
2013-05-31 [hm] Fix LEDSTIMULUS_FanMaxed for servos
    [grillpid.cpp, grillpid.h, hmcore.cpp]
2013-05-31 [hm] Fix alarm screen / beeper not going off since LED was added
    [hmcore.cpp]
2013-05-31 [hm] Fix LEDs turning off immediately on setAssignment
    [ledmanager.cpp]
2013-05-31 [hm] LEDs in OneShot on should not be overwritten by a SteadyOn/Off until their shot is complete
2013-05-31 [hm] Publish an Off led stimulus every second as well
2013-05-31 [hm] Fix initial blink going off too fast due to it happening at the 0ms mark
    [ledmanager.cpp, ledmanager.h]
2013-06-01 [lm] Format pid internal labels with fixed precision
2013-06-01 [lm] Add quick LED config to web page
2013-06-01 [lm] Fix avrupdate not working on boot because the spi device takes too long to show up. Also only call avrupdate once 10 seconds after server start
2013-06-02 [lm] Style LED selectors and wire up. Adjust style of probe labels, fix checkbox labels to be attached to their inputs
2013-06-03 [lm] HeaterMeter 20130531B
2013-06-03 [wrt] Switch to wpad instead of wpa_supplicant/hostapd. Add conv support to busybox dd
2013-06-03 [lm] Improve compatibility with reading conf variables from older HeaterMeter serial dumps, just take what we can get
2013-06-04 [lm] Unset LEDs come over as 255. Make them non-inverted to prevent confusion
2013-07-30 [hm] Fix units resetting to default if not passed.
    Thanks Remco Kortekaas
    [grillpid.cpp]
2013-07-30 [hm] Add LEDSTIMULUS_AlarmAny
2013-07-30 [hm] Revert: Move default units selection to pid class instead of config loader
    [grillpid.cpp, hmcore.cpp]
2013-07-30 [hm] Add 'A' pid units for raw ADC output
2013-07-30 [hm] Fix PRR not being available on mega2560
    [hmcore.cpp]
2013-07-30 [hm] Remove pid.outputMode, servo and fan now both run at the same time
    This moves the servo to digital pin 8, atmega pin 14. As a side effect,
    the maxFanSpeed no longer defines the upper limit of the PID output.
    PID now always runs 0-100 and the fan speed is scaled between them rather
    than simply clipping at maxFanSpeed. This may require some adjustment
    to the PID constants to scale the output back up proportionally.
    [grillpid.cpp, grillpid.h, hmcore.cpp, hmcore.h, hmmenus.cpp]
2013-07-30 [hm] Remove servo control from Rev A hardware, it uses the LCD_DATA pin and would f that up
2013-07-30 [hm] Replace INVERT_* flags with PIDFLAG_*
    PIDFLAG_FAN_ONLY_MAX -> Only turn on the fan (to max) if the pidOutput is
    100%. That is, only use the fan when the servo isn't enough.
    PIDFLAG_SERVO_ANY_MAX -> The servo is either fully closed (at pidOutput=0)
    or fully open (if pidOutput is not 0)
    [grillpid.cpp, grillpid.h, hmcore.cpp]
2013-07-30 [hm] Fix servo opening slightly between every PID cycle caused by reusing ICR1
    [grillpid.cpp, grillpid.h]
2013-07-30 [hm] v3.1 boards must have their shift register cleared before sending digitalWrite auxPins ad-hoc
    Thanks Dave Peart
2013-07-30 [hm] Increase default servo range to 600us-2500us, seems to be standard for 1500us-centered servos
2013-07-30 [lm] HeaterMeter 20120604B
2013-07-30 [lm] Add Any Alarm Ringing to LED triggers
2013-07-30 [lm] Add an autobackup of the running RRD file that's restored on boot
    There are two autobackup intervals:
    Pit < 150 or no probe = "inactive"
    Pit >= 150 = "active"
    The interval should not be set so low that it wears out the SD card
    with constant overwrites.
    Before a new RRD is created, the autobackup is checked and if the last
    update was in the past, then that file is copied into place and continued
    rather than creating a new file.
2013-07-30 [lm] hmdude spi clockrate isn't a pow2, enabled 4MHz uploads
2013-07-30 [lm] HeaterMeter is considered 'active' for autobackup if the pit has any temp now. Fixes Celcius folks
2013-07-30 [lm] Fix autobackup always using active timer
    By the time the data gets down to checkAutobackup(), vals has the time as the
    first array element, so the old code was always checking the setpoint
2013-07-30 [lm] Add support for simultaneous fan/servo operation
2013-07-30 [lm] HeaterMeter 20130729B
2013-08-01 [lm] HeaterMeter 20130731B
2013-08-01 [lmr] Shift around some power saving defines to prep for better decoupling
2013-08-01 [hm] Fix overflow in servo position counter
    [grillpid.h]
2013-08-01 [hm] Fix bug causing servo inverted and servo anymax interaction that discarded anymax
    [grillpid.cpp]
2013-08-01 [hm] HeaterMeter 20130731B 25054 bytes
2013-08-23 [lm] Replace IKEA Fantast with iGrill probe coeffs
2013-08-23 [wrt] Fix duplicate code in sdhci driver, fix all wrt patches not copying
2013-08-28 [lmr] Switch to proper scheduling of temp read and rf receive
    Also cleans up some of the sleep defines, adds LEDs for the Rf status,
    switches to digitalWriteFast
2013-08-28 [lmr] Switch pins to match HeaterMeter pinouts
2013-08-28 [lmr] Rename resetEstimate() -> rfResetEstimate()
    [lmremote.ino]
2013-09-13 [lmr] Set RF state back to converging if locked and miss a packet. Also:
    -- Sleep the RFM12 as soon as possible after RX failure
    -- Don't do any temp measuring if no probe pins are enabled
    [lmremote.ino]
2013-09-13 [hm] Switch to using grillpid_conf.h so the GrillPid object can be used in other projects
2013-09-13 [lmr] Add grillpid usage for blower/servo output
2013-09-13 [avr] Adjust RFM12B initialization
    -- Reduce PLL bandwidth to reduce phase noise because we don't need
    the bandwidth. Might improve reception
    -- Disable low battery detector in all modes
    -- LowBatt detector to 2.2V, 1MHz clock output (neither used)
2013-09-13 [lmr] Remove low battery init because we rfm_itplus doesn't enable it
    [lmremote.ino]
2013-09-13 [avr] More IT+ updates to improve reception
    -- deviation 90kHz -> 60kHz
    -- Frequency 915.000 -> 915.025
    -- AFC tighten restriction, use fine tuning
2013-09-13 [wrt] Switch to kernel CONFIG_SLUB and enable CONFIG_COMPACTION
2013-09-13 [lm] Add Thermoworks Pro-Series probe preset. Just a wild guess on the coefficients
2013-10-03 [hm] Only reduce, not fully cut, the I term when temperature is reached.
    I'm seeing a lot of graphs where reaching the temperature cuts the PID
    output so much that it can't recover before Lid Detect kicks in, turns
    off the output and the cycle repeats. This change is a band-aid to that.
    Failing not knowing how much I is needed, I'll take 1/4 as a starting
    point. Experimentation may determing 1/2 or 3/4 might be even better.
    [grillpid.cpp]
2013-10-03 [hm] Add GRILLPID_FAN_BOOST_ENABLED to momemtarily boost the fan when transitioning from 0% to "on"
2013-10-03 [hm] Remove misleading comment
    This comment has been wrong for like 2 years when the code to do that was
    removed. Just goes to show, nobody looks at comments!
    [grillpid.cpp]
2013-10-03 [hm] Don't store millis() in temp, use 16bit for elapsed time where they fit
    Saves 46 bytes, mostly in tone_doWork()
2013-10-03 [lm] Fix unparsable json in LMCF created when a probe has no value
2013-10-04 [lm] Save alarm thresholds from alarm page, remove save button
2013-10-04 [lm] Add LMAT,probe,type,threshold command to test alarm
2013-10-04 [lm] Add alarm cbi templates and a noconfig error page. Alarms can not be configured unless there's a HeaterMeter present
2013-10-05 [lm] Fix error on alarm page when a probe isn't plugged in
2013-10-05 [www] Remove the word Current from the Pit on the index page
2013-10-05 [lm] Add Plateau sms gateway
    Thanks Juan Garcia
2013-10-05 [lm] Fix LMAT when there's no current value for the selected probe
2013-10-07 [lm] HeaterMeter firmware 20131007
2013-10-07 [www] Add more finger-friendly navigation bar to the home page with links to alarms/archive as well
2013-10-16 [lm] Add curve fitting to linkmeterd for unknown probe calculation
    $LMUP,command
    start - Switch Pit to Celcius and probes to resistance
    fit - Return the JSON-formatted steinhart curve fit of the current Food1 probe
    csv - Return the csv-formatted data of temperature,resistance
    stop - Stop unknown probe calculation and return to normal temperature units
2013-10-17 [lm] New preset for ET-72/73 and should have 8 sigfigs in unknow probe output
2013-11-13 [eagle] HeaterMeter v4.1.0 design DO NOT BUILD
    [HeaterMeterPI.brd, HeaterMeterPI.sch]
2013-11-13 [eagle] HeaterMeter v4.1.1 design DO NOT BUILD
    [HeaterMeterPI.brd, HeaterMeterPI.sch]
2013-11-15 HeaterMeter 20131007B 25160 bytes
2013-11-15 [hm] Update project to Arduino 1.0.5, Visual Studio 2012
2013-11-15 [hm] Fix lockup of printSciFloat(0.0f)
    [hmcore.cpp]
2013-11-15 [hm] Disable "Lid Open" countdown when switching to manual output mode
2013-11-24 [eagle] v4.1 board and schematic
    [HeaterMeterPI.brd, HeaterMeterPI.sch]
2013-12-12 [eagle] v4.1.2 board, removed old files
    [HeaterMeterPI.brd, HeaterMeterPI.sch, LinkMeter-Button.brd, LinkMeter-Button.sch, LinkMeter-External.sch, LinkMeterHM.brd, LinkMeterHM.sch]
2013-12-27 [hm] Constrain min/max fan speed, lcd backlight to 0-100
2013-12-30 [hm] If one thermsitor analogRead is more than 64 off the average, reject the whole period.
    This helps to fix the one read you get when plugging in or unplugging a
    probe, in the case you're plugging right in the middle of a sample. Also
    helps for high impedance inputs like a thermocouple with a 1M input filter.
    [grillpid.cpp]
2014-01-14 [hm] Slightly simplify RF SPI setup
2014-01-17 [hm] Add adc_noise.h
    Tests the ADC to see how much noise there is by running in freerunning mode for 4ms
    [hmcore.cpp]
2014-01-17 [hm] Reduce ADC noise samples to 255
    Forgot that ADC takes 13 cycles, not 1, so was actually taking 54ms
    instead of 4ms. I only strictly need 2 PWM cycles anyway.
2014-01-17 [hm] Remove GRILLPID_FAN_BOOST_ENABLED and always disable PWM while reading temp
    Really reduces noise when blower is running. The servo however still
    may be a problem because it stays powered up.
    [grillpid.cpp, grillpid.h, grillpid_conf.h]
2014-01-17 [hm] Move noise test to grillpid
    Might not be the greatest place because now lmremote compile will fail
    [grillpid.cpp, hmcore.cpp]
2014-01-19 [hm] Stop disabling fan while reading, instead only read mid-PWM cycle
    This doesn't guarantee we won't read when the PWM flips on (due to
    interrupts) but it works almost all the time. The old method gimped
    the blower output too much by being off up to 224ms out of every 1s period.
    Also fixes compile error about pid not being defined.
    [grillpid.cpp]
2014-02-02 [www] Remove 'current' from pit on home page (how did this get back)
2014-02-02 [www] Fix tooltip on home after Y axis swap
2014-02-02 Revert "[www] Fix tooltip on home after Y axis swap"
    This reverts commit 1172671dea2f44055df286f26abcc0e82d45d044.
2014-03-06 [hm] Freerunning ADC mode controlled by the grillpid unit
    Allows more oversampling but takes more code space.
2014-03-19 [avr] Add testing GRILLPID_FAN_MANUALPWM and switch to fast PWM for automatic
2014-03-21 [hm] Replace eeprom_X_block with local versions to save 392 bytes
    avr-libc is built with prologue/epilogue so avoid including
    that for such a small function.
    [econfig.h, hmcore.cpp]
2014-03-21 [hm] Fix fan speed changing while alarm is sounding
    tone() uses TIMER2 to generate its output and modifies the waveform
    generation to do so. Because the blower uses hardware PWM on TIMER2,
    this makes the blower run full on or off while the alarm is ringing.
    This code fixes the alarm output at 4KHz and uses TIMER1's COMPA
    vector to do the timing (same timer used for the servo output).
    The new code modifiest the timer mode from normal to CTC with ICR1
    as TOP which reduces the amout of code in the COMPB vector to a
    single line.
    Thanks to Peter F for finding the bug
    [grillpid.cpp, grillpid.h, hmcore.cpp, tone_4khz.cpp]
2014-03-21 [hm] Switch fan PWM to Fast PWM so we can reliably not analog sample around the turnon
2014-03-21 [hm] Stop the servo from jerking past the end on startup, quick fix
    [grillpid.cpp]
2014-04-20 [eagle] Fix disconnected LED1, stretch GND plane to bottom edge
    Thanks to Steve_M for finding the disconnected LED
    [HeaterMeterPI.brd]
2014-05-05 [eagle] v4.1.4 Fix overlapping ground trace between MOSFET and regulator
    [HeaterMeterPI.brd]
2014-05-12 [hm] Set PIN_ALARM to output on startup to prevent the floating pin from making a buzz
    [hmcore.cpp]
2014-05-12 [hm] Rewrite fan output to be a 62khz switching buck converter with feedback
2014-05-12 [hm] Replace ADC limitCnt with high/low range to detect plug events
    [grillpid.cpp]
2014-05-13 [hm] ADC noisy range check for probes was inverted. Oops!
    [grillpid.cpp]
2014-05-14 [hm] Max ADC value is actually not (2^13)-1 it is ((2^10)-1 * 2^bits)
    Adjusts temperatures up by about 0.1%
2014-05-15 [hm] Support disabling PIDFLAG_FAN_FEEDVOLT and lock to output voltage fster
    Adjusts blower output at 3Hz, boost mode lasts 1 period
2014-05-16 [hm] Dynamic range support moved out of interrupt handler, added to thermocoples my default
2014-05-19 [hm] Voltage output mode 5V-12.1V
    12.1V to account for rounding, switching and cable loss. If the power
    supply has an extra 0.1V to spare.
2014-05-19 [hm] Slim down ADC_vect and TIMER1_COMPA_vect by using proper operands
    For some reason this generates code promoted to 16 bit ints
    (uint8_t)((uint8_t)ADMUX & (uint8_t)0x07) == (uint8_t)val
2014-05-19 [hm] Fix LCD display of Pit probe value after probe is unplugged
    [hmcore.cpp]
2014-05-19 [hm] Prevent incorrect button press detection during transition time
    [hmmenus.cpp]
2014-05-20 [www] Configuration for Pulse vs Voltage fan output
2014-05-20 [www] accesskey is case sensitive
2014-05-20 [www] Add some buttons to select the noisegraph pin
2014-05-20 [www] Store selected graph range, showfan, probelines on index page across sessions
2014-05-20 [www] Allow setting of 'XX%' for a manual fan percentange from conf and index
2014-05-20 [www] Fix missing lines on home graph (set/fan/lid)
2014-05-21 [hm] Reintroduce ADCmax as an invalid probe condition to switch back to TSTATUS_NONE
    Also increase the noise acceptange range from 16 to 32
    [grillpid.cpp]
2014-06-23 [lm] Add -m mode switch to wifi-client, link to wifi-ap
2014-06-23 [wrt] Migrate to new incompat-wireless package
    The 8192cu driver would need to be extensively patched to match the
    compat-wireless cfg80211 interface. I can't really take away 8192cu
    support so instead I'm creating a new incompat-wireless package
    to provide support for official kernel wifi modules.
2014-06-23 [wrt] Enable kmod-lib-crc-ccitt kmod-lib-crc-itu and incompat-wireless
2014-06-23 [www] conf page now shows selected preset coefficient
    The probe coefficients now are stored in linkmeterd as strings which
    may allow them to be matched up to their original coefficients in the webui.
    Radio Shack 10k has been removed because it is no longer available and
    I don't remember the part number that was the vishay equivalent.
2014-06-23 [www] A probe coefficient is now considered the same if within 0.0001 percent
2014-06-23 [www] Default to 5mV/C or 10kohm when switching between internal and thermocouple probe type
2014-06-26 [lm] Guarantee that adc array will always be in hmstatus json, reduce lua complexity
2014-06-26 [lm] Always sync after wifi-client to prepare for immediate power loss
2014-06-26 [lm] Linear regression based degrees per hour estimates for probes rather than doing simple javscript subtraction of the first and last point
2014-06-26 [www] Make Probe0 name clickable to edit on home page, but is really hard to click under current value div
2014-06-30 [hm] Fix Derivative not working due to TempAverage getting reset with every measurement
    [grillpid.cpp]
2014-06-30 [hm] Display Probe Noise on the LCD when the probe is off due to noise
    [grillpid.h, hmcore.cpp, strings.h]
2014-06-30 [hm] Move servo in 50 steps rather than jumping to target PWM width
2014-06-30 [hm] Replace GrillPid with const fan/servo pin with #defined version to allow use of digitalWriteFast
    [grillpid.cpp, grillpid.h, grillpid_conf.h, heatermeter.ino, hmcore.cpp, hmcore.h, tone_4khz.cpp]
2014-06-30 [hm] Add bandgap calibration for more accurate scaling when bangap is used as reference
2014-06-30 [hm] Restore RF node functionality removed with ADC freerun changes
    Also fix 'R' and 'A' units resolving as !hasTemperature()
    [grillpid.cpp, grillpid.h, hmcore.cpp]
2014-06-30 [hm] Disable noisedump by default
    [grillpid.h]
2014-06-30 [hm] An easier way to swap the control probes. Static so it doesn't take more space
    [hmcore.cpp]
2014-06-30 [hm] Reduce cutback of PID I sum when temperature is reached from 75% cut to 50% cut
2014-06-30 [hm] 4khz tone doesn't need to do math, as 40000/160 is an even number
    [tone_4khz.cpp]
2014-06-30 [hm] Output HMAR segment with HeaterMeter ADC Range information
2014-06-30 [hm] Output noise once every 4 seconds instead of 8 so it will update with the 5sec period hmstatus
    [hmcore.cpp]
2014-06-30 [hm] Fix compile without GRILLPID_DYNAMIC_RANGE
    [grillpid.cpp, grillpid.h]
2014-06-30 [hm] Updated DEFAULT_CONFIG. Fan FEEDVOLT now default, new PID constants, slimmer servo range, FanMax added as LED0, minfan=0
2014-07-13 [eagle] HeaterMeter v4.2.4
    [HeaterMeterPI.brd, HeaterMeterPI.sch]
2014-07-15 [eagle] Add rfaddon board/schematic
    [RfAddon.brd, RfAddon.sch]
2014-08-17 [lm] Add support for fan startup max and LED indicators
2014-08-17 [lm] Add linkmeterd support for current fan speed
2014-08-17 [lm] Add support for uploading devicedata to heatermeter.com
    All interface IP addresses and device serial number is uploaded to
    http://heatermeter.com/devices/ where it can be viewed based on
    the IP address of the requestor. Requires curl package.
2014-08-17 [lm] Fix devicedata posting every minute due to packet count changes, and invalid json thanks of mutli
2014-08-17 [www] Add second bar for actual fan output. Rename Blower Output to just Output
2014-08-17 [www] Rename fan alarm trigger to output
2014-08-31 [lm] Add postDeviceData support for Ralink SoC devices
2014-10-03 [hm] Add startup max fan speed for boosting on startup
    Startup is defined as any time the setpoint is changed until the first time
    the temperature is reached. Also added LED stimulus for startup and recovery states.
2014-10-03 [hm] Output fan speed percentage in LMSU, needs linkmeterd update
2014-10-03 [hm] Fix D term inaccurate and no alarms with native RF pit probe
    The temperature derivative was only being calculated for probes which called
    calcTemp(adc), so RF probes were getting very slowly changing D values
    and native RF probes (which set their temperature directly) never got D.
    This change makes the TempProbe check average and alarms every second
    regardless of type.
    [grillpid.cpp, grillpid.h]
2014-10-03 [lm] HeaterMeter 2014103
2014-10-21 [hm] ADC actually can only do max 14 bit oversamping with 256 samples
    Thanks to R-Burk for pointing out that somewhere along the lines the math
    got mixed up. You need 4^N samples, shifted right N.
2014-12-16 [eagle] Reduce resolution of boxy robot to improve silkscreen process
    - Converts board to EAGLE 6 xml format
    [HeaterMeterPI.brd]
2014-12-22 [hm] Control probe is no longer TEMP_PIT, now first non-disabled probe
    Note that a probe reading "Off" isn't disabled, only probes with their
    type set to DISABLED count as disabled.
    [grillpid.cpp, grillpid.h, hmcore.cpp]
2014-12-22 [hm] Optimize code of control probe to store control probe rather than calculate it all the time
    ~50 bytes smaller but uses 2 more bytes RAM
2014-12-22 [hm] Fix not selecting correct control probe on boot, PID status shows control probe now
    [grillpid.cpp, grillpid.h, hmcore.cpp]
2014-12-22 [hm] Don't reset PID[I] when changing the I constant, it really serves no purpose but to mess up the control algorithm
    -- Thanks to R-Burk for pointint this out
    [grillpid.cpp, grillpid.h]
2014-12-29 [hm] Prevent low current fans from turning off in voltage mode at the bottom of the PWM range
    -- Thanks to R-Burk for discovering and finding workable solutions
    When attempting to do voltage mode fan control, if the current draw is too low
    the output duty cycle will throttle down to lower the voltage. If throttled
    back too far (0), the PWM turns off completely which causes the voltage
    to drop hard and the PWM to shoot back up to compensate.
    The simple solution is to just not turn off at all when there's any desired output.
    [grillpid.cpp]
2015-01-11 [lm] Add the ability to reset the OpenWrt configuration
    This relies on there being a default-config.tar.gz from a firstboot or an
    upgrade.
    -- Adds $LMTT,line1,line2 lmclient command to display a toast message
    -- Adds $HMRC HeaterMeter output receiver to call the reset config commant
    -- Adds "config_restore reload" to revert to the saved configuration
2015-01-11 [hm] Send HMRC when user selects Reset Config
    [hmmenus.cpp]
2015-01-15 [lm] Add the rest of the data from LMCF to be available in LMGT commands, such as the current temps
2015-05-31 [www] Add option for 50/60Hz line noise removal
2015-05-31 [lm] HeaterMeter 20150531 23970 bytes
2015-08-28 [lm] Oops had watch probe labeled as provider in alarms UI
2015-09-04 [hm] Switch to Arduino 1.6.0 compatible code
2015-09-04 [hm] Add 50/60Hz line noise removal
    [grillpid.cpp, grillpid.h]
2015-09-04 [hm] Delay servo pulses until it has a large change or timeout expires
    Never pulse the servo if change isn't needed and only trigger the
    servo if a large movement is needed or holdoff expired.
    -- Thanks to Thomas K for getting the juices going on this idea
2015-09-05 [hm] Start the servo at the first output, not sloped from min
    -- Fixes servo never moving on startup if using SERVO_MIN_THRESH
    [grillpid.cpp]
2015-09-07 [hm] Add FanActiveFloor config item and rename all the fan/blower settings to more sane names
2015-09-07 [lm] HeaterMeter 20150907B 24070 bytes
2015-09-08 [lm] HeaterMeter 20150908B 24072 bytes
2015-09-08 [hm] Fix _fanActiveFloor not scaling up to max speed
    [grillpid.cpp, grillpid.h]
2015-09-29 [hm] Reset PID I sum to 0 if the PIDI is set to 0 because it won't be able to change otherwise
    [grillpid.cpp, grillpid.h]
2015-09-29 [hm] Increase UP button ADC range
    Was 140/152/160 but 5V buttons would be either 156 or 138
2015-09-30 [lm] HeaterMeter 20150922B 24116 bytes
2015-09-30 [lm] Fix unable to change probe type from conf page
2015-10-01 [wrt] Point 8192cu to heatermeter.com source
2015-10-04 [wrt] Include current bcm2708 firmware. Thanks Steve_M!
2015-10-13 [hm] Commit servo movement on next update after min/max configuration change
2015-10-13 [hm] Change servo to smoothstep from prev to target over ~35 servo periods
    This will allow the servo ~15 periods at the target position before it
    is shut down. It also smoothly accelerates and decelerates in the start
    and stop positions.
2015-10-13 [hm] Servo holdoff lowered to 5 seconds
2015-10-28 [hm] Change servo behavior to be fixed speed and stay energized 2s after arriving
    The new mechanism moves the servo at a constant speed of 15us per every
    pulse duration and it takes as long as it takes to get there. Once
    the servo arrives at its destination, it will always stay energized there
    for 2 full seconds (100 periods) before shutting down, regardless of
    distance traveled. If there is a change in destination the servo will slew
    toward that target rather than the initial target and the travel time
    changes accordingly.
    [grillpid.cpp, grillpid.h, grillpid_conf.h]
2015-10-28 [hm] Remove servoEnabled and just use the next step to trigger disabling the servo
    Saves 30 bytes progmem and a byte of RAM
2016-01-03 [lm] Switch firware path to heatermeter.com
2016-01-10 [hm] Add acceleration to the menu numberEdit
    Holding down the button now increases the increment. First 5 presses
    are normal increment, 6-10 are 2x speed, 11+ 4x speed.
2016-01-18 [hm] Replace PIDFLAG_SERVO_ANY_MAX with Servo Active Ceiling
    Now can set what PID output the servo is completely open
    rather than scaling 0-100% directly with the PID output
    [grillpid.cpp, grillpid.h, hmcore.cpp]
2016-01-18 [lm] Add conf for servo active ceiling
2016-01-18 [lm] HeaterMeter 20160118 24,146 bytes
2016-01-31 [hm] Microoptimization of temperature difference calc in pid doWork
2016-01-31 [hm] Don't reset PIDI when changing temperatures, let the PID controller work it out
    [grillpid.cpp]
2016-01-31 [hm] Reduce servo jitter from TIMER1_CAPT interrupt latency and calculation time
    ISR latency is pretty bad so it causes the servo to be jumpy. This code
    shifts the end of the pulse by the current value of the timer at the
    pulse start which means only the "turn off" interrupt is affected now.
    Thanks to Rob Burk for this clever fix!
    [grillpid.cpp]
2016-01-31 [hm] Rearrange code in ADC interrupt to optimize for speed
    Actually do the calculations for the previous set of reads while in the
    discard period of the next set of reads. Break the code up into chunks
    of roughly the same number of clock cycles.
2016-01-31 [hm] Reduce SERVO_MIN_THRESH to 5% of default servo range (down from 10%)
2016-01-31 [hm] BUG: Servo active ceil set with fan active floor value of no servo value specified
    [hmcore.cpp]
2016-02-03 [hm] Move servo immediately after a long idle period, even for small moves
2016-02-03 [hm] Stop PIDI from going negative when decreasing setpoint, preventing prolonged undershoot
    [grillpid.cpp]
2016-02-04 [lm] HeaterMeter 20160130B
2016-02-04 [lm] HeaterMeter firmware 20160203B
2016-02-20 [wrt] Use case insensitive compare for adding HTTP headers into the environment
2016-05-23 [lm] Fix configuration changes not "sticking" if no HeaterMeter is present on first boot
    avr-update returns an error if there is no HM attached so the uci-defailts script
    returns non-zero, which meant that OpenWrt will not remove the file and run it on
    every boot. This resets the wifi config along with some other settings every time.
2016-07-18 Arduino was mis-spelled. Corrected
2016-08-01 Add EPCOS100k and Semitec 104GT-2 steinhart coefficients
    These thermistors, commonly found in 3D printers, are commented out but
    can be manually used.
2016-08-01 Update to VS2015 and latest visual micro, Arduino 1.6.8
2016-08-01 [3d] Add HeaterMeter v4.3 case
    [fillet.scad, hm-case-43.scad]
2016-08-01 [3d] Update Pi connector offsets deeper in case, wider LCD hole
    [hm-case-43.scad]
2016-08-01 [3d] Added cube_fillet_chamfer (not used yet)
    This generates a cube with fileted vertical corners but chamfered top
    and bottoms
    [hm-case-43.scad]
2016-08-01 [eagle] HeaterMeter v4.3 Main and LCD
    v4.3.3 Release
    [HeaterMeterLCD.brd, HeaterMeterLCD.sch, HeaterMeterPI.brd, HeaterMeterPI.sch]
2016-08-01 [3d] Enlarge button recesses, power jack hole
    [hm-case-43.scad]
2016-08-02 [3d] Move power jack and ethernet jacks up slightly
    [hm-case-43.scad]
2016-08-02 [3d] Reformat case for Customizer
    [fillet.scad, hm-case-43.scad]
2016-08-03 [eagle] Actual HeaterMeter 4.3.3
    -- Boards were fabbed with 2mil stop mask, but incorrectly had 4mil in
    the board file
    -- Added 4mil cream mask fo solder stencil to match v4.2.4
    [HeaterMeterPI.brd]
2016-08-04 [3d] Case adjust end stop and extra around phole
    -- Raise the Pi endstop 1mm and shrink its length
    -- Add small relief around probe holes to account for filament
    accumulation
    -- Reduce locklip_p height by 0.1mm
    [hm-case-43.scad]
2016-09-09 [3d] Add small lips to front, left, and right sides to help with alignment
    Also changes meaning of lip_tip_clip in locklip_n to clip the top edge
    instead of the point
    [hm-case-43.scad]
2016-09-10 [hm] Greatly increase response of button input and disable input for 250ms after each event
    The ADC loop in grillpid samples 255 + 3 or 48 discard samples for each
    6 ADC inputs. Each sample is 0.105ms so 27.09ms per ADC or 162.54ms per
    loop. This high latency between button means a press can be missed,
    especially if it was being pressed during the 27ms poll of the button
    input (which would be discarded as a transition) so the button would
    have to be held at least 320ms to be detected.
    The new code polls the buttons for just 4 samples in between each of the
    other full-oversampling ADC readings. This creates a 27ms max latency
    between button polls and because the sampling period is only 0.42m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
    [grillpid.cpp, hmmenus.cpp, menus.cpp]
2016-09-10 [hm] Add a servo busywait define for more accurate servo pulse timing
    Currently not used but tested and working
2016-09-14 [hm] rf12 doesn't need a pullup on interrupt
2016-09-16 [3d] Add optional mouseears to the case corners
    [hm-case-43.scad]
2016-09-16 [3d] Remove unused nut function
    [hm-case-43.scad]
2016-09-19 [3d] Replace main cube fillet with new bead chamfer, round edges
    -- Gives a round edge all the way around top and bottom lip instead of
    pointy corners
    -- Fix nuttrap to not be a centered block, only go to wall (makes it
    0.25mm longer into case as well)
    [hm-case-43.scad]
2016-09-19 [3d] Fix a guide lips not always being attched to mesh
    [hm-case-43.scad]
2016-09-19 [3d] Add USB pillar reinforcements
    [hm-case-43.scad]
2016-09-19 [3d] Reduce wall thickness by 0.14mm
    [hm-case-43.scad]
2016-09-19 [3d] Extend USB pillar reinforcements top to bottom and make ends 1mm wider
    [hm-case-43.scad]
2016-09-19 [3d] One extended USB pillar was intersecting HM board
    [hm-case-43.scad]
2016-09-23 [3d] Fillet the case interior cube to create more thickness near top/bottom
    -- Also increase the radius and height of the outside bchamfer
    [hm-case-43.scad]
2016-09-23 [3d] Split case at two different heights to give more strength to USB pillars
    [hm-case-43.scad]
2016-09-23 [3d] Updated case STL file
    [hm-case-43.stl]
2016-09-25 [3d] Add case 'connectorless' option and fix A+ split in a weird place
    [hm-case-43.scad]
2016-09-30 [lm] Use sysfs GPIO to toggle reset line for hmdude, removes register use of bcm2835
    [hmdude.c]
2016-09-30 [www] Fix HTML compliance causing 'Save' button to not work
2016-09-30 [lm] Updates for OpenWrt Designated Driver / Pi 3
    -- Linkmeter now uses its own config file instead of lucid
    -- Linkmeter is standaone, no longer requires lucid host process
    -- Still much to do but up and running
2016-09-30 [wrt] Remove clearsilver fix, openssl heartbleed, brcm2708-firmware, hotplug patches
    -- clearsilver is no longer used by wrt
    -- openssl package is up to date with heartbleed fix
    -- brcm2708-firmware upstream now has my changes
    -- hotplug is current in trunk
2016-09-30 [lm] /boot is now automatically mounted by wrt
2016-09-30 [wrt] Remove spi-bcm2708, now included in platform modules.mk
2016-09-30 [lm] Remove SPI module after flashing because hmdude no longer resets the GPIO to input, causing LCD to stop working
2016-09-30 [wrt] Refresh bcm2708 tweaks for Designated Driver and RPi 3
2016-09-30 [lm] HeaterMeter 20169010B 24,146 bytes
2016-10-01 [wrt] Enable rtl8192cu firmware for rt8xxxx driver support (Edimax, etc)
2016-10-05 [3d] Remove mousears, add configurable body chamfer and walls now full 3mm
    [hm-case-43.scad]
2016-10-05 [wrt] Switch the LED to default-on rather than off/on at the end of boot. Seems to not turn on if was in the off state when trigger is set to none
2016-10-11 [3d] USB pillars fix for interferrence with Pi PCB, locklip_p thickness increase, others
    -- Pi PCB was interferring with the USB pillar reinforcements on the
    bottom
    -- Increase locklip_p bar thickness to WALL to allow a more solid fill
    -- Reduce top negative body inset chamfer, this didn't seem to make any
    difference in warping and takes longer / more material to print.
    -- Add vertical internal body corner fillets to the top two corners to
    let them get filled while printing. Bottom two need to be square still.
    -- Reduce length of front guide lip to prevent possible interference
    with mcu socket if overextruded.
    Body is 0.5mm deeper now (d = d + 0.5)
    [hm-case-43.scad]
2016-10-20 [lm] Add the ability to save PNG images of live graphs as well as download CSV as attachment
    Adds a /lm/dluri controller which takes a data URI as a parameter and spits it back as
    content-disposition attachment which prompts the user to save as. Also removes the PNG toggle
    on the archive page in leiu of using this new portable download method.
    This changes the graph to always use a canvas, not sure if that will have any side effects.
2016-10-20 [wrt] Switch curl to OpenSSL, remove polarssl, replace hostapd/wpas with wpad-mini
2016-10-20 [hm] Limit I-sum to startup fan speed during startup and lid recover
    I-sum is limited to 100 in normal operation
2016-11-17 [3d] Increase effective nut ingress width, locklip_p has inset, LCD block taper
    -- Nut ingress is now a sideways trapezoid so it starts wider and tapers
    in.
    -- Ingress width lowered 5.8->5.7mm
    -- Nut recess no longer offset 0.4mm, elongated the points 0.2mm each
    side
    -- Locklip_p now default inset is 0, only the insert is inset now to
    allow the base to extend all the way to the wall.
    -- Fix microsd being slightly off-center since the case was enlarged
    last rev
    -- The top of the LCD block is now fileted
    [hm-case-43.scad]
2016-11-17 [3d] Add readme and remove STL
    Use thingiverse to generate the STL if you don't have OpenSCAD
    [hm-case-43.stl]
2016-11-24 [3d] Reduce the size of the Pi right edge stop -0.5mm
    It makes the case a little more difficult to assemble if the Pi jams up
    on it
    [hm-case-43.scad]
2016-11-24 [3d] Move WALL from Advanced to normal options
    WALL should be set to some sort of multiple of extrusion trace width to
    prevent a hollow wall.
    [hm-case-43.scad]
2016-12-13 [3d] Extend top nuttrapp +e to be sure it is fully connected in the model
    [hm-case-43.scad]
2016-12-18 [3d] Remove edge stop and pi screws from Zero variant
    [hm-case-43.scad]
2016-12-22 [3d] Add a heatshield option to help trap heat
    [hm-case-43.scad]
2016-12-22 Revert "[3d] Add a heatshield option to help trap heat"
    This reverts commit 620e2271dc6e01db7f90105e22c5294c80951553.
    [hm-case-43.scad]
2016-12-26 [hm] Fix a few compiler warnings, remove extra B from version
    [bigchars.h, grillpid.cpp, hmcore.cpp, hmcore.h, hmmenus.cpp, strings.h]
2016-12-26 [hm] Fix WDT not disabling on gcc-4.9.2 (Atmel 3.5.3)
    .init3 section was not being included after Arduino 1.6.10. Much thanks
    to Andrew Fuller for discovering the GCC -flto cause.
    [heatermeter.ino]
2016-12-26 [hm] Remove PIN_SOFTRESET
    The WDT does all the resetting we need on all versions of HM hardware,
    the SOFTRESET line was redundant
    [hmcore.cpp, hmcore.h]
2016-12-28 [hm] Go back to traditional setup/loop functions
    Makes the code compatible with more variants of Arduino-compatible MCU
2016-12-30 [hm] HeaterMeter 20161230B 22,342 bytes
2016-12-30 [lm] Force disable of uhttpd HTTPS redirect which breaks the device manager
2017-03-21 [lm] Update Thermoworks probe coefficients with lab tested results
    Thanks to Tim P for using his Hart Scientific 24590T dry block Temperature calibration system
    to produce these new coefficients, which are more accurate at lower temperatures (100F and below)
2017-04-05 [wrt] Update patches to LEDE trunk
2017-04-05 [wrt] Update install and config for LEDE. Must now start initial build with make defconfig
2017-04-05 [lm] Update LinkMeter to support Zero W, LEDE
2017-04-08 [lm] Add un/registerTickListener to linkmeterd API, convert IP watch to use.
    Fixes HeaterMeters not showing in device list if their microcontrollers didn't flash for some reason
2017-04-09 [3d] Add option for no probe holes, mousears back, center model
    -- Adds a new Control_Probe = None which creates none of the 4 probe
    holes
    -- Readds MouseEarHeight. These do sort of work to help control ABS
    warp. Set to one layer height.
    -- Model is now centered straddling the X axis
    [hm-case-43.scad]
2017-04-09 [3D] Add probewrap probe spool model
    [probewrap.scad]
2017-04-09 [3D] Remove all connectors from 1A+, increase nuttrap height 0.2,
    [hm-case-43.scad]
2017-04-09 Ignore stl files in the 3D directory
2017-04-10 [3d] Expand the size of the LCD bezel inset by 1mm
    Move lcd_neg down 0.5mm and increase the size of the inset by 1mm. The
    LCD grab notch was kept in the same position allowing 0.5mm of vertical
    slop.
    [hm-case-43.scad]
2017-04-10 [3d] Decrease case default wall thickness 3.0m -> 2.5mm
    [hm-case-43.scad]
2017-04-11 [3d] Add zero mounting hole supports
    [hm-case-43.scad]
2017-04-11 [3d] Probe centerline moved up 0.3mm by math
    2.25 - mount support
    1.5? - Pi PCB thickness
    2.54 - male header black bit
    8.5 - female header
    -5.5 - probe jack
    = 9.29mm
    [hm-case-43.scad]
2017-04-13 [lm] Make apikey case-insensitive
2017-04-13 [lm] Broadcast over mDNS as HeaterMeter, not LinkMeter
2017-04-16 [3d] Pi mounting screw location now based on position from front wall instead of back
    [hm-case-43.scad]
2017-04-16 [3d] Return LCD screw holes to the case by request
    [hm-case-43.scad]
2017-04-16 [3d] Add option for no LCD/Buttons
    Ideally the size of the case would be reduced to the minimum size that
    would hold the appropriate stack, but the nuttrap on the top can't get
    any smaller
    [hm-case-43.scad]
2017-04-16 [hm] Buttons now checked 250ms after last detection instead of waiting after every state change
    Previously there would be a 250ms delay after every state change before
    we'd consider a button again, which is fine if pressing a button is what
    caused the state change.
    However on the home screen, there are timeouts occuring every second
    which counts as a state change. This locks out the user from pressing
    any button 1/4 of the time. This change now always looks at the button
    state regardless of when the last state transition occurred and only
    locks out changes for 250ms after a button detection (!= BUTTON_NONE).
    It has the side effect of delaying a timeout if a button is pressed but
    I don't th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
2017-04-16 [hm] Fix double update of home screen every second, remove unused state handlers
    [hmcore.cpp, hmmenus.cpp, hmmenus.h]
2017-04-16 [hm] HeaterMeter 20170415 22,324 bytes
2017-04-16 [3d] Remove a bit extra from the top of the probe holster
    [probewrap.scad]
2017-04-16 [hm] Update to Arduino 1.8
2017-04-16 [lm] HeaterMeter 20170415
2017-05-08 [lm] Fix light status page not rendering, rename Fan to Output
2017-05-08 [wrt] Switch LEDE target to v17.01.1 release
2017-05-13 [wrt] Update to latest LEDE (Linux 4.9.20)
2017-06-17 [www] Rename Internal probe type to Thermistor
2017-07-07 [lm] Add ability to do wifi config from a USB mass storage device, same config.txt method
2017-07-07 [lm] Switch linkmeterd to use procd init and register with umdns
2017-07-10 [lm] Oops, mass storage config.txt used incorrect mount path
2017-07-11 [wrt] Update git revision to current HEAD in installer
2017-07-22 [3d] Refactor to not use rotate_extrude(angle)
    [probewrap.scad]
2017-07-22 [hm] Fix possibility of being locked in startup mode when entering manual output mode
    Thanks Phillip P for finding this bug!
    [grillpid.cpp]
2017-07-22 [hm] ThermoWorks Pro-Series probe now the default
    Also update the ET-732 to match the webui
2017-07-22 [3d] Rearrange some stuff to make it clearer
    [hm-case-43.scad]
2017-07-22 [hm] Fix not able to disable alarm by pressing device button
    Thanks Kiaikai B for reporting
    [hmmenus.cpp]
2017-07-22 [3d] Fix screw head mismatch between screwhole and nuttrap
    The nuttrap() made a 6mm diameter 3.5mm deep hole and the screwhole()
    only created a 3mm deep hole so the outer edge was angled internally for
    0.5mm
    [hm-case-43.scad]
2017-07-22 [3d] Offset HeaterMeter slightly from front edge of case
    Guarantees at least one perimeter in front of front screw holes, as well
    as allowing a small gap before the PCB starts which should make assembly
    slightly easier and reduced chance of the front locklip intersecting the
    closest components.
    [hm-case-43.scad]
2017-07-22 [3d] Fix lip edge geometry not perfectly lining up on on side of probewrap
    The rounded portion of the lip at the 180 degree point wasn't flush with
    the flat lip on the stackable portions
    [probewrap.scad]
2017-07-22 [hm] Add menu button longpress support / PID disabled function
    Menus can now register for longpress actions by including which buttons
    support longpress in their state in the menu_definition_t::longpress
    field. Buttons which do not have longpress handlers in the current state
    execute on button down and can have repeat counts. If the button is
    pressed for less than the longpress duration, the regular button handler
    fires, else (button | BUTTON_LONG) fires. Can be on auto transitions or
    in state hander_t functions.
    This also includes a hander in the home menu for turning on / off PID
    output completely. Hey, I needed to test it! And fixes a couple minor
    bugs:
    -- Allow setpoints of just units w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
    [grillpid.cpp, grillpid.h, hmcore.cpp, hmmenus.cpp, menus.cpp, menus.h]
2017-07-24 [lm] Add HeaterMeter text to mDNS advertisement
2017-07-30 [hm] pid.setDisabled(true) now forces return to auto mode
2017-07-30 [hm] Fix alarms and lid mode triggering when disabled
    Also clears ringing status and prevents alarms from arming
    [grillpid.cpp]
2017-07-30 [lm] Make webui safe for U and - setpoint reporting from HeaterMeter
2017-07-30 [lm] Snapshot current HM configuration when doing a stash
    The configuration is stored in a json-formatted text file along side the stashdb. If present,
    the webui will display the json's stash.desc string on the list.
    Backups will now include these json files and they will be deleted if the stash rrd is deleted.
2017-08-22 [lm] Just a note to myself about where to set powersave
2017-08-22 [wrt] Switch from rtl8xxxu to rtl8192cu driver, enable uhttpd-lua
2017-08-30 [lm] HeaterMeter 20170730B
2017-08-30 [3d] Minor adjustments to screws and probe positions
    Refactored some offsets to use their real-world PCB locations
    -- HeaterMeter left jacks moved to front 0.17-0.25mm, d_off increased to
    0.8mm to compensate
    -- HeaterMeter right jacks moved to front 0.12mm
    -- Screws moved 0.165mm left, 0.31mm to front
    -- Added 1mm radius vertical chamfer to front left/right internal
    corners
    -- Pi mounting screws 0.2mm to back
    Relativity:
    -- Made the SD card edge and LCD block relative to front edge rather
    than back, allows resizing
    -- Fixed bottom nuttrap edge not being wide enough for full wall
    thickness
    [hm-case-43.scad]
2017-08-30 [3d] Fix USB pillar reinforcements for walls <2.0mm
    [hm-case-43.scad]
2017-08-30 [hm] Lock in HeaterMeter version
    20170730 - 22,736 bytes
2017-08-30 [3d] Increase front offset 0.8->1.0, move probes back 0.6mm, decrease pic_ex 2->1.7
    [hm-case-43.scad]
2017-10-06 [lm] Configure SMTP client to use heatermeter.com if no server is configured on install
2017-10-11 [hm] Only disable the servo when the PID is off
2017-10-11 [3d] Attempt at case keyholes (commented out)
    [hm-case-43.scad]
2017-11-02 [wrt] Update to LEDE head fbde9ac7
2017-11-02 [wrt] Add new SSDP responder hardcoded for HeaterMeter
2017-11-06 [ssdp] Recreate ssdp socket if IP_ADD_MEMBERSHIP fails, don't just crash
    The interface list changes but the socket is closed, so check every 10 seconds
    a new socket needs to be created.
    Also force a NOTIFY one second after startup rather than waiting the full timeout.
2017-11-06 [ssdp] Switch to recommended naming convention for SSDP description
2017-12-13 [hm] Replace eeprom_read/write_byte with AVR103 suggested implementation
    -- Creates less wear on EEPROM due to fewer erase cycles if not needed
    -- More reliable "config reset"
    -- Much faster, especially multibyte or block data
    [econfig.c, econfig.h]
2017-12-22 [eagle] HeaterMeter 4.3.4
    -- Base Board --
    Increase annular ring to 14mil (from 7)
    Increase thermal isolation to 15mil (from 10)
    Chamfer corners on front edge
    Rearrange power MOSFET footprint to sink more heat into board
    Add TC+/- indicators to thermocouple pins
    More direct path for 5V out and 12V in (swap D3 and R21)
    -- LCD Board --
    Add word "CONTRAST" by contrast pot
    Increase annular ring to 14mil (from 12)
    Increase thermals to 15mil (from 10)
    Redo LCD1M labels to match labels of MOSI/SCK/etc on main
    Add pin labels to shift register
    [HeaterMeterLCD.brd, HeaterMeterPI.brd, HeaterMeterPI.sch]
2018-01-01 [hm] Always output the control probe temperature in the Pit field in HMSU
2018-01-08 [www] Add control probe temperature to window title on home page
2018-01-08 [wrt] Add exFAT support and switch back to rtl8xxxx wifi
2018-01-24 [wrt] Fix for reading entirety of STDIN while trying to stream file through CGI boundary
    The uhttpd embedded LUA processor would read the entirety of an uploaded file when a single uhttpd.read()
    call was made. The code would read 1KB at a time and concatenate it over and over until it read the whole
    file (up to 29MB in our case). This would consume massive amounts of RAM and take a very long time
    causing Bad Gateway messages when the server timed out.
    The fix now only reads the requested amount so the file is streamed in 4KB chunks. Trying to get this
    integrated upstream, the patch location in install.sh is pretty hacky.
    Also added the 900 dnsmasq patch to the install for now.
2018-04-05 [3d] Move probe jacks back to calculated position, pi connector fix for v.thick walls
    Seems that maybe the probe jacks were 0.6mm too far forward? Also the Pi
    connectors wouldn't poke all the way through with a wall thickness of
    0.25"
    [hm-case-43.scad]
2018-04-05 [3d] Loosen mating tolerances on probewrap
    -- Increase space between stacks 0.75->1.25, increase height same amount
    to compensate
    -- Fix lip_poly_stack() interior top point being sloped by err_v amount
    -- Increase err_h to make the parts snap to gether easier
    -- Increase slop between stacks by 0.03mm (likely no change due to layer
    rounding)
    [probewrap.scad]
2018-04-05 [hm] Immediately update the status LEDs when using the buttons to enter/exit lid mode for faster feedback
2018-04-05 [3d] Adjust LCD down ~0.5mm
    The LCD is actually not centered on its PCB which I failed to recognize
    when doing the design. This adjusts its window properly and also sets
    its anchor based on the actual board layout. Overall this moves the
    entire LCD/Button/LED section closer to the front by about 0.5mm and
    seems to fit a little better.
    [hm-case-43.scad]
2018-04-05 [3d] Add option to generate the jig for led soldering
    [hm-case-43.scad]
2018-04-09 [hm] Prevent thermocouple from getting stuck at max high resolution temp
    When transitioning from high res to high temp, thermocuples could
    become wedged at max ADC around 450F and start reporting no pit probe.
    Thanks to Ralph Trimble and Matt Fine for insisting this was happening
    [grillpid.cpp]
2018-06-07 [avr] Just get the lmremote example to compile again
    I'm not sure this works at all any more but this is a little bit closer
    to working. The freerunning ADC used in heatermeter is incompatible with
    the single-conversion desired by lmremote and this would require changes
    to the GrillPid ADC vector that I don't want to mess with,
    [grillpid_conf.h, lmremote.ino]
2018-06-07 [hm] Add thermocouple non-linearity compensation
    Uses Table 3 from Analog Devices's AN-1087.
    0C-320C only. Subtract up to 1.0C at 140C and add 1.01C at 260C.
2018-06-24 [3d] Add 5 probe version of probewrap, smallerdefault wall
    -- wall lowered from 2.5 to 2.0, remember to keep this a multiple of
    trace width
    -- Added 5 probe layout
    [probewrap.scad]
2018-08-08 [eagle] LCD backpack v4
    -- Remove solder mask on edges of LED GND pins
    -- Enlarge pot pin width 0.05 -> 0.07
    -- Silence schematic warning about 5V pin overlap
    [HeaterMeterLCD.brd, HeaterMeterLCD.sch]
2018-08-08 [hm] First pass at Proportional on Measurement PID
    Based on concept from #42
    http://brettbeauregard.com/blog/2017/06/introducing-proportional-on-measurement/
    Don't tell anyone I think but this is a really silly concept!
2018-08-11 [hm] Replace PonM with linear combination of PonM and PonE
    A negative Kp will switch to using a mixed proportional contribution
    from both Measurement and Error, using a fixed 0.4 lambda for now.
    [grillpid.cpp, grillpid_conf.h]
2018-11-29 [3d] Make nuttraps less round on nut opening side for less overhang
    [hm-case-43.scad]
2018-11-29 [3d] Add support for 3A+
    Just a mix of 3B+ and Zero configs.
    USB port is NOT accessible from the outside.
    [hm-case-43.scad]
2018-11-29 [3d] Change body_corner_radius to be a function of wall dimension
    Should provide a more consistent thickness in the corners
    [hm-case-43.scad]
2018-11-29 [3d] Case LCD pins cutout isn't needed
    The LCD pins aren't even as long as the shift register pins are!
    [hm-case-43.scad]
2019-01-08 [hm] Fix for never getting out of startup mode if lid timer is the same as LIDOPEN_MIN_AUTORESUME
    [grillpid.cpp]
2019-02-17 [3d] Increased case height from 32mm to 32.5m, other tweaks
    -- Increase case depth 1.0mm
    -- Increase size of bottom wall chamfer to match pi mounting holes
    -- Reduce size of top wall chamfer to match bottom
    -- Pi Ethernet jack down 0.5mm
    -- HeaterMeter output RJ45 up 0.6mm, 0.3mm thinner
    -- Barrel power jack up 0.8mm
    -- Thermocouple jack up 0.3mm
    -- Thermocouple +/- up 1mm
    -- Reduce size of nuttrap nut diameter by <0.01mm
    -- Reduce button inset 0.25mm
    -- Enable small Pi alignment nubs
    [hm-case-43.scad]
2019-03-28 [hm] Refactor of Menu system and LCD to move things out of hmcore
    Massive amount of changes, mostly to support having more than one
    "dynamic" menu display in addition to the home screen.
    -- Exiting from Alarm Ringing state now returns to previous menu instead of home
    -- Fixes LONG menu transitions firing on their non-LONG buttons if there's not also a non-LONG transition
    -- HeaterMeter 20190327B 24,052 bytes
    [grillpid.cpp, grillpid.h, grillpid_conf.h, hmcore.cpp, hmcore.h, hmmenus.cpp, hmmenus.h, menus.cpp]
2019-03-29 [hm] Fix typo that broke compile
    [tone_4khz.cpp]
2019-03-29 [hm] Add Button, FanFeedback, and Bandgap to probe diag
    This adds over 222 bytes to the firmware and is a candidate for removal
    when space becomes an issue.
    Also ADC=ADB if probe is on bandgap scale
    [hmmenus.cpp]
2019-03-29 [hm] When leaving bandgap, probe now goes offline if close to max ADC
    Actually adds the noise value (shifted up to TEMP_OVERSAMPLE_BITS)
    and if that is within 1LSB of max, set to TSTATUS_NONE
    [grillpid.cpp]
2019-03-29 [hm] Fix overflow in adcToFeedvolt displaying incorrect fan voltage
    haha 90 * 33 * 255 = 757350, come on Bryan.
    This can be changed to return ((R1 + R2) * 33U / R1) * adc / 255U;
    Since R1 + R2 * 33 / R1 = a whole number but the size is the same
    so let's just leave it working for the generic case
    [hmmenus.cpp]
2019-04-18 [hm] Fix LCD backlight visually resetting when being changed through the menu
    [hmcore.cpp]
2019-04-18 [3d] Adjust interior fillet to round, make Pi ethernet hole tighter, USB pillar wider
    -- USB pillar width 2.0mm -> 2.2mm
    -- Interior fillet from 1mm chamfer to body_corner_radius/2 round
    -- Don't cut out pic_ex and then rebuild it, just cut less (makes Pi ethernet jack area smaller)
    [hm-case-43.scad]
2019-04-18 [hm] Default wall=2.0mm, wall_t=1.45mm
    [hm-case-43.scad]
2019-04-30 [3d] Add unused mouselegs option
    [hm-case-43.scad]
2019-06-18 [3d] Add option for mouselegs
    [hm-case-43.scad]
2019-07-26 [www] Clicking on the PID output bar now toggles PID internals display
2019-07-26 [hm] Allow probe offset +/-32,000 and allow down to -100C temperatures
    Attempts to migrate the old offset into the new field and clear the old offset value as well.
2019-08-14 [3d] Move LCD/buttons/LEDs 0.695mm to right, etc
    -- Most LCD didn't include 0.025in offset. Seems like it could need more?
    -- Remove Pi alignment nubbies
    -- Expand Pi ethernet jack cutout interior 0.5mm
    [hm-case-43.scad]
2019-12-26 [3d] Add threaded insert support in addition to captive nuts
    Also maybe fix weird STL generation cause by intersection volumes when splitting halves?
    [hm-case-43.scad]
2019-12-26 [hm] Long PWM mode now has high resolution
    Previously the fan turn off time was tied to the PID update period. when running in Long PWM mode (min fan speed > 0). Now the fan should turn off with roughly full precision even partially through the TEMP_MEASURE_PERIOD.
2019-12-26 [hm] Fix long PWM reenabling mid-period and allow fan boost to be disabled
    The lowerbound on Long PWM output duration was being limited by the fan boost when turning on at the beginning of each period. Set TEMP_OUTADJUST_CNT to 0 to allow lower than one TEMP_OUTADJUST_CNT period.
    [grillpid.cpp, grillpid_conf.h]
2020-01-07 [www] Add Inkbird IBT-2X, IBT-4XS, IBT-6X probe preset and arrange order
2020-01-07 [www] Alow clicking noise icon to enable dump, clean up noise buttons style
2020-01-07 [hm] Noisedump now always built in
    [grillpid.cpp, grillpid.h, hmcore.cpp, strings.h]
2020-01-12 [hm] Delay noisedump if ADC is currently reading that probe
    [grillpid.cpp]
2020-01-20 [hm] Report noisedump one cycle after pin number is set to imrpove response time
    [grillpid.cpp, grillpid.h, grillpid_conf.h, hmcore.cpp, strings.h]
2020-02-09 [hm] Add ServoPercent to HMSU sentence
2020-02-09 [www] Show only whole ADC numbers on noisegraph
2020-02-09 [lm/www] Add support for fanpct and servopct from HMSU updates
    Database will have to be restarted to store the new values,
    but linkmeterd and the webui should be tolerant of both running
    an old AVR firmware with fewer fields, and displaying databases
    that do not have the f and s fields.
    The home page also now shows Fan and Blower speed as text in the
    Output bar, but only if they are different from the Output percent.
2020-02-09 [www] Change Show fan speed checkbox to allow selecting of which output is shown in the graph
2020-02-09 [www] Fix graph tooltip appearing under Fan speed in Output bar
2020-02-13 [www] Add icon to home page to indicate if alarm is active on that probe, can click to silence
2020-02-15 [www] Fix improper probe colors in archive view
2020-03-26 [lm] HeaterMeter 20200210B
2020-03-29 [www] Option to show both Fan and Servo output on home screen
2020-04-01 [3d] Add slopes to the threaded insert opening
    [hm-case-43.scad]
2020-04-01 [hm] Allow servo ranges to be reversed
    [grillpid.cpp]
2020-04-01 [hm] Fix comment in mappct
    [grillpid.cpp]
2020-04-01 [hm] Add support for HostInteractive LCD, and LCD character bank switching
2020-06-28 [wrt] Update ca-certificates to fix heateremeter.com SSL error
2020-07-15 [3d] Make end piece snap hole slightly undersized for a tighter fit
    [probewrap.scad]
2020-07-15 [hm] Beep when entering the debug menu nom-probe item
2020-07-15 [3d] Add Zero extra lip, extend bottom screw head diameter into chamfer
    Also cuts out some of the material on the botom screw bridging area
    [hm-case-43.scad]
2020-07-15 [3d] Add simple plate Big Green Egg fan adapter
2020-07-15 [hm] Fix ADC dump reporting too many readings for the button pin
    [grillpid.cpp, hmmenus.cpp]
2020-07-17 [www] Add a Reboot AVR button to the config noconf template, move iframe out of has-config template section
2020-08-03 [lm/www] Change Ramp Mode to use one or more probes averaged together
2020-08-19 [3d] Change LED holes to be small pillars
    [hm-case-43.scad]
2020-09-05 [3d] Fix convexity of locklip_p, extend all the way to edge now, add more front tabs
    [hm-case-43.scad]
2020-10-09 [hm] Differential encode noisedump and send with new HMND sentence. Also removes 250ms pause in ADC reads while sending by just disabling noisedump during transfer
    [grillpid.cpp]
2020-10-09 [lm] Add hmlive device registration result to NETINFO menu
2020-10-13 [lm] HeaterMeter 20101009 25,458 bytes
2020-11-18 [hm] Reset pit TemperatureAvg when changing units to prevent D term going bonkers due to the value changing
    [grillpid.cpp, grillpid.h]
2020-11-20 [hm] Report the PID units when changed via HMPC
2020-11-20 [lm] Reset entire peak tracking state if the pit probe is unplugged
2020-11-20 [lm] Scale peak detector thresholds by PID units and Setpoint
2020-11-20 [lm] HeaterMeter 20201120B 25,496 bytes
2020-11-23 [lm] Request retransmit for missing /config items
    Track the config segments received and request retransmit if some are missing and it has been
    more than 2 seconds since the last segment containing a config item was received
    Also do not call pluginStatusListeners until the entire configuration has been received successfully.
    pluginSegmentListeners, hostInteractiveListeners, tickListeners are still called so host
    interactive and network checking can still take place.
2020-12-18 [lm] Dont LidTrack in manual output mode. Fixes crash when switching to manual
2020-12-18 [www] Config page changes to add lidtrack_enabled and better setpoint support
    Changed a few things with apikey, pretty print mV/C display, simplify a little of the oflags logic
2021-01-14 [hm] Arduino 1.8.12
2021-01-14 [3d] Add new Threaded Insert NutHardware 4.3mm diameter
    [hm-case-43.scad]
2021-02-01 [hm] Fix missing Reset Config LCD menu item and skipping most the menu if network not connected
    [hmmenus.cpp, strings.h]
2021-02-01 [hmc] Adding HeaterMeterClient Arduino library
2021-02-04 [3d] Add MeterMonitor 3d model
    [MeterMonitor.scad]
2021-02-04 [3d] Update readme with MeterMonitor and Probespool links
2021-02-04 [mm] Add wiring to README
2021-02-05 [mm/hmc] Fix line endings back to LF
    [segment_chars.h]
2021-02-05 [mm] Switch to LidCountdown display if active
2021-02-05 [hmc] Update HeaterMeterClient examples to use discovery
2021-02-16 [mm] Fix wrong pin for Probe3 in README
2021-02-16 [mm] Update readme with parts list and schematic
2021-02-17 [eagle] Add KiCad files for v4.3.5
    [HeaterMeterLCD.kicad_pcb, HeaterMeterLCD.sch, HeaterMeterPI.kicad_pcb, HeaterMeterPI.sch]
2021-02-19 [mm] Add link to 3D printed case
2021-02-23 [mm] Add capacitor info to readme
2021-02-23 [3d] Add support for 0.36inch LED displays to MeterMonitor
    [MeterMonitor.scad]
2021-02-25 [smushi] Paint optimization, button swaps, sleep mode
    -- Only paint Output and Setpoint boxes if data has changed
    -- Move ROTATE to left button, hold down to enter Power Down mode (<1mA)
    -- Have to hold right button now to use compiled wifi credentials
    will use last credentials otherwise
    [SMUSHI.ino]
2021-04-09 [lm] HeaterMetter 20210201B 25,364 bytes
2021-05-24 [mm] Update disconnected display on connect failure to show err
    [MeterMonitor.ino]
2021-05-24 [3d] Increase case front offset to 2.0mm
    [hm-case-43.scad]
2021-05-24 [hmc] Use 32bit time_t
    The update time is actually UNIX epoch and the time_t
    is 64-bit in ESP8266 3.0.0 so arduinojson was erroring.
2021-05-24 [mm] Fix memory leak when writing letters to display
    [MeterMonitor.ino]
2021-06-25 [smushi] Fix compilation error about time_t
    -- Adds some extra logging info to wificonnect and updatedisplay
    [SMUSHI.ino]
2021-06-25 [3d] Change default NutHardware to Threaded Insert
    [hm-case-43.scad]
2021-07-01 [eagle] HeaterMeter Base v4.3.6
    * Replace probe jacks with CUI MU1-2503A
    * Thermocouple PCC-SMP-K get plated slots instead of hole
    * Reduce size of RJ45 jack mounting holes for snapier fit
    * Capacitors 100u/10V, 47u/25V footprint replaced with 2.0mm lead spacing
    * Board slightly enlarged on top edge to fit jacks
    * Thermocouple amp SMD layout revised to fit around jack
    * PROBE pinheader moved to fit around jacks
    [HeaterMeterPI.kicad_pcb]
2021-07-02 [3d] Add ThermistorJack option for 4.3.6 PCB
    [hm-case-43.scad]
2021-09-23 [3d] Increase led_fudge 0.3 -> 0.4
    [hm-case-43.scad]
2021-10-20 [mm] Initial wifi config via WifiManager AP now
    -- Button on D4 held for 1s will reset the config
    [MeterMonitor.ino, button.h, segment_chars.h]
2021-10-20 [3d] MeterMonitor increase lid corner tolerence
    [MeterMonitor.scad]
2021-10-20 [mm] Update project with button/readme
